uibk-dps-teaching/cluster-coffer/README.md

# Cluster Coffer

See [manual](docs/cluster-coffer.pdf).

See extra fancy [3D PDF](hardware/main-3d.pdf) that works only with Adobe Reader / Acrobat.

Coffer
