uibk-dps-teaching/cluster-coffer/docs/gallery.tex

\chapter{Gallery}

\begin{figure}
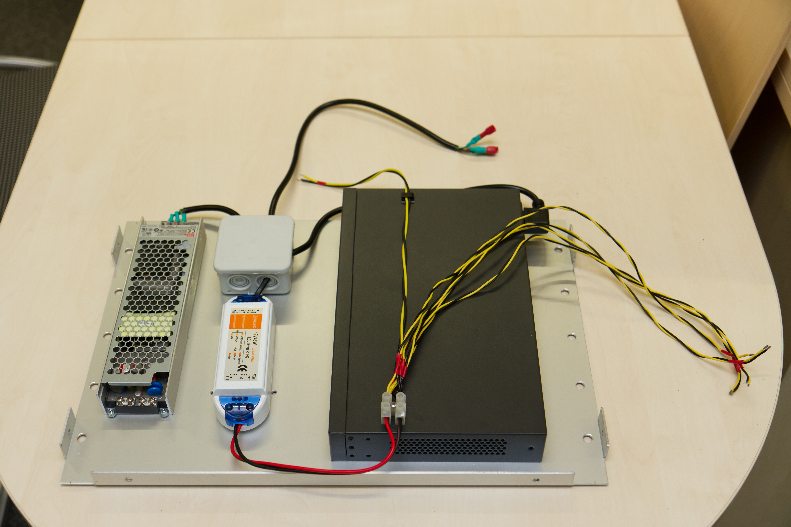
[picture p1: docs/inc/img_9750.jpg]
	
	\caption{Assembled base-plate.}
\end{figure}

\begin{figure}
	
	\caption{Two assembled V-Mount panels.}
\end{figure}

\begin{figure}
	
	\caption{Case backside with plug and switch.}
\end{figure}

\begin{figure}
	
	\caption{Case internals with head node.}
\end{figure}

\begin{figure}
	
	\caption{Assembled V-Mount panels, frame, and base-plate.}
\end{figure}

\begin{figure}
	
	\caption{Fully assembled system.}
\end{figure}
