uibk-dps-teaching/cluster-coffer/docs/inc/drawing_frame_front_nuts.pdf

# Front

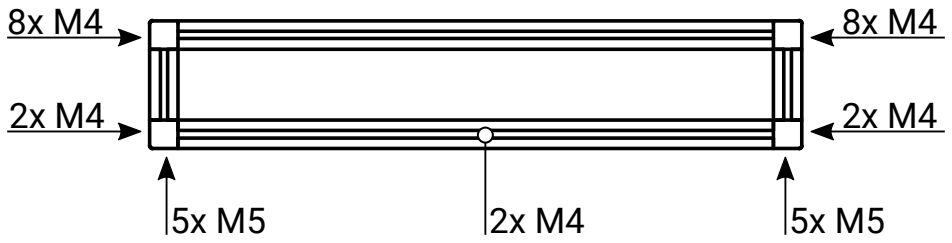
[picture p2: figure]
