uibk-dps-teaching/cluster-coffer/hardware/nanopc_t4/2d/nanopc_t4_bottom.jpg

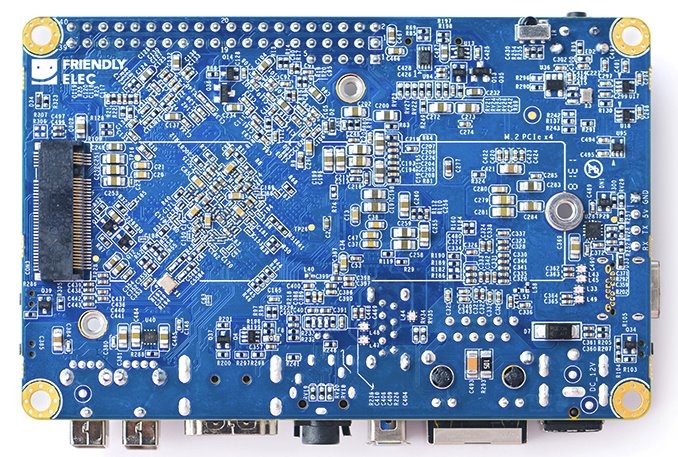
hardware/nanopc_t4/2d/nanopc_t4_bottom.jpg
