uibk-dps-teaching/cluster-coffer/hardware/nanopc_t4/3d/nanopc_t4_bottom_texture.jpg

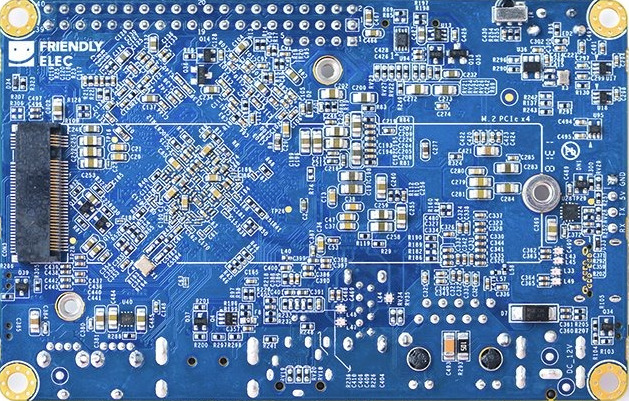
hardware/nanopc_t4/3d/nanopc_t4_bottom_texture.jpg
