uibk-dps-teaching/cluster-coffer/hardware/nanopi_m4/2d/nanopi_m4_bottom.jpg

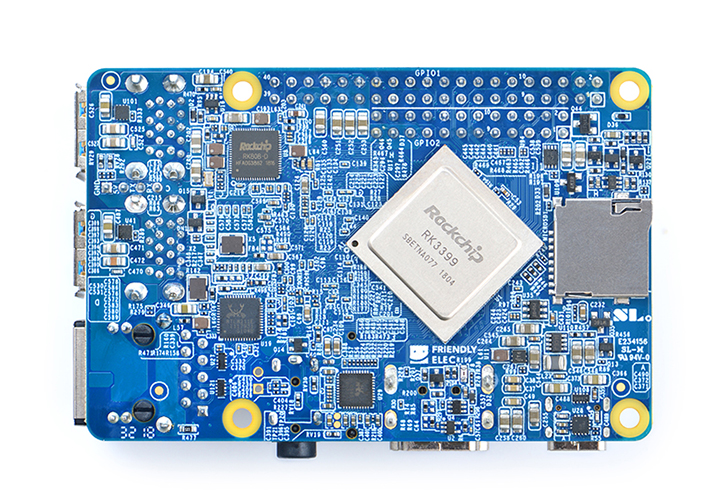
hardware/nanopi_m4/2d/nanopi_m4_bottom.jpg
