uibk-dps-teaching/cluster-coffer/hardware/nanopi_m4/3d/nanopi_m4_bottom_texture.jpg

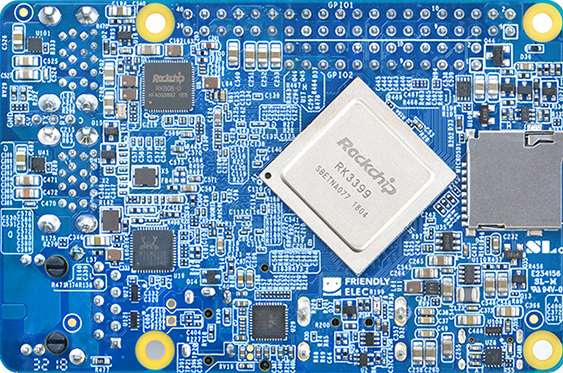
hardware/nanopi_m4/3d/nanopi_m4_bottom_texture.jpg
