uibk-dps-teaching/cluster-coffer/hardware/nanopi_m4/3d/nanopi_m4_top_texture.jpg

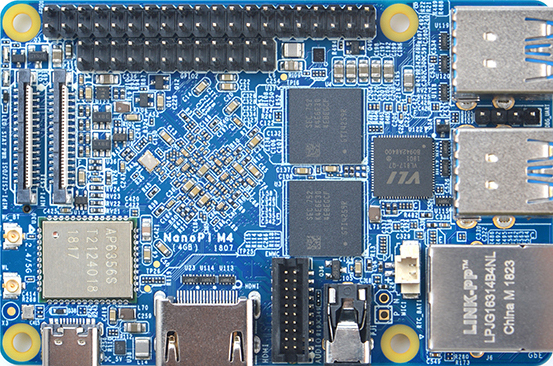
hardware/nanopi_m4/3d/nanopi_m4_top_texture.jpg
