uibk-dps-teaching/cluster-coffer/hardware/nanopi_m4/nanopi_m4_dimensions.png

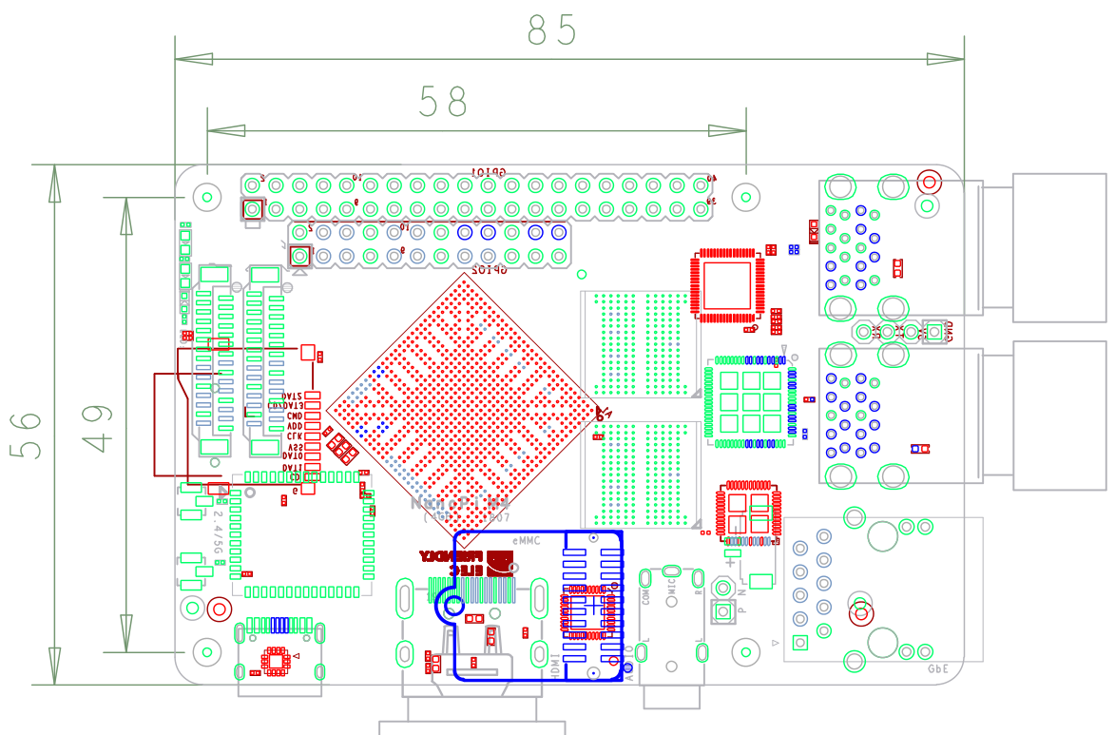
hardware/nanopi_m4/nanopi_m4_dimensions.png
