uibk-dps-teaching/cluster-coffer/hardware/tl_sg1024/2d/tl_sg1024_front.jpg

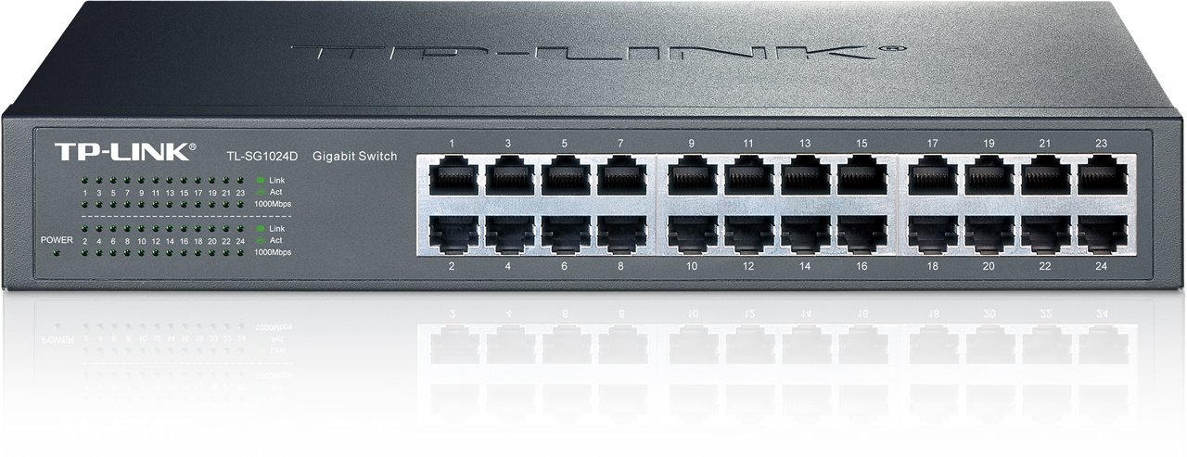
hardware/tl_sg1024/2d/tl_sg1024_front.jpg
