uibk-dps-teaching/cluster-coffer/hardware/tl_sg1024/3d/tl_sg1024_front_texture.jpg

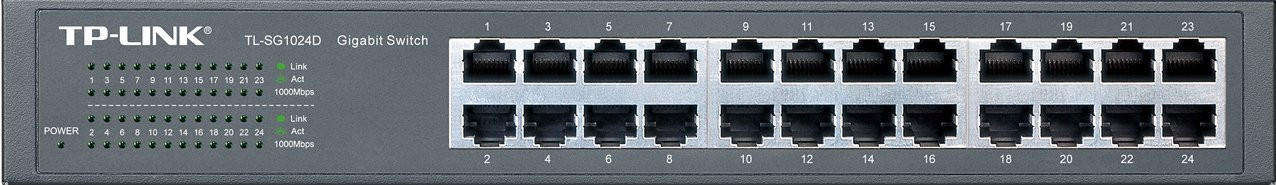
hardware/tl_sg1024/3d/tl_sg1024_front_texture.jpg
