uibk-dps-teaching/cluster-coffer/docs/bom.tex

\chapter{Bill of Materials}
\label{bom}

The following table contains material required for this build.
Minor items (e.g.\ cable ties, screws) and custom made components are omitted.
Prices are approximated.

\begin{center}
\begin{longtable}{llrr}
	\toprule
	\multicolumn{2}{l}{\textbf{Item}} & \textbf{Count} & \textbf{Price (single) €}\\

	\midrule
	\multicolumn{2}{l}{Head Node}\\
	& NanoPC T4 & 1 & 95.00\\
	& Akasa AK-210 Blue Lights Northbridge Kühler & 1 & 10.00\\
	& Akasa AK-TT12-80 Wärmeleitfolie & 1 & 10.00\\
	& Micro SD Card 16GB & 1 & 4.00\\
	& Cat 7 Ethernet Cable 0.50m & 1 & 1.80\\

	\midrule
	\multicolumn{2}{l}{Compute Nodes}\\
	& NanoPI M4 2GB & 16 & 65.00\\
	& NanoPI M4 Heatsink & 16 & 5.00\\
	& Micro SD Card 16GB & 16 & 4.00\\
	& 40mm Fan (12V, 3 Pin Connector) & 16 & 6.00\\
	& Cat 7 Ethernet Cable 0.25m & 8 & 1.60\\
	& Cat 7 Ethernet Cable 0.50m & 8 & 1.80\\

	\midrule
	\multicolumn{2}{l}{Switch}\\
	& TP-Link TL-SG1024D & 1 & 70.00\\

	\midrule
	\multicolumn{2}{l}{Power}\\
	& AC Switching Power Supply 5V 300W & 1 & 60.00\\
	& AC Switching Power Supply 12V 48W & 1 & 8.00\\
	& Mains Power Socket Connector (with Switch and Fuse) & 1 & 5.00\\

	\midrule
	\multicolumn{2}{l}{Frame}\\
	& HFS5 2020 420mm (both ends tapped) & 2 & 6.00\\
	& HFS5 2020 280mm (both ends tapped) & 4 & 6.00\\
	& HFS5 2020 50mm (both ends tapped) & 4 & 6.00\\
	& HNUT5-4 M4 Nut (with spring) & 22 & 0.50\\
	& HNUT5-5 M5 Nut (with spring) & 10 & 0.50\\
	& HBLCS5-B Edge Connector 2-Way & 4 & 4.00\\
	& HBLCR5-B Edge Connector 3-Way & 4 & 4.00\\

	\midrule
	\multicolumn{2}{l}{Case}\\
	& Aluminium Suitcase (inner dimensions $486 \times 346 \times 195$ mm) & 1 & 80.00\\

	\bottomrule
\end{longtable}
\end{center}
