uibk-dps-teaching/cluster-coffer/hardware/nanopc_t4/nanopc_t4_pcb.dxf

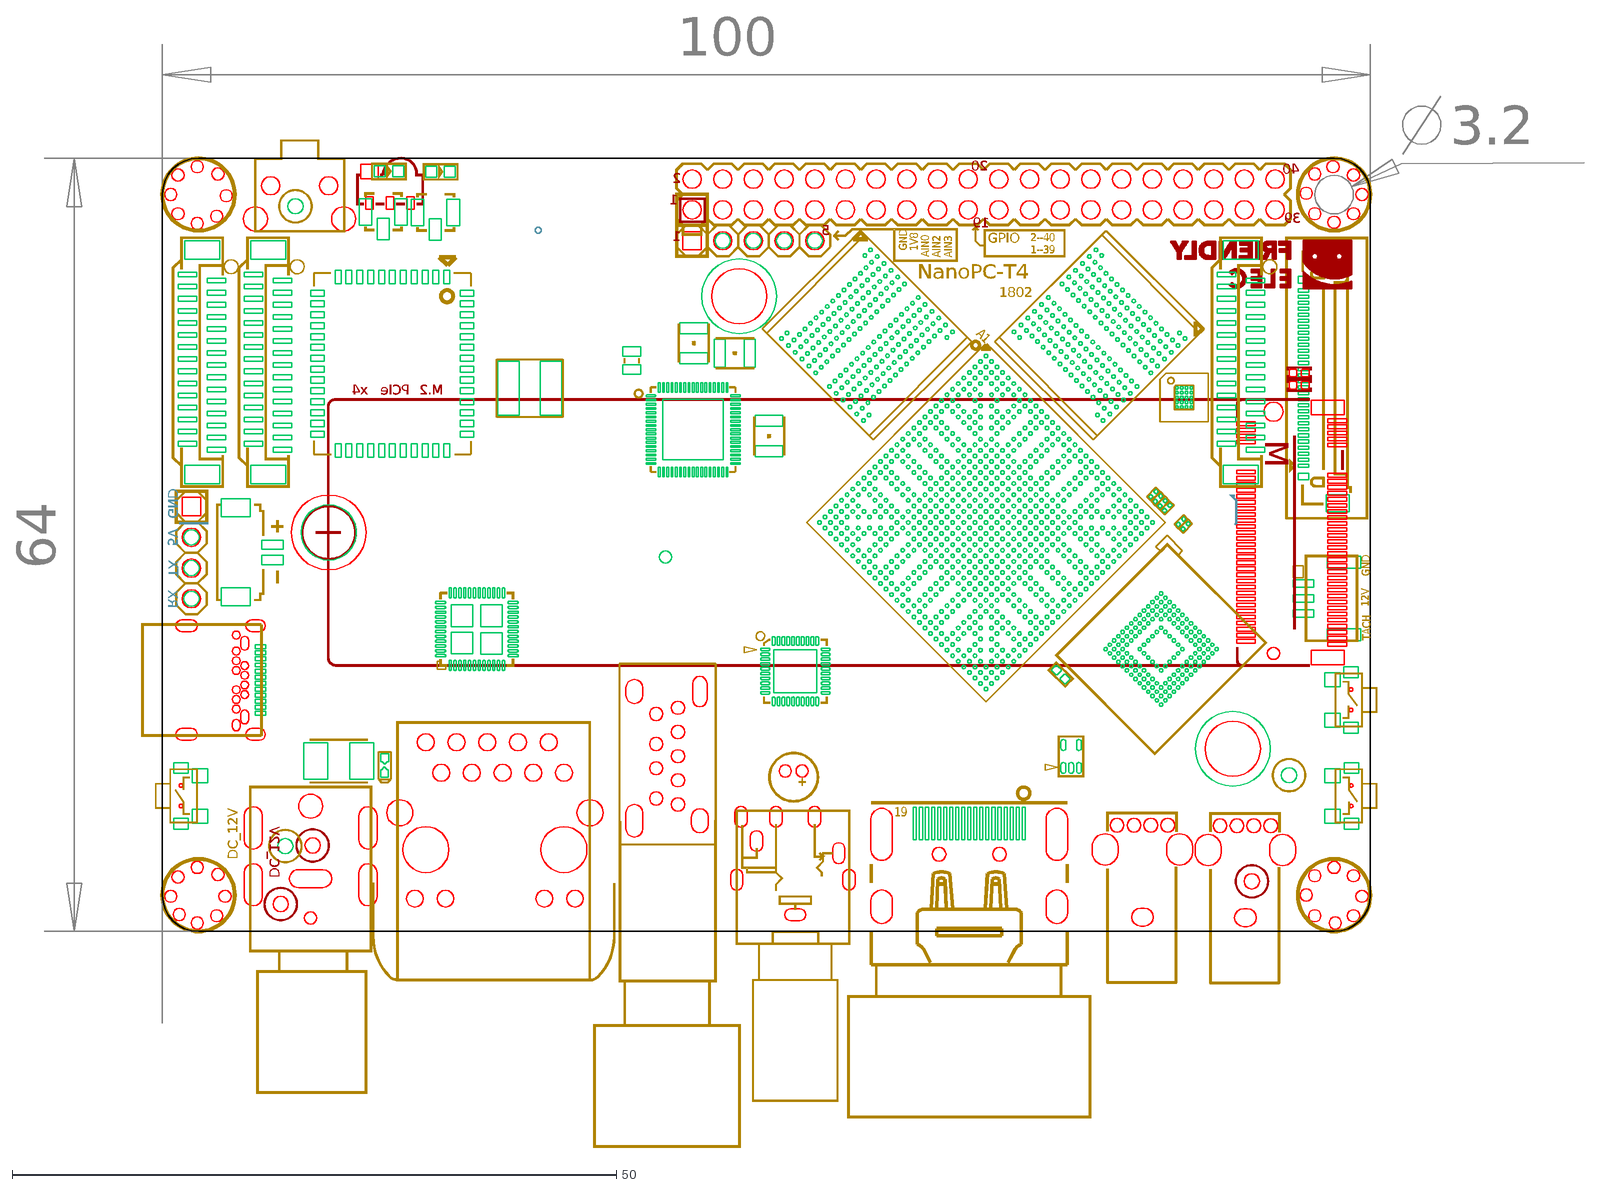
[picture p15: CAD file, 2020-08-14]
hardware/nanopc_t4/nanopc_t4_pcb.dxf
3.2
M
64
100
19
A1
AIN3
AIN2
AIN0
1V8
GND
TACH
12V
DC_12V
x4
M.2
PCIe
1--39
2--40
GPIO
5
20
1
40
39
2
RX
TX
5V
1802
NanoPC-T4
