uibk-dps-teaching/cluster-coffer/hardware/nanopi_m4/nanopi_m4_pcb.dxf

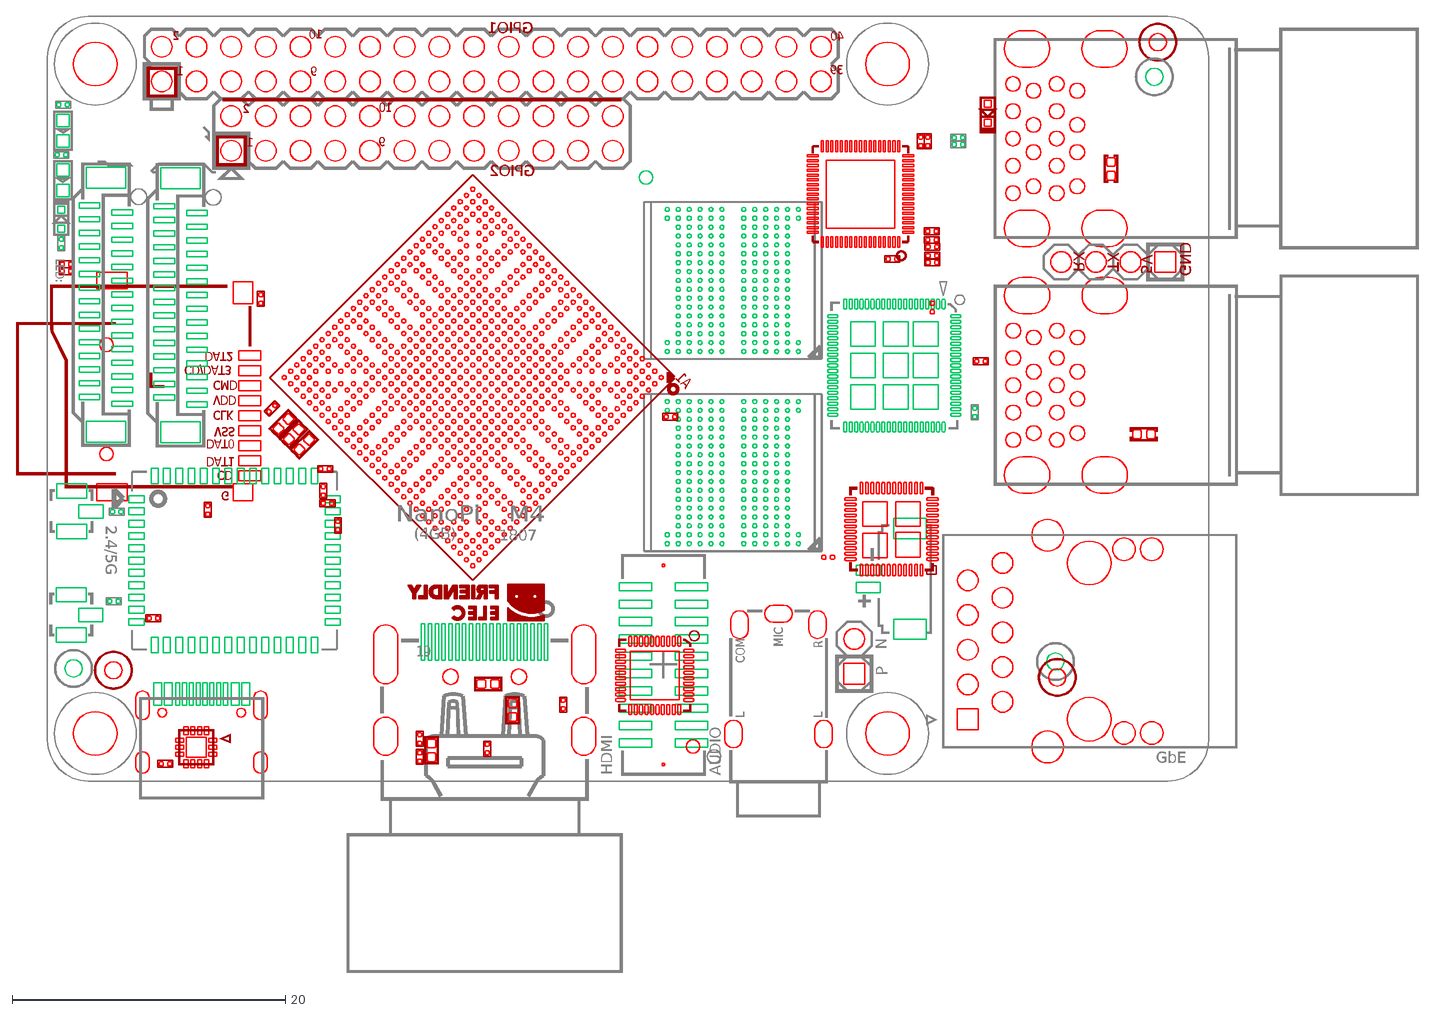
[picture p16: CAD file, 2020-08-14]
hardware/nanopi_m4/nanopi_m4_pcb.dxf
DAT2
CD/DAT3
CMD
VDD
CLK
VSS
DAT0
DAT1
CD
G
19
A1
L
R
COM
MIC
N
P
(4GB)
39
40
10
9
GPIO2
GPIO1
2
1
2.4/5G
LED:
M4
1807
NanoPi
V
RX
TX
5
GND
HDMI
GbE
AUDIO
