uibk-dps-teaching/cluster-coffer/(list of files, cad)

Other CAD files:
docs/inc/drawing_frame.idw
hardware/12v_psu.ipt
hardware/5v_psu.ipt
hardware/base.iam
hardware/base_plate.idw
hardware/base_plate.ipt
hardware/ccpdu.ipt
hardware/components/pcb_switch.ipt
hardware/frame.iam
hardware/frame/8020 Metric 00000001.ipt
hardware/frame/8020 Metric 00000002.ipt
hardware/frame/8020 Metric 00000003.ipt
hardware/frame/8020 Metric 00000004.ipt
hardware/frame/8020 Metric 00000005.ipt
hardware/frame/8020 Metric 00000006.ipt
hardware/frame/8020 Metric 00000007.ipt
hardware/frame/8020 Metric 00000008.ipt
hardware/frame/8020 Metric 00000009.ipt
hardware/frame/8020 Metric 00000010.ipt
hardware/frame/8020 Metric 00000011.ipt
hardware/frame/8020 Metric 00000012.ipt
hardware/frame/Frame0001.iam
hardware/frame/Skeleton0001.ipt
hardware/frame/boundingbox.ipt
hardware/frame/corner.ipt
hardware/main.iam
hardware/nanopc_t4/3d/nanopc_t4.iam
hardware/nanopc_t4/3d/nanopc_t4.skp
hardware/nanopc_t4/3d/nanopc_t4_board.ipt
hardware/nanopc_t4/3d/nanopc_t4_cover.ipt
hardware/nanopc_t4/3d/nanopc_t4_hdmi.ipt
hardware/nanopc_t4/3d/nanopc_t4_headphone.ipt
hardware/nanopc_t4/3d/nanopc_t4_pin.ipt
hardware/nanopc_t4/3d/nanopc_t4_pwr.ipt
hardware/nanopc_t4/3d/nanopc_t4_rj45.ipt
hardware/nanopc_t4/3d/nanopc_t4_spacer_long.ipt
hardware/nanopc_t4/3d/nanopc_t4_usb.ipt
hardware/nanopc_t4/3d/nanopc_t4_usb3.ipt
hardware/nanopc_t4/3d/nanopc_t4_usb3c.ipt
hardware/nanopi_m4/3d/ccpad.ipt
hardware/nanopi_m4/3d/nanopi_m4.iam
hardware/nanopi_m4/3d/nanopi_m4_board.ipt
hardware/nanopi_m4/3d/nanopi_m4_hdmi.ipt
hardware/nanopi_m4/3d/nanopi_m4_headphone.ipt
hardware/nanopi_m4/3d/nanopi_m4_heatsink.ipt
hardware/nanopi_m4/3d/nanopi_m4_pin.ipt
hardware/nanopi_m4/3d/nanopi_m4_rj45.ipt
hardware/nanopi_m4/3d/nanopi_m4_usb.ipt
hardware/nanopi_m4/3d/nanopi_m4_usb3c.ipt
hardware/power_conduit_box.ipt
hardware/rack.iam
hardware/tl_sg1024/3d/tl_sg1024.ipt
hardware/tl_sg1024/3d/tl_sg1024.skp
hardware/v_mount.idw
hardware/v_mount.ipt
