uibk-dps-teaching/cluster-coffer/hardware/nanopc_t4/nanopc_t4_schematic.pdf

# NanoPC T4

# Revision

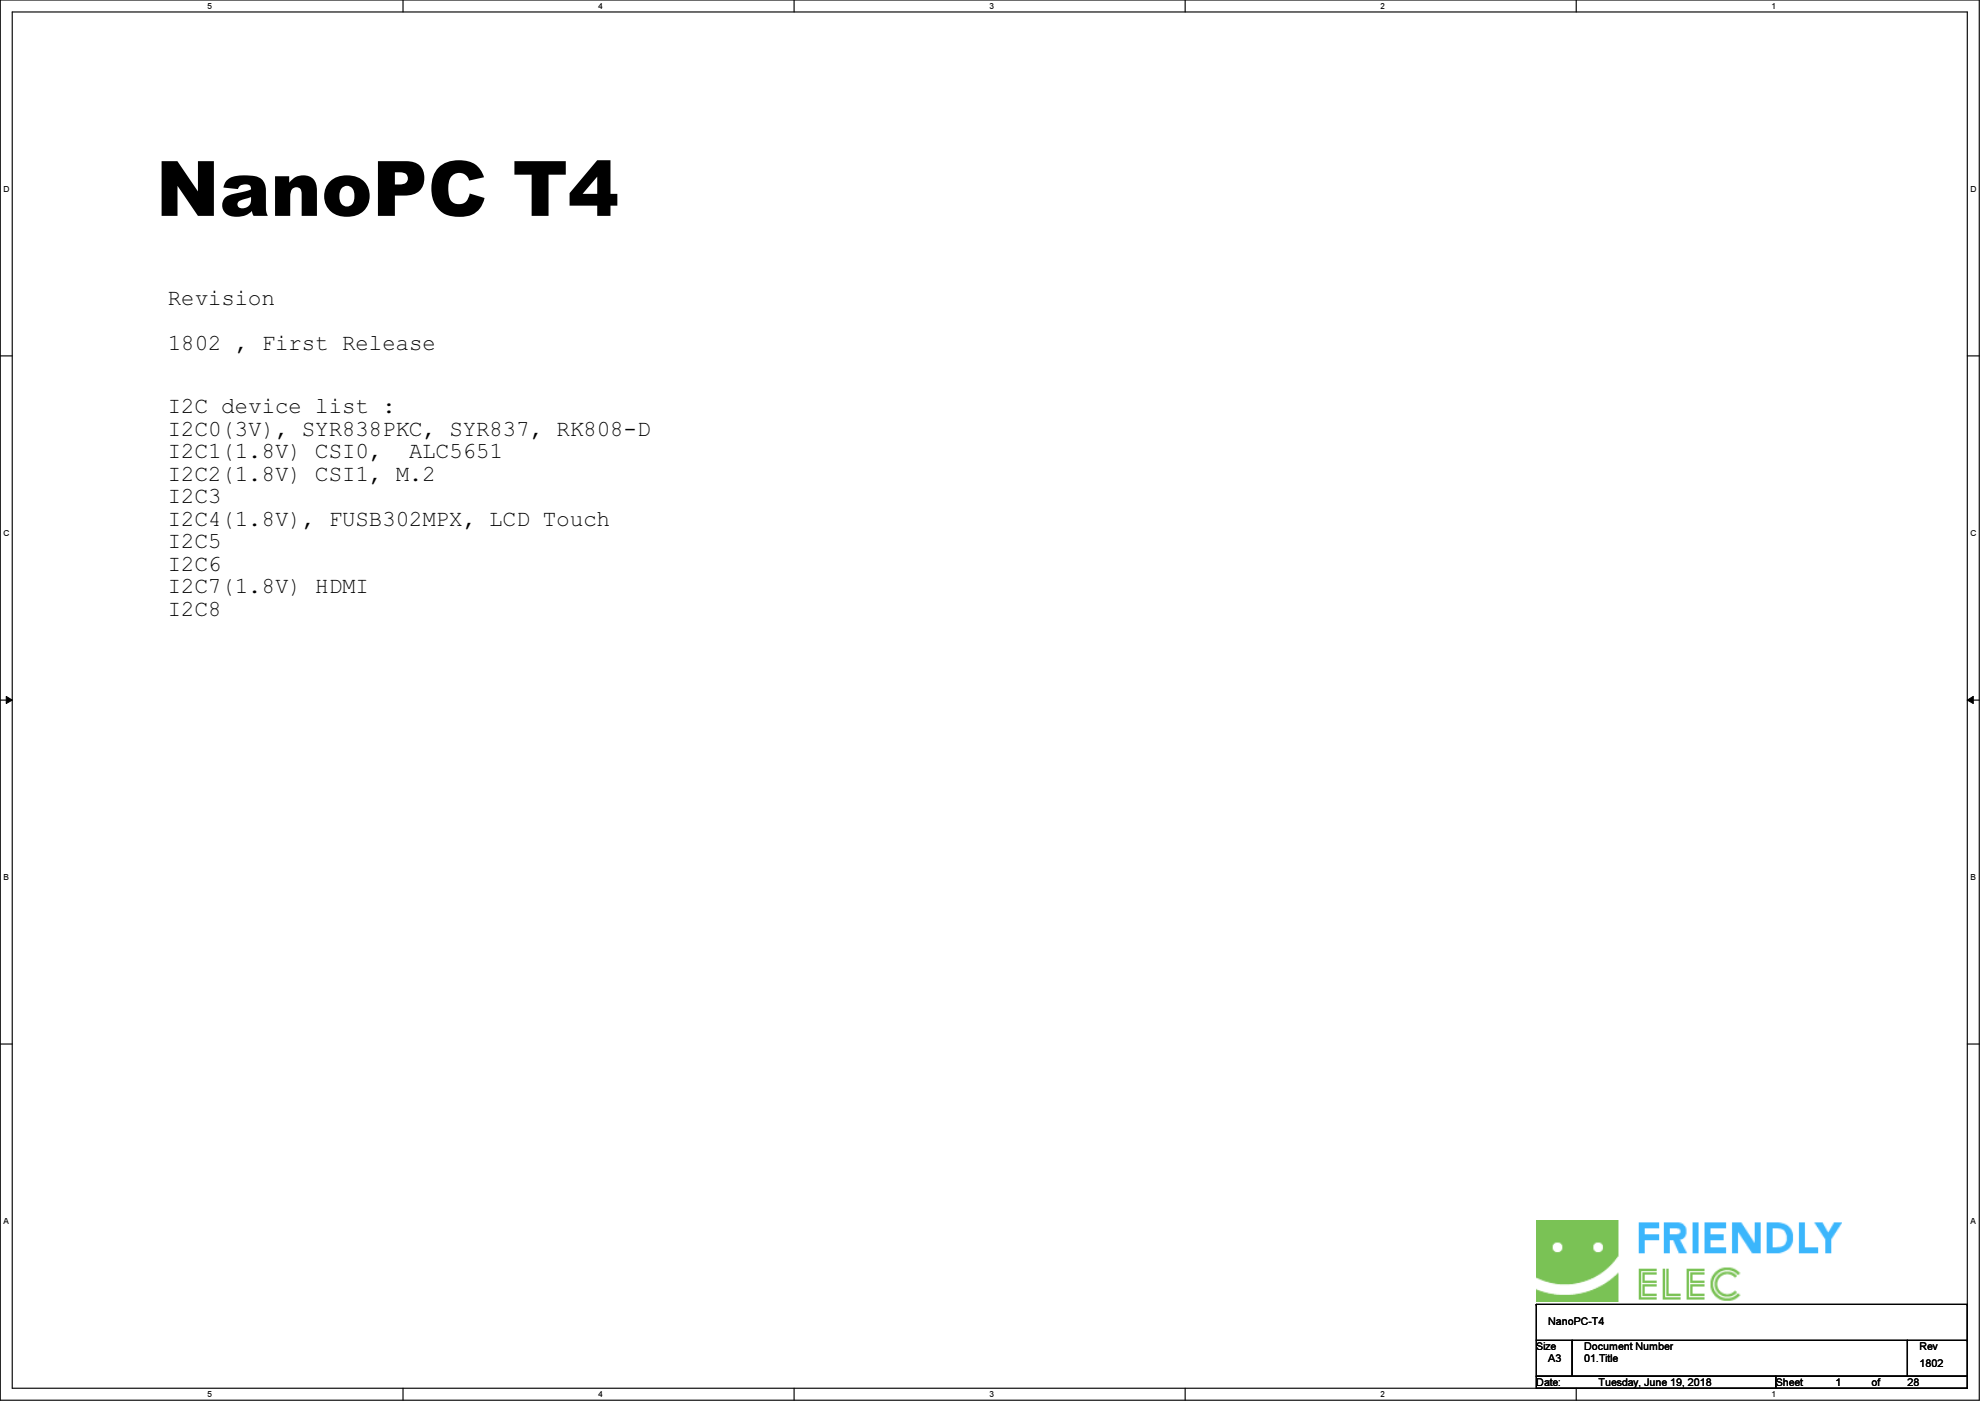
[picture p17: page 1]
1802 , First Release; I2C device list : I2C0(3V), SYR838PKC, SYR837, RK808-D; I2C1(1.8V) CSI0,; ALC5651; I2C2(1.8V) CSI1, M.2 I2C3 I2C4(1.8V), FUSB302MPX, LCD Touch I2C5 I2C6 I2C7(1.8V) HDMI I2C8; Size; Document Number; Rev; Date:; Sheet; 01.Title; NanoPC-T4; Tuesday, June 19, 2018

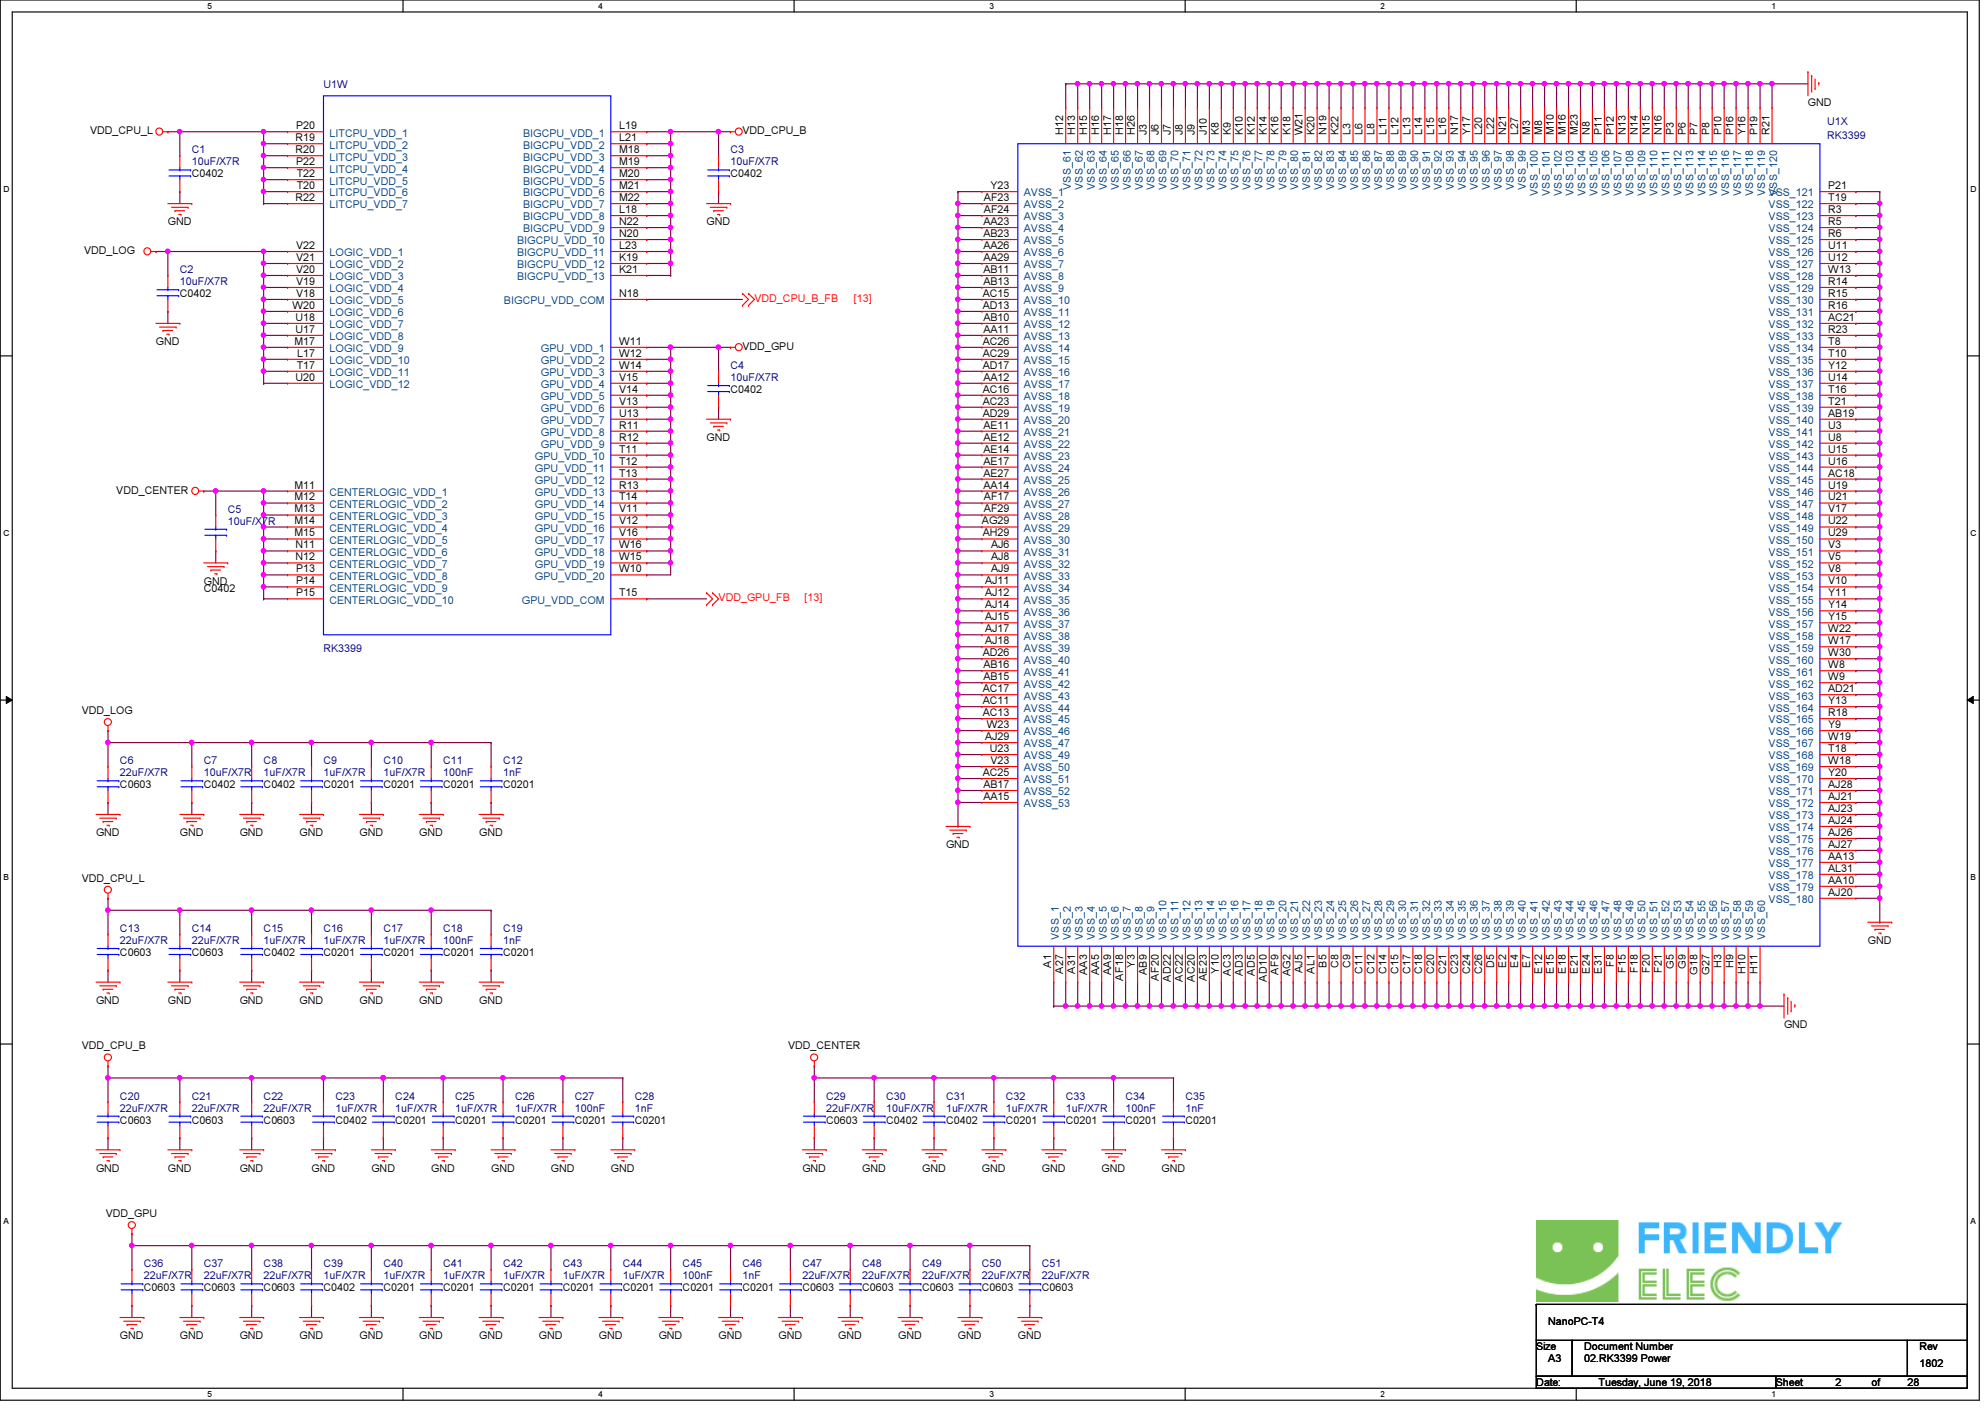
[picture p18: page 2]

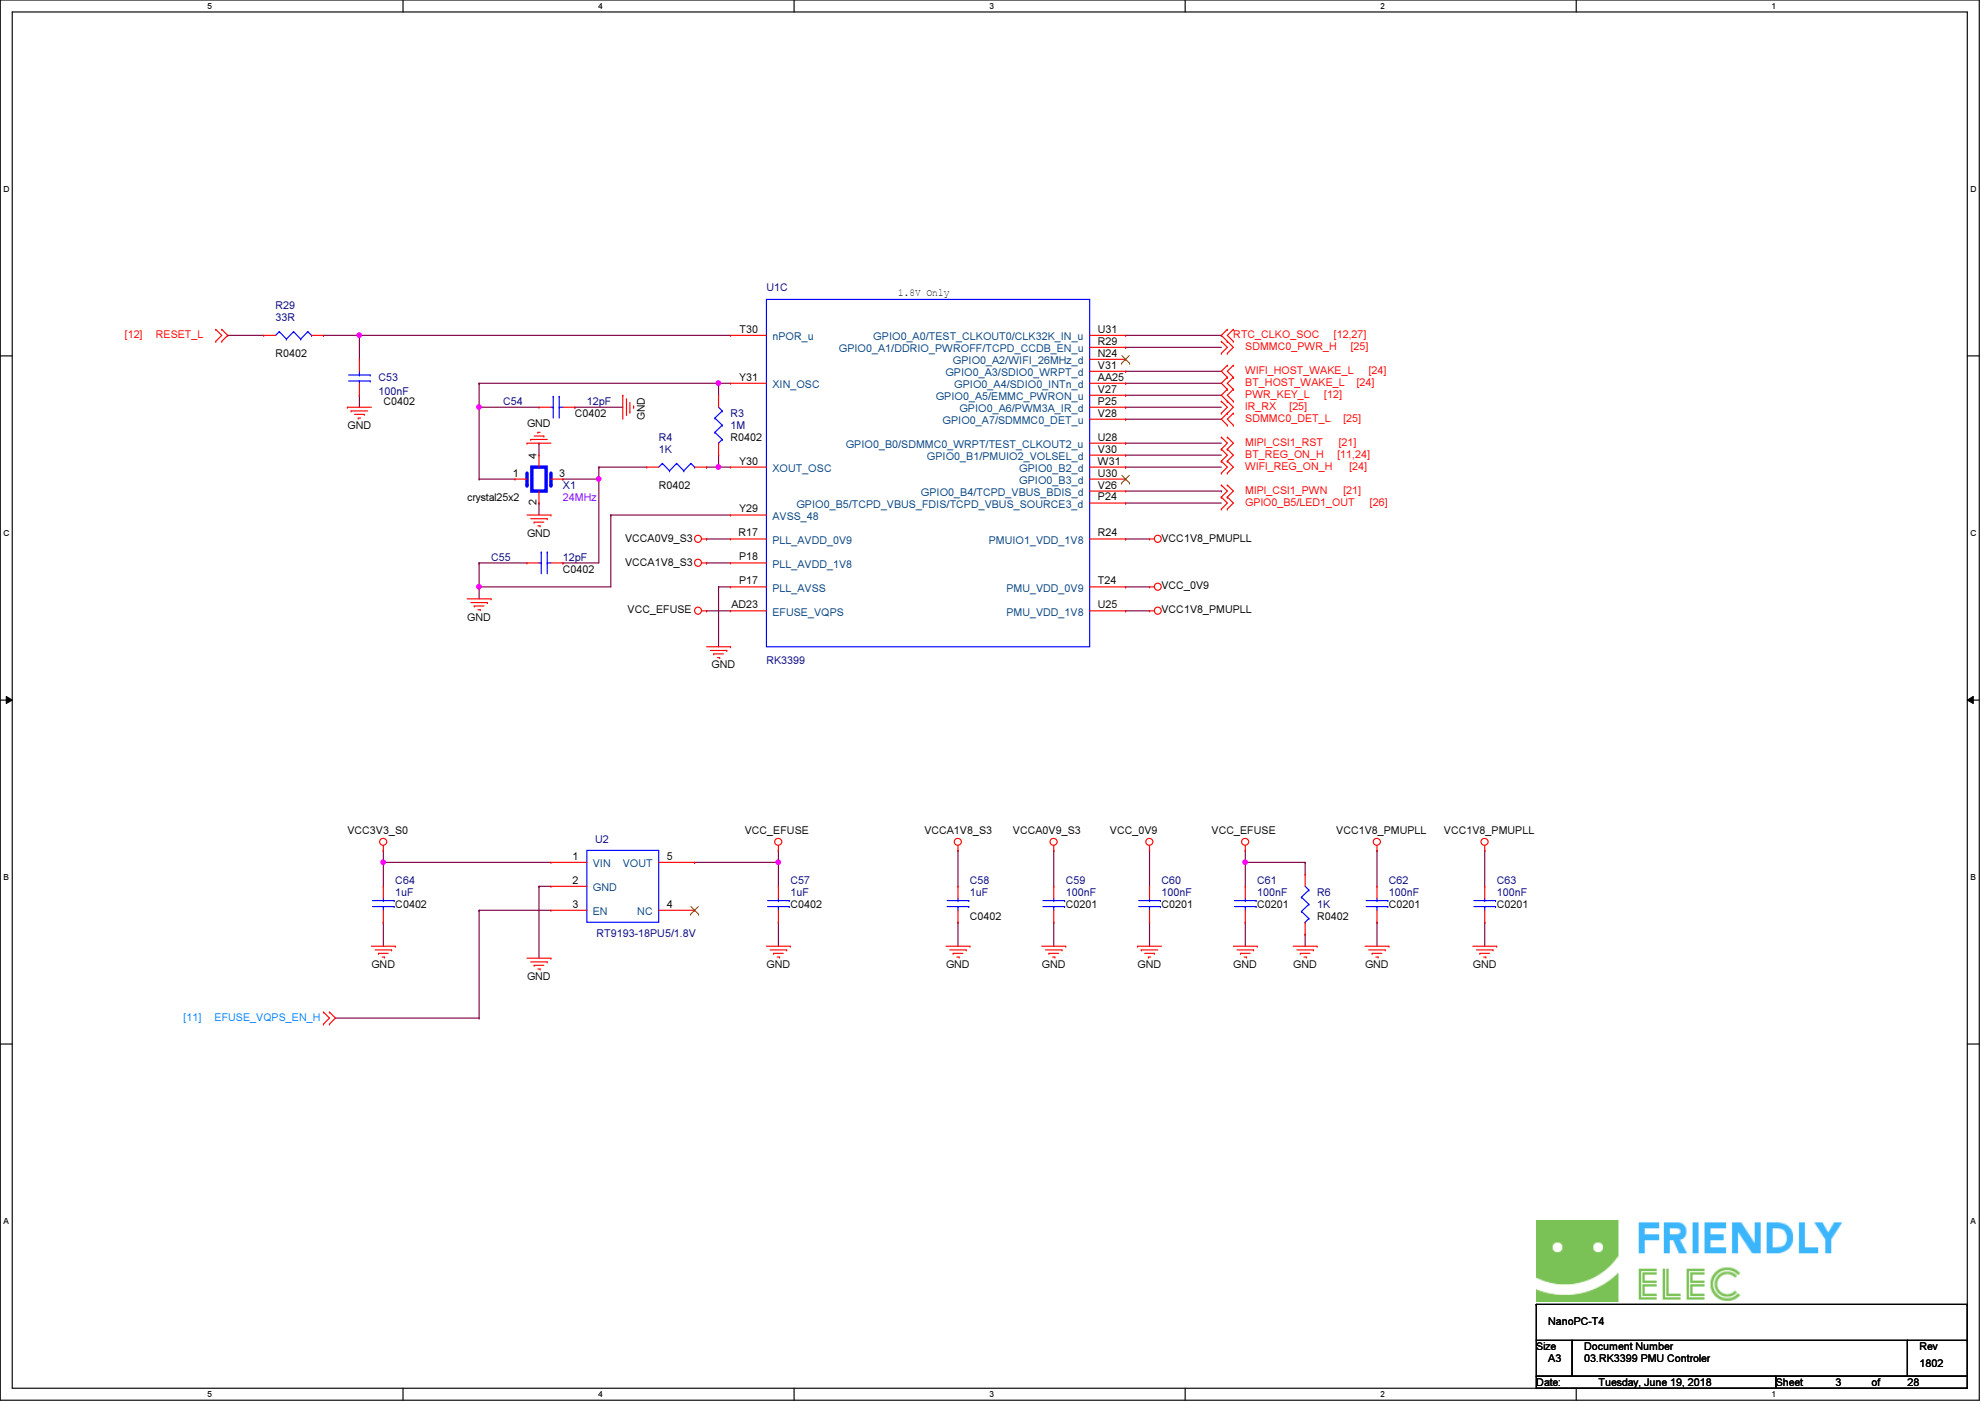
[picture p19: page 3]

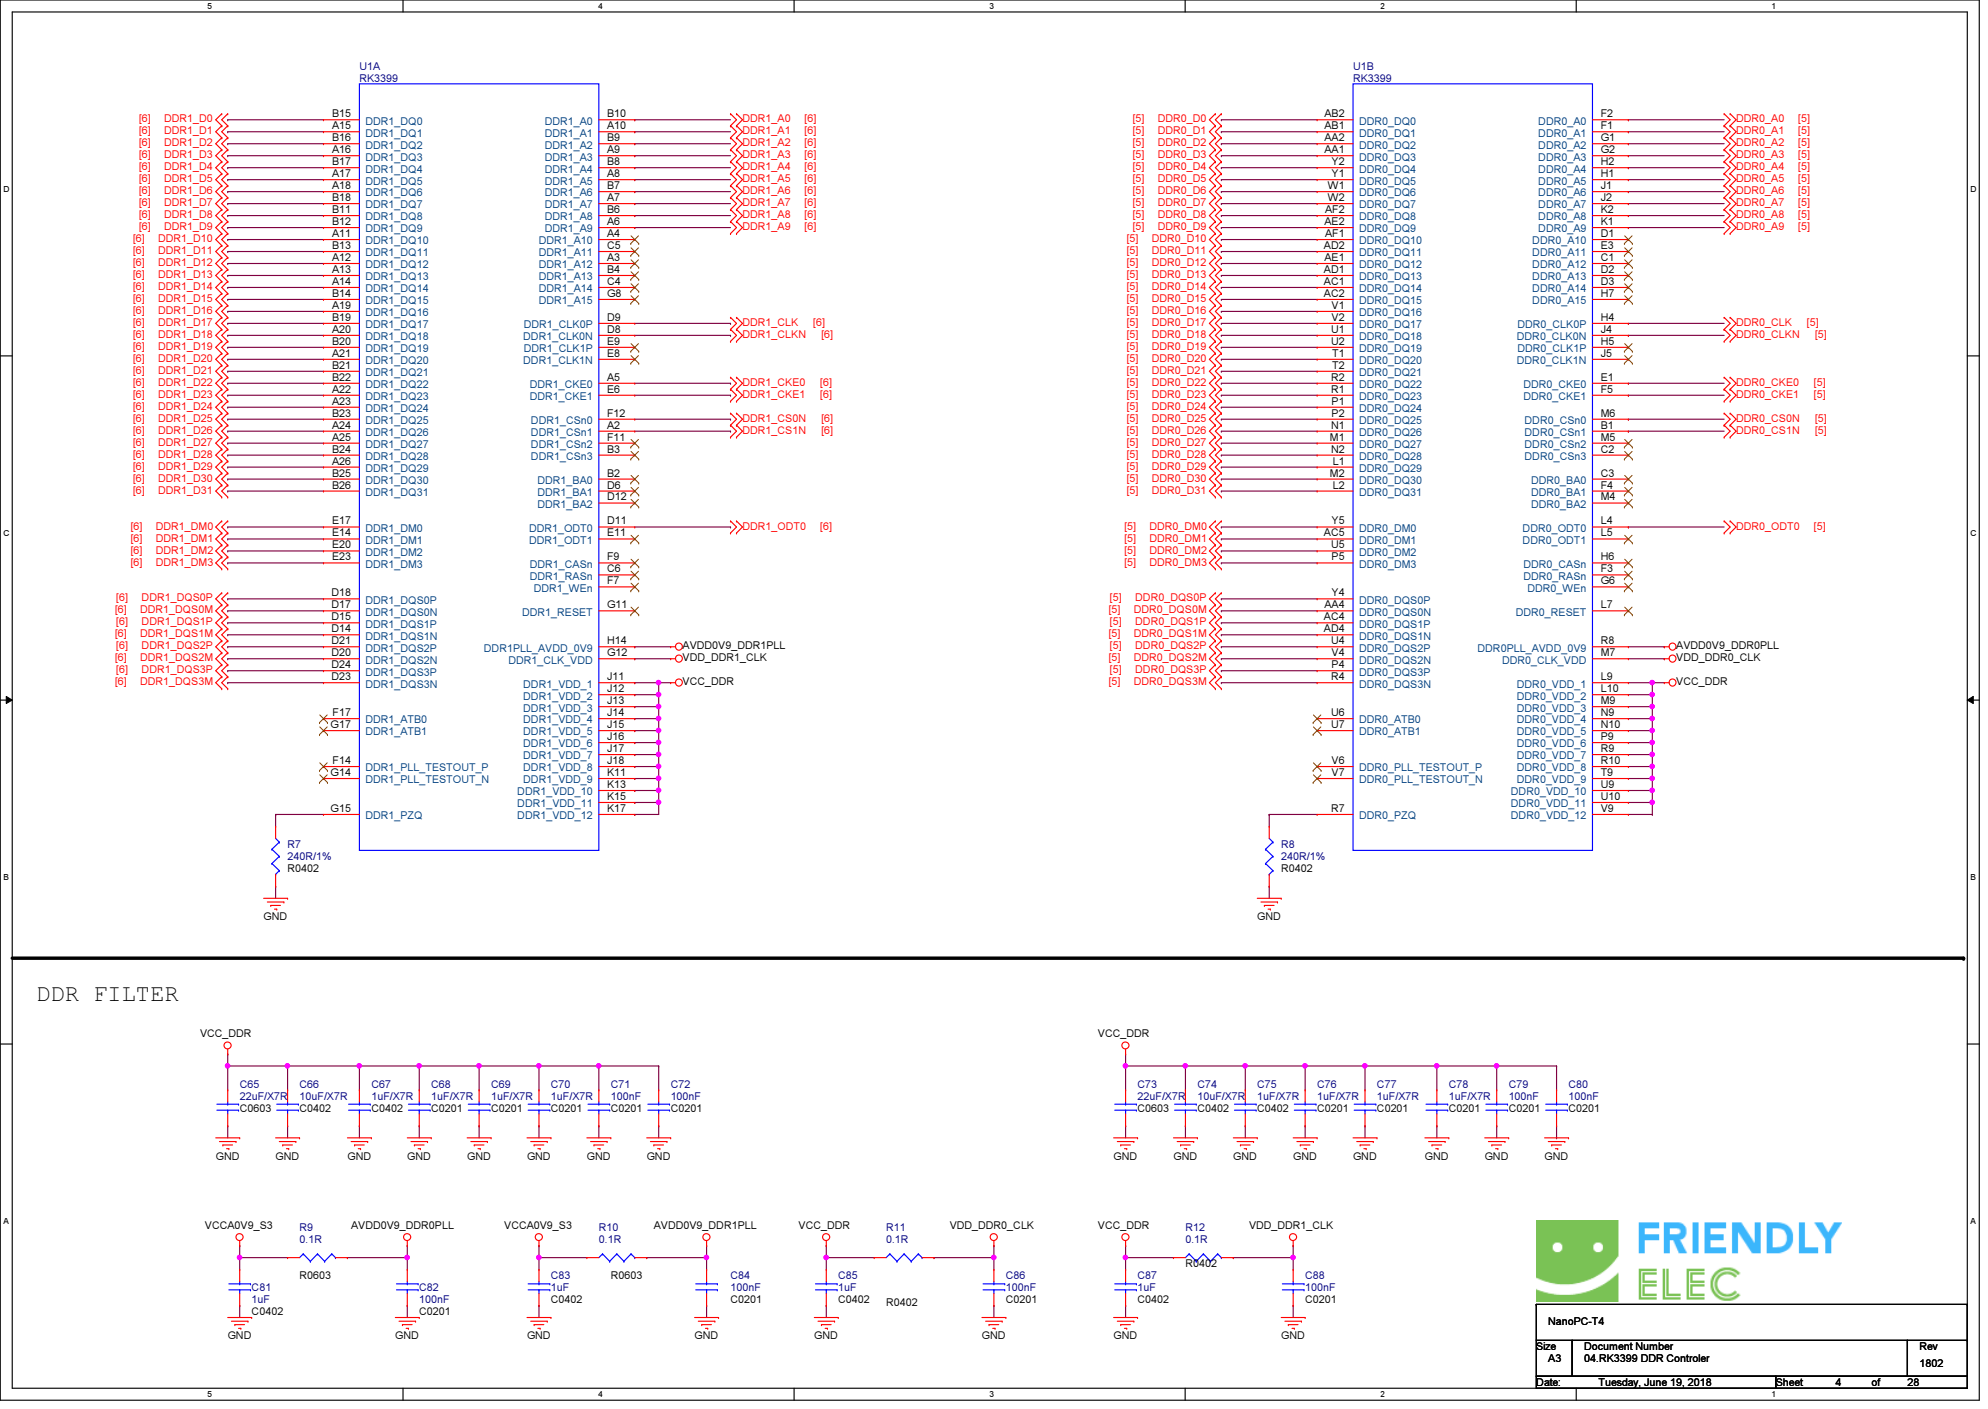
[picture p20: page 4]

D | D

# LPDDR3

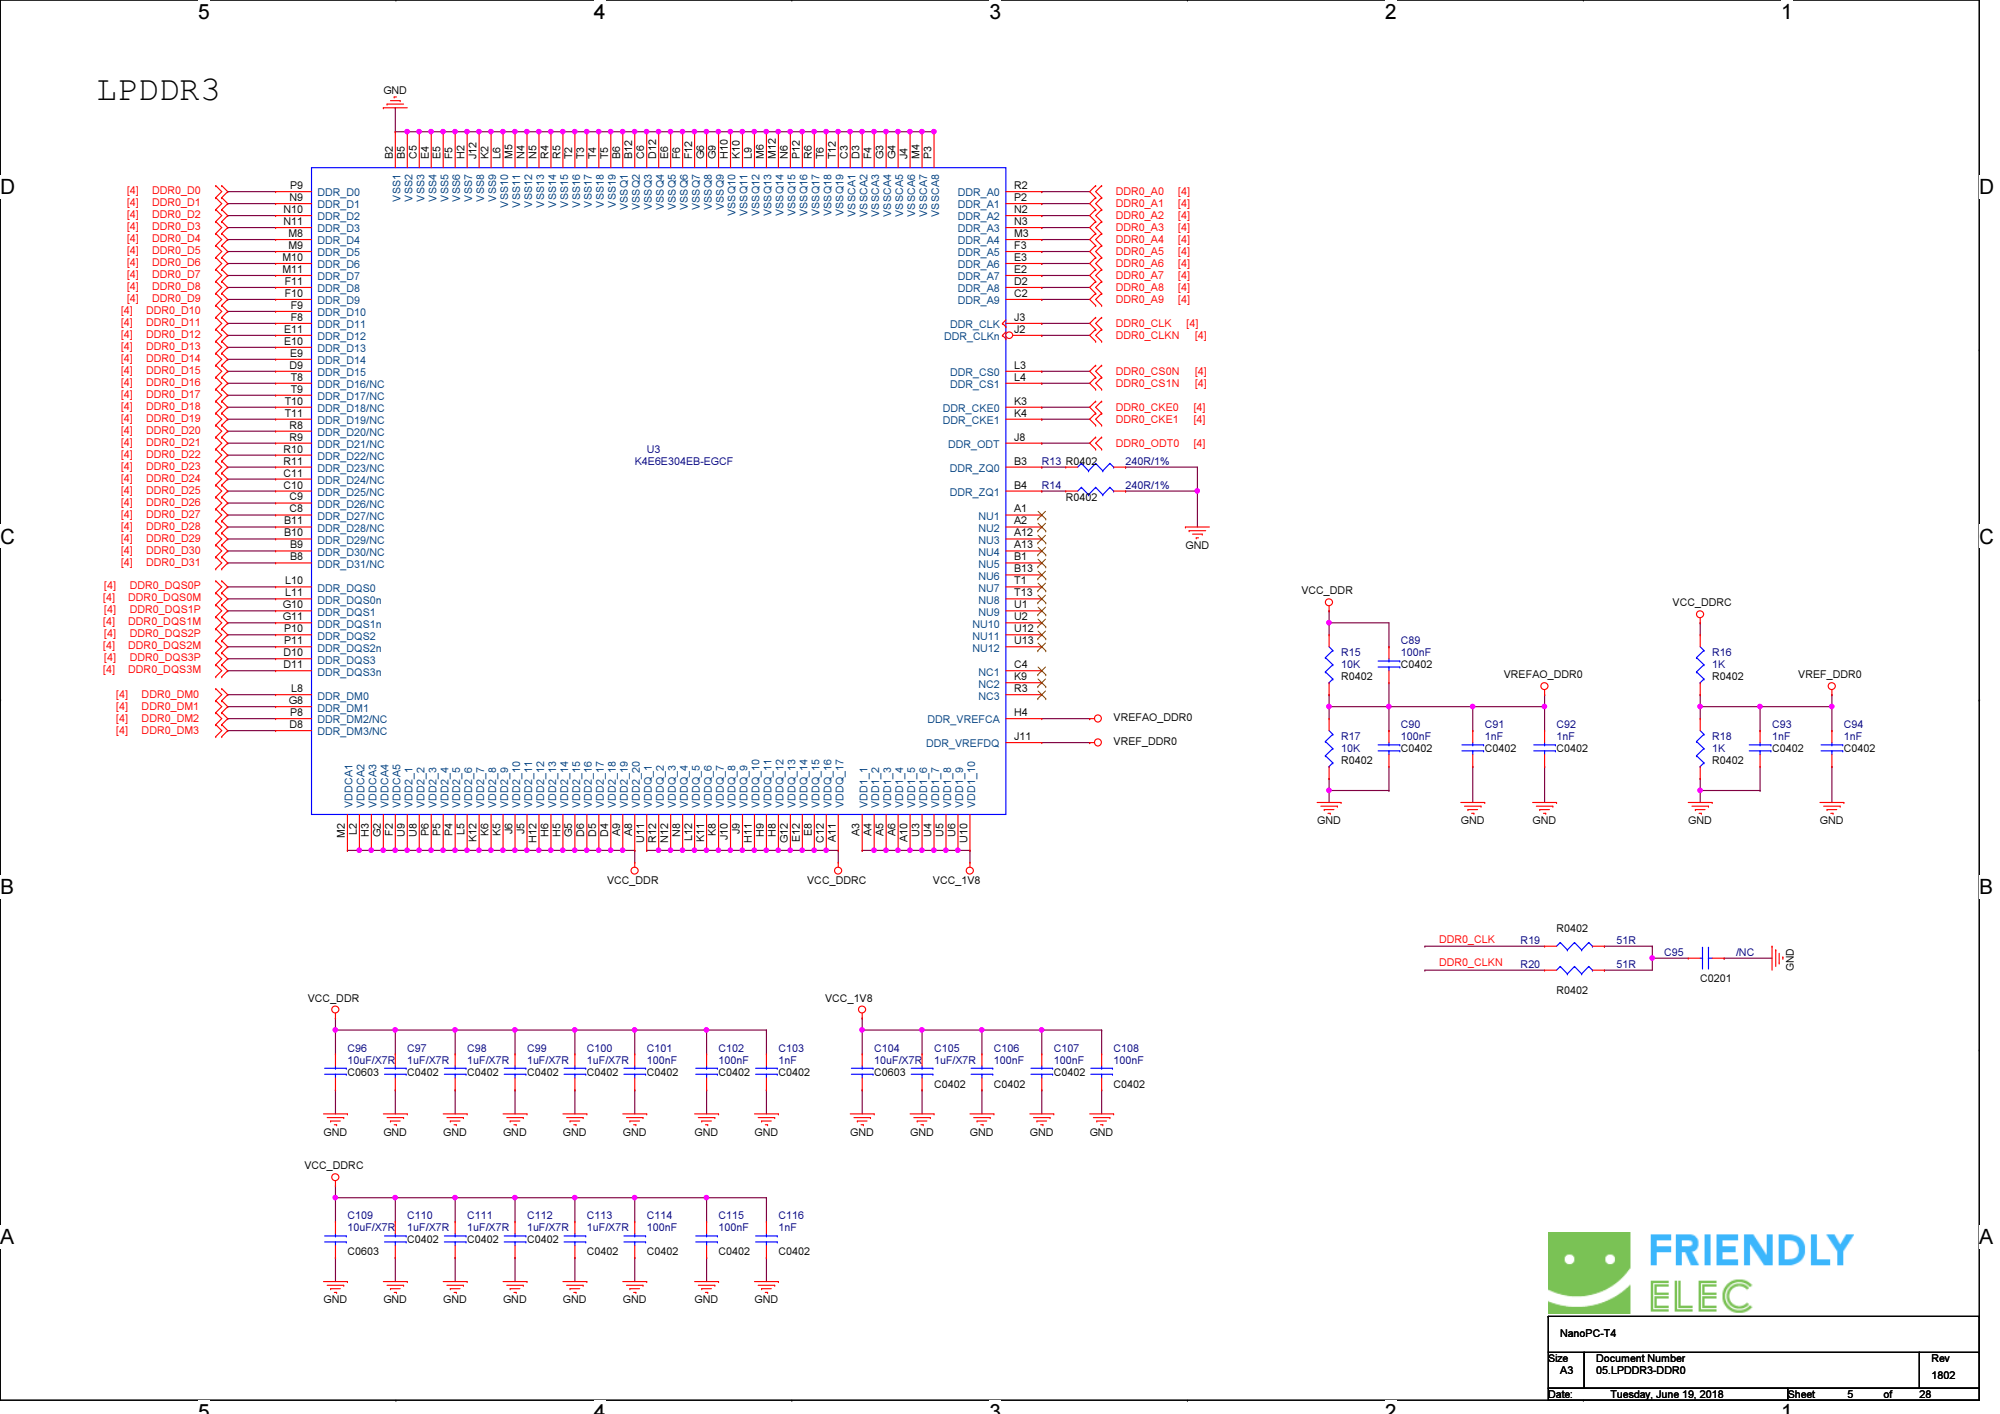
[picture p21: page 5]

D | D

# LPDDR3

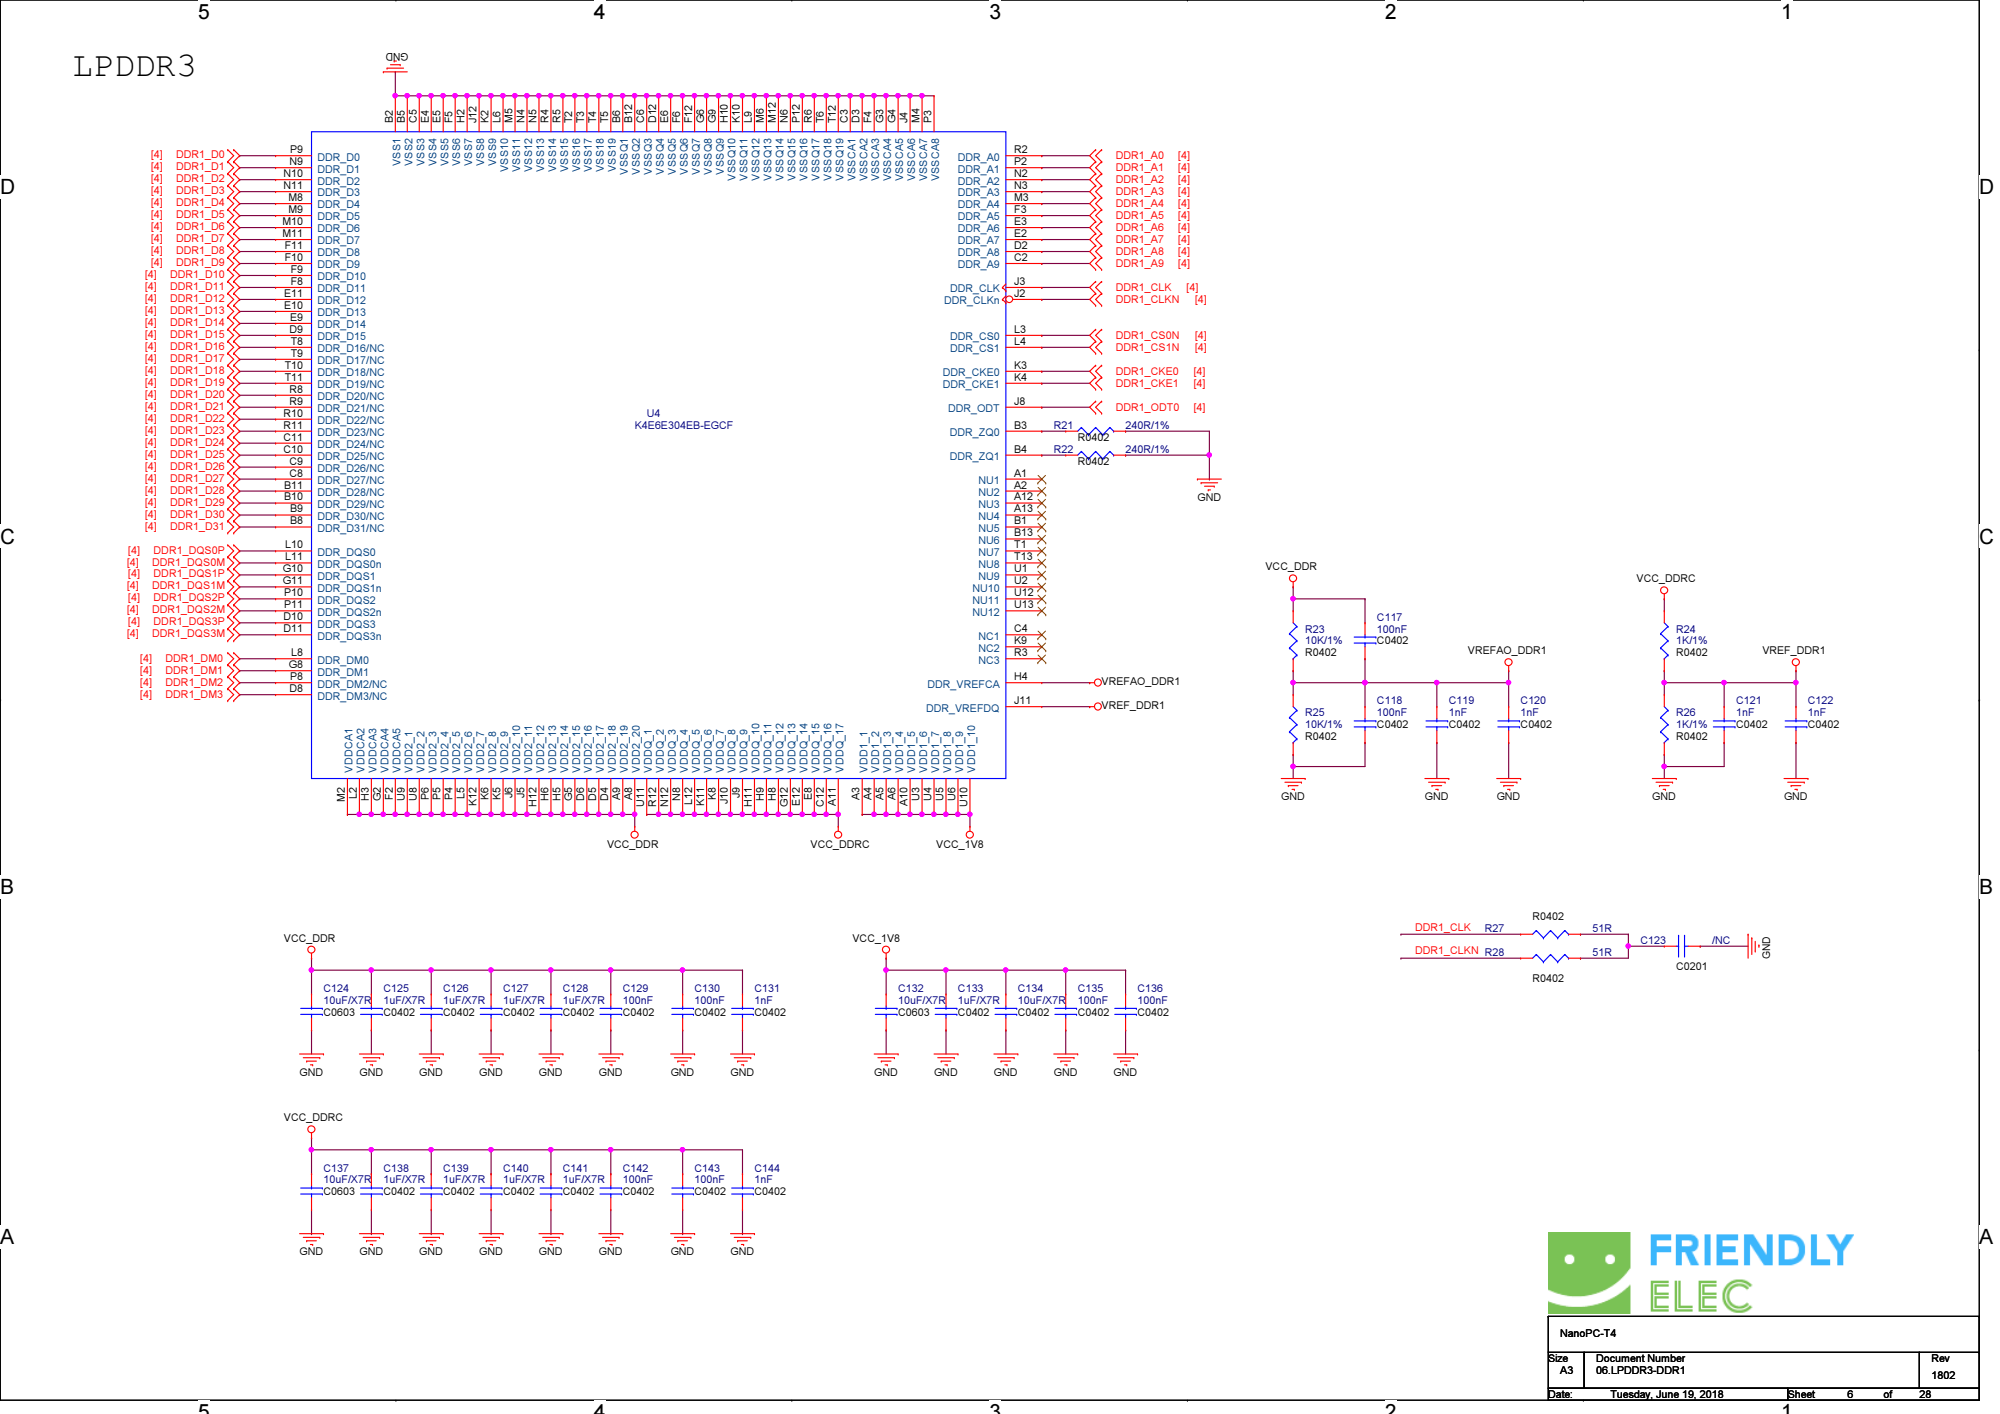
[picture p22: page 6]

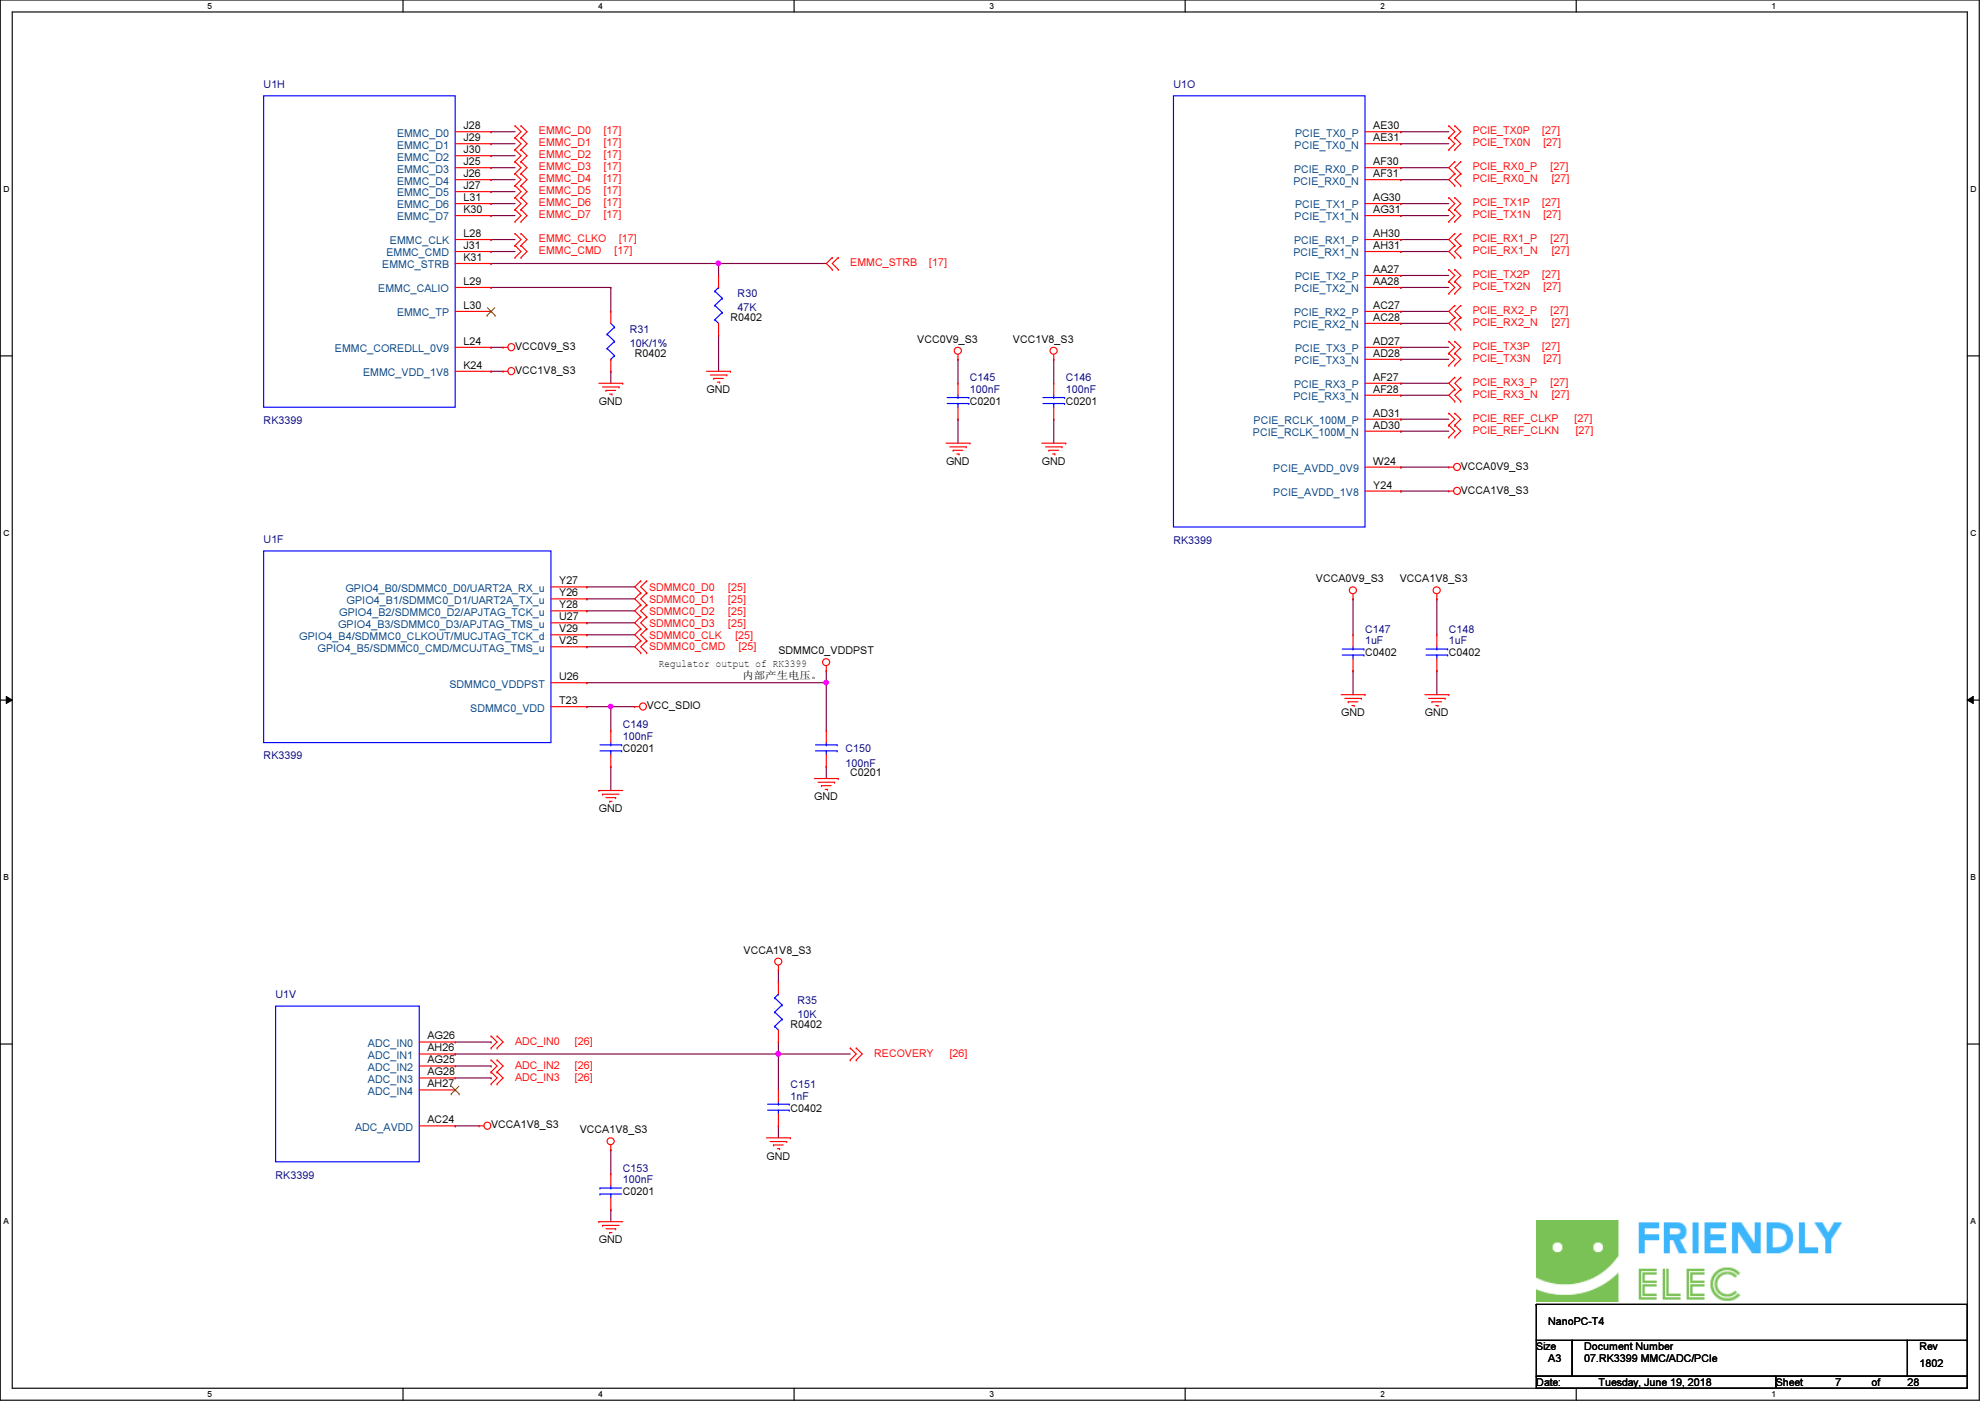
[picture p23: page 7]

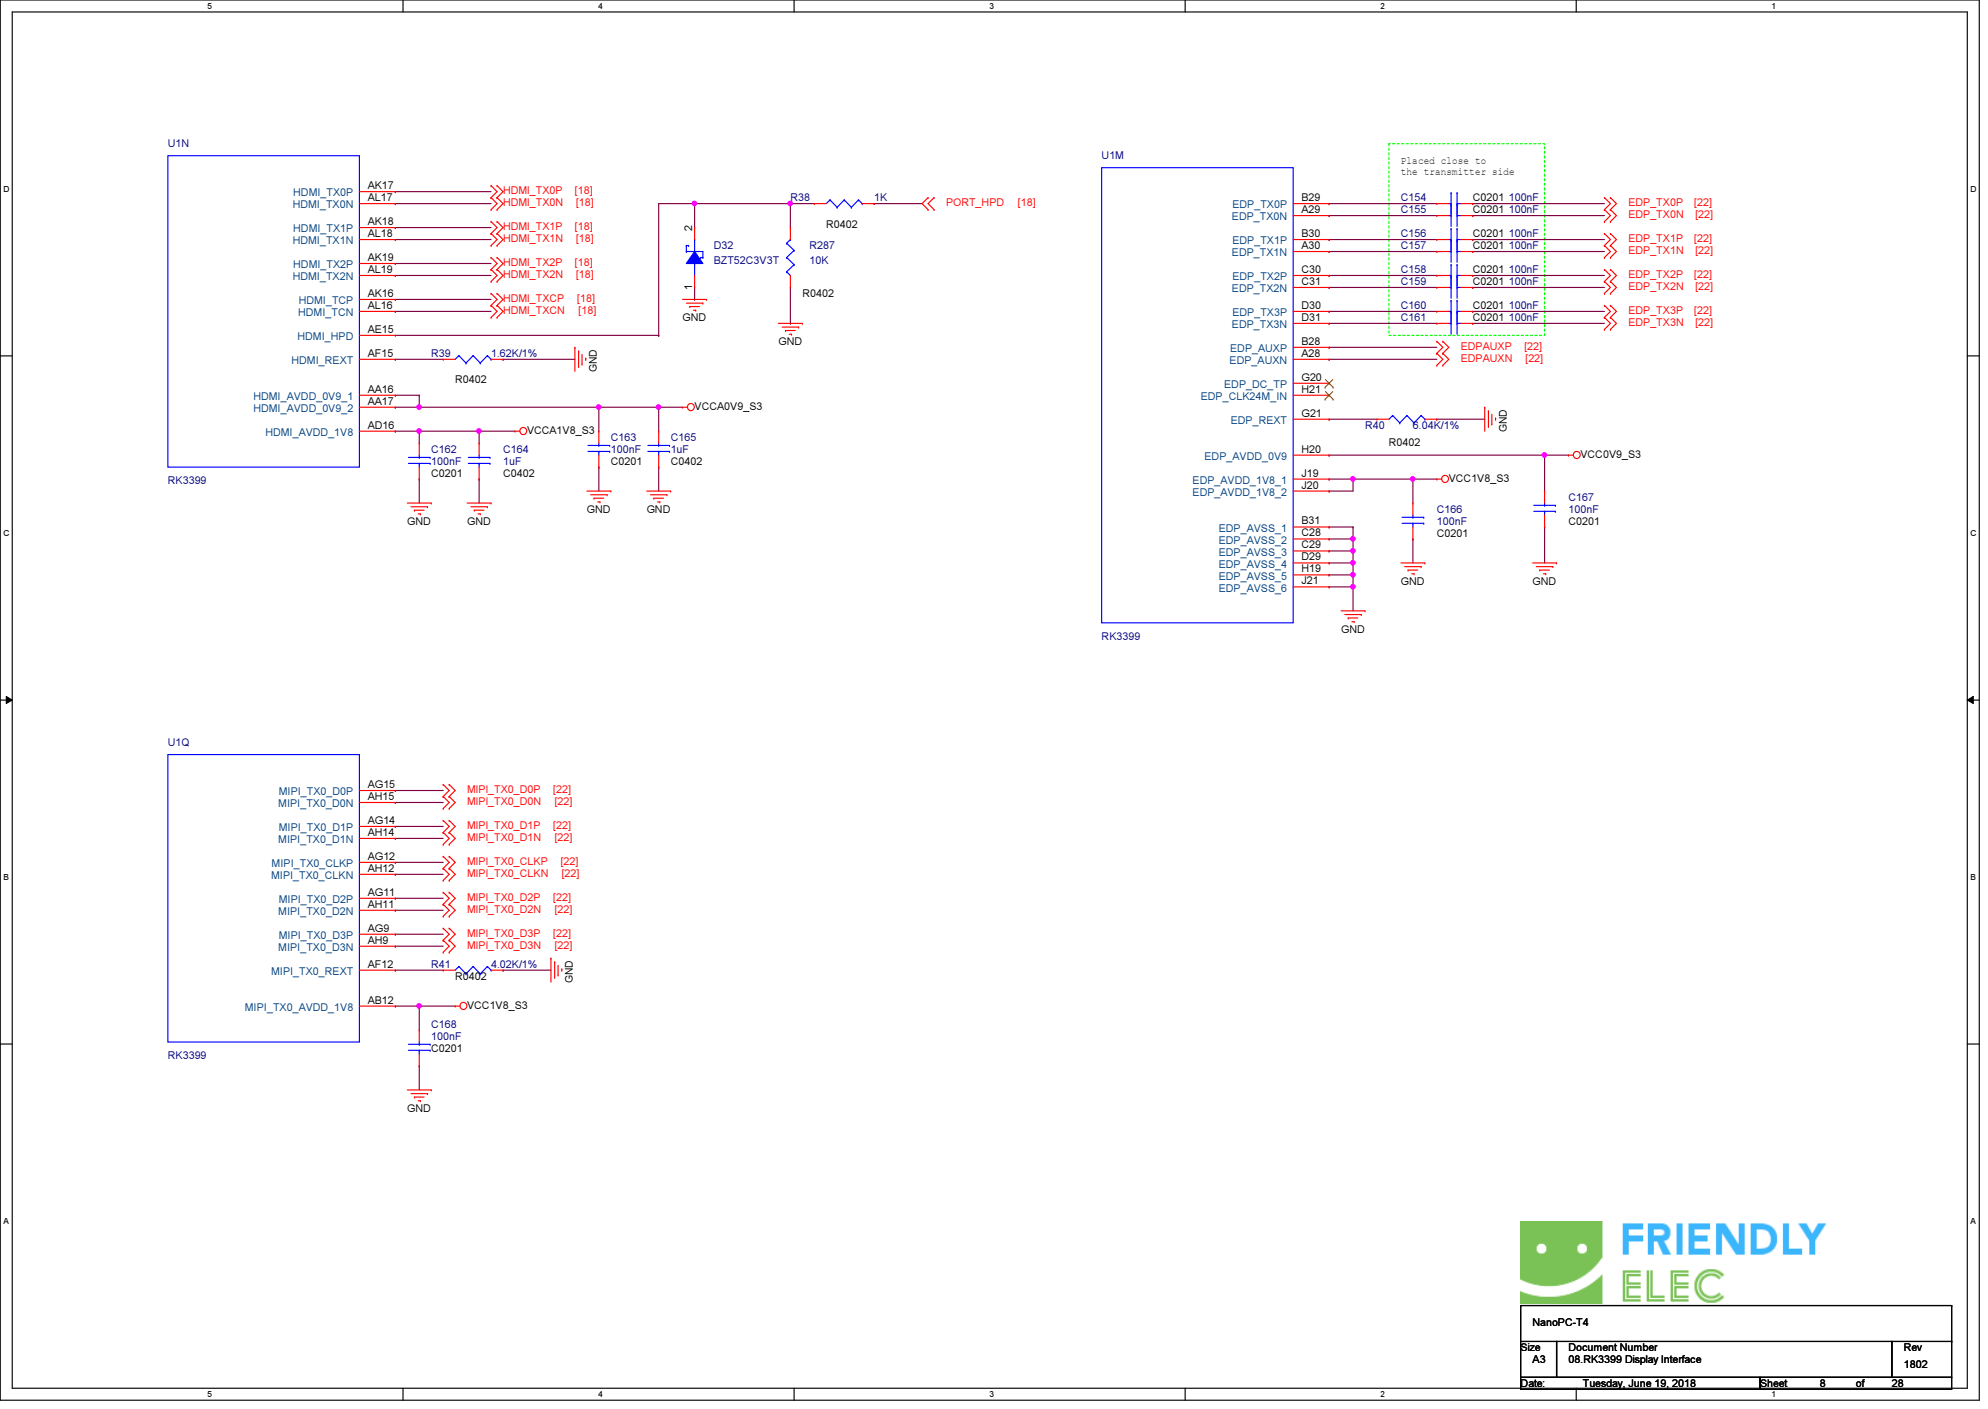
[picture p24: page 8]

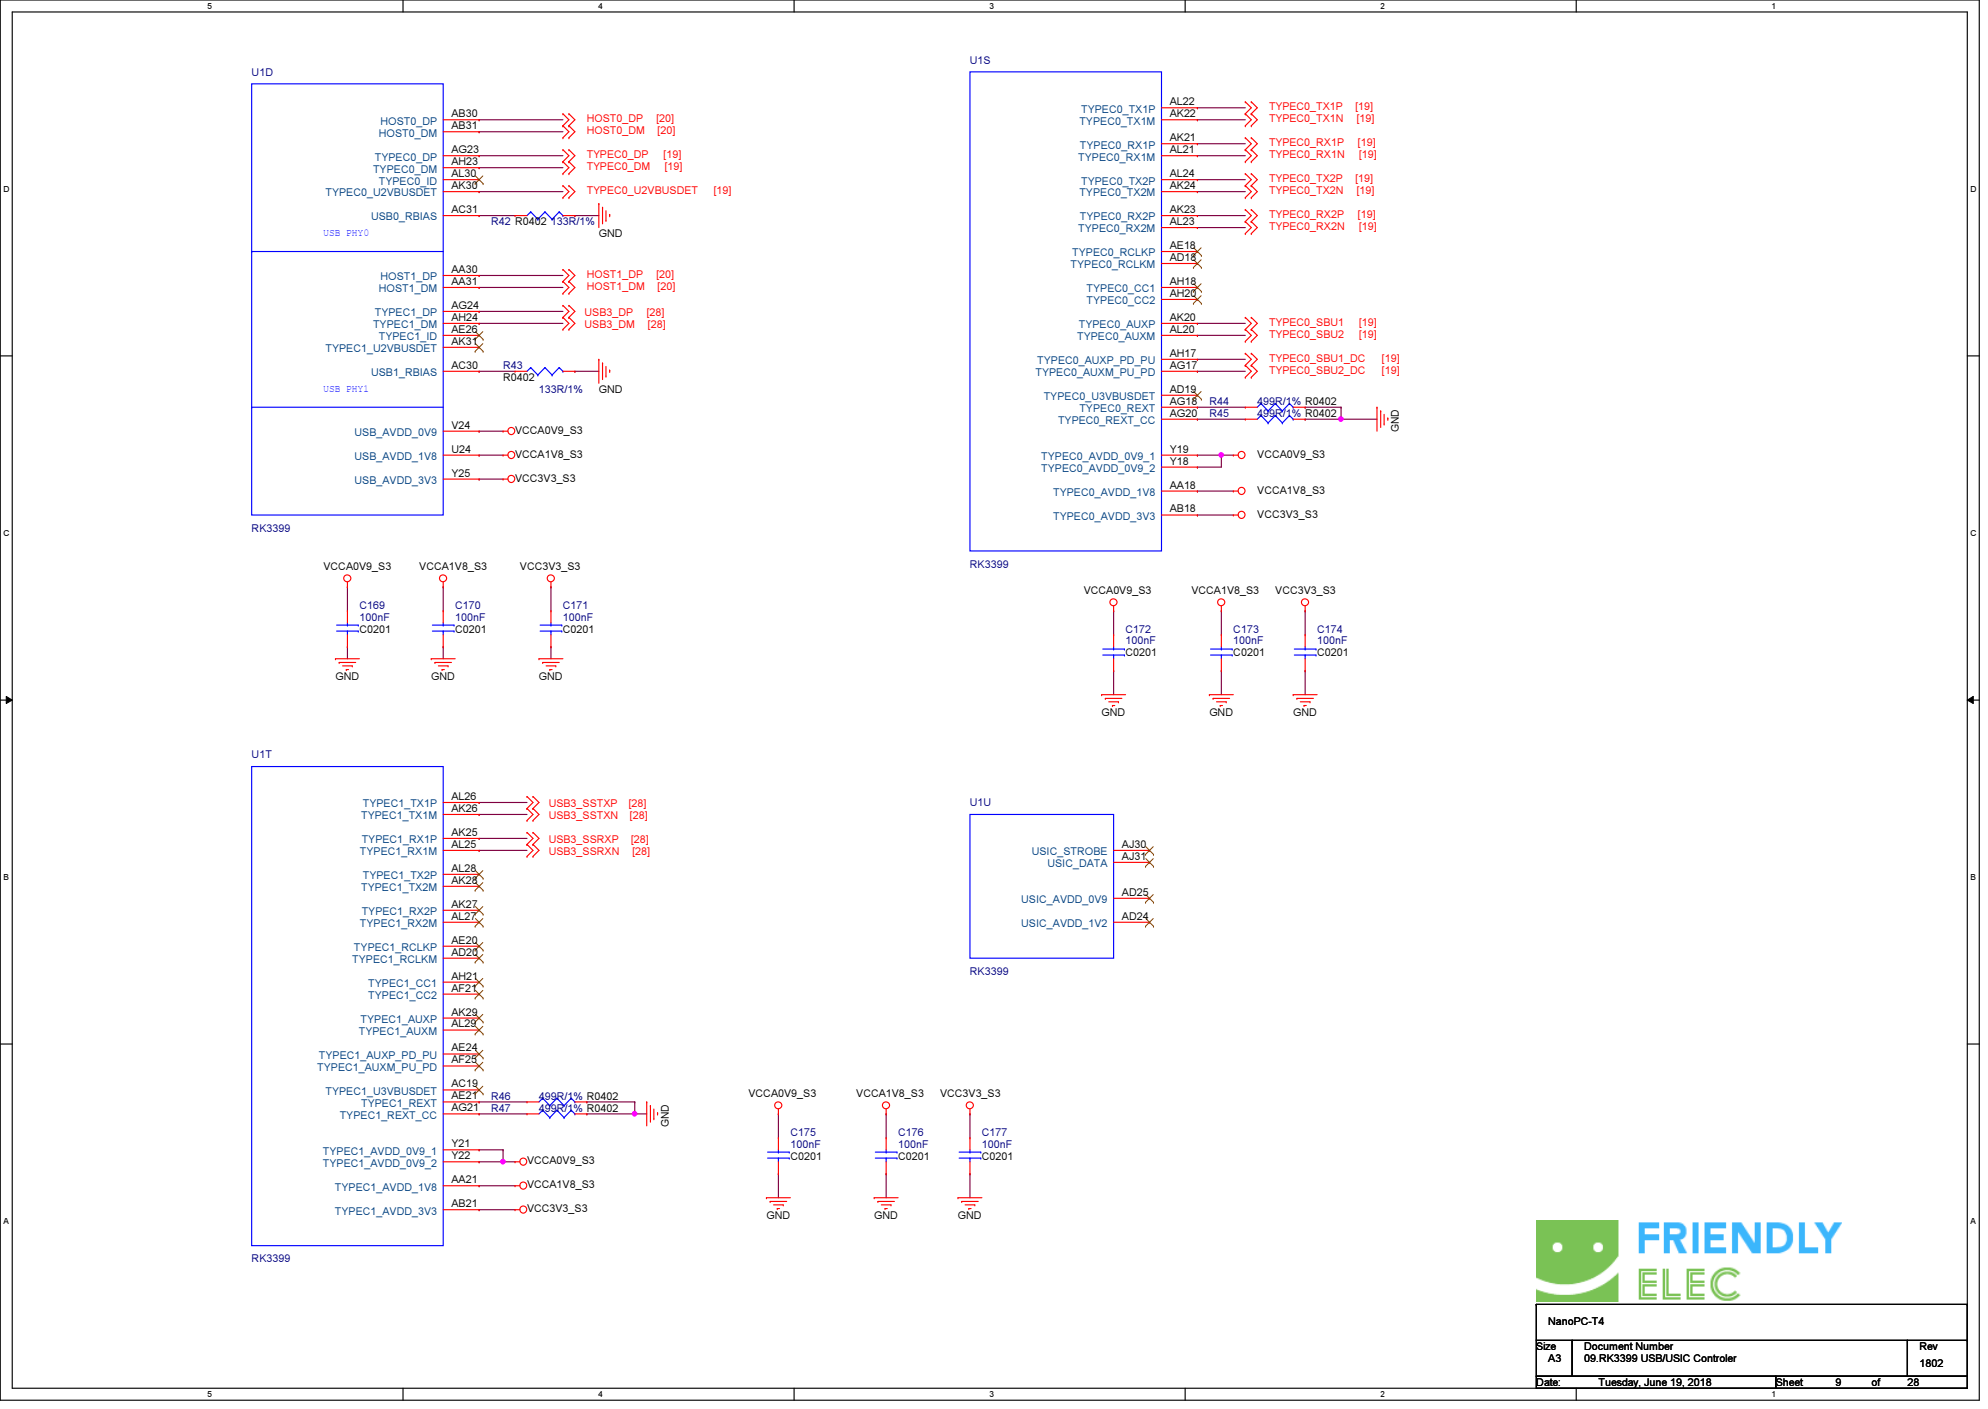
[picture p25: page 9]

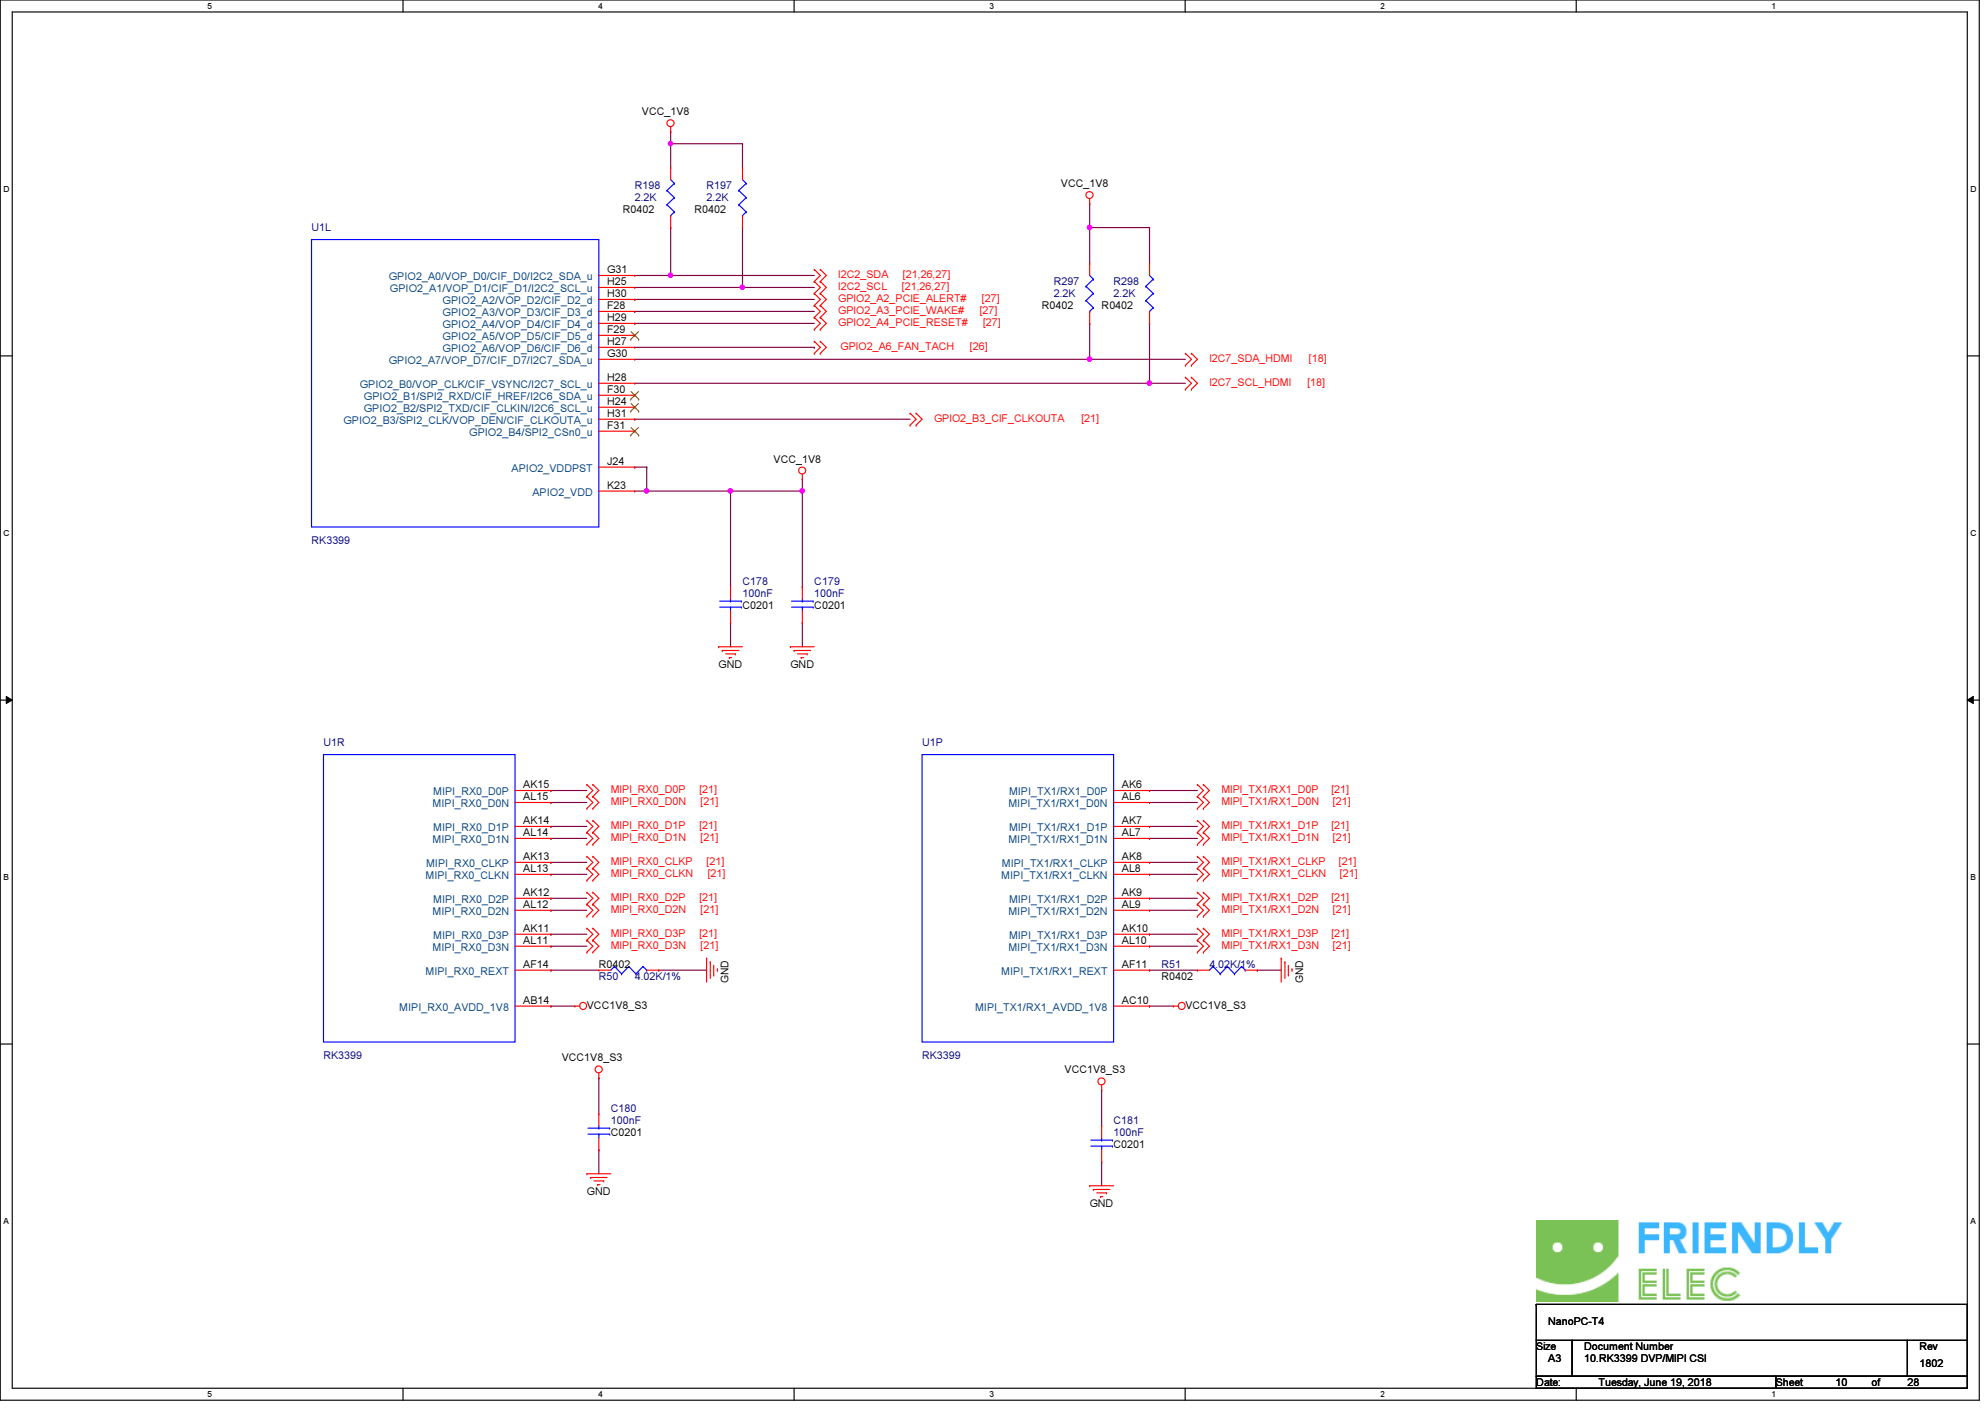
[picture p26: page 10]

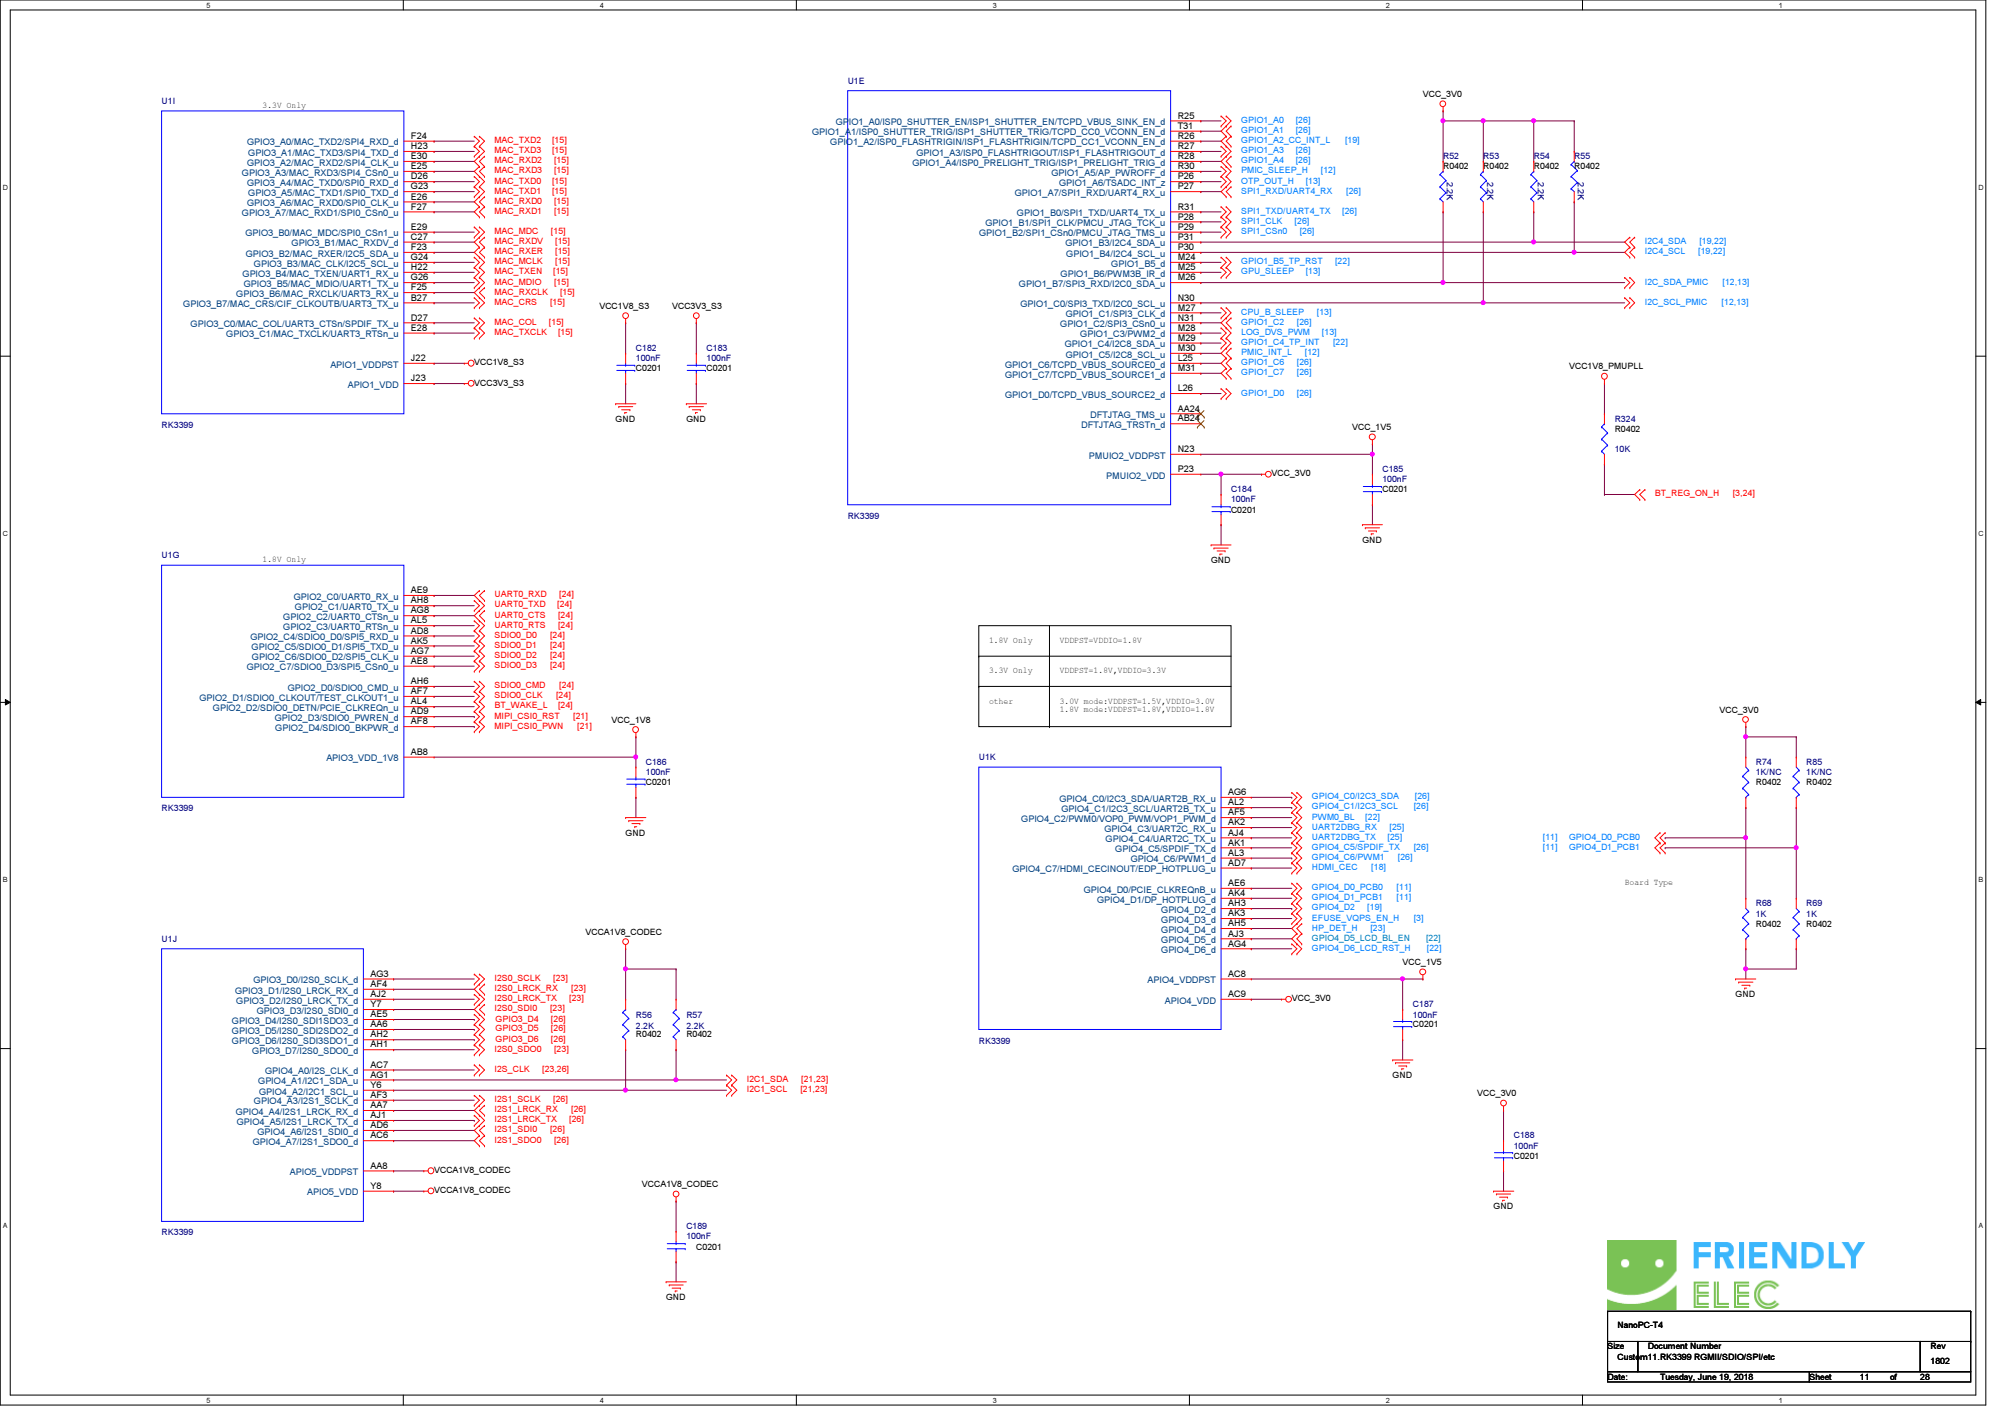
[picture p27: page 11]

11.RK3399 RGMII/SDIO/SPI/etc

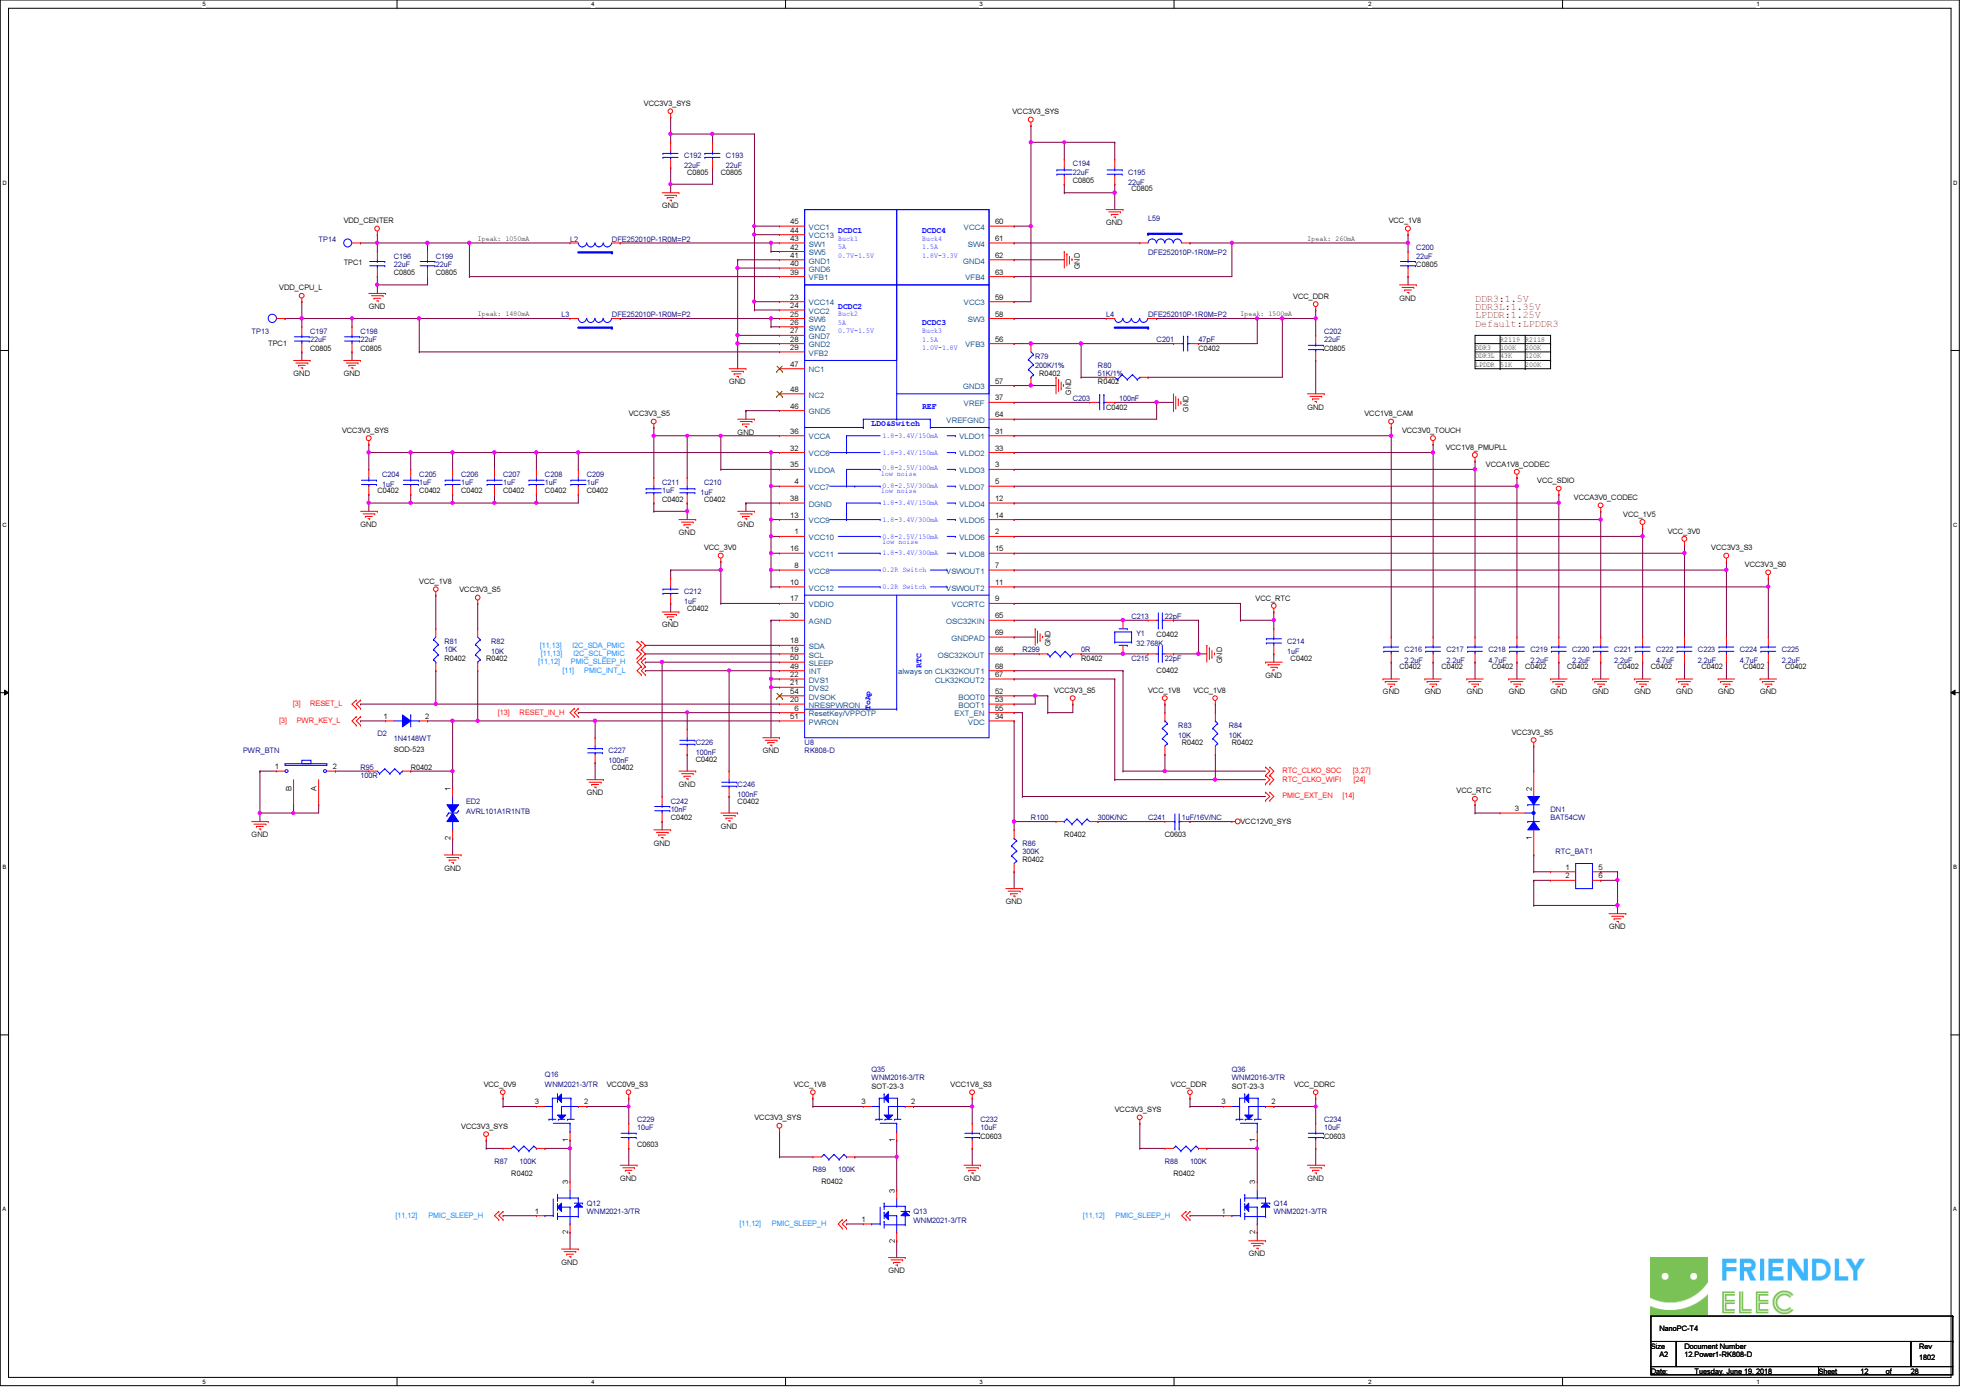
[picture p28: page 12]

# Over-temperature Protection

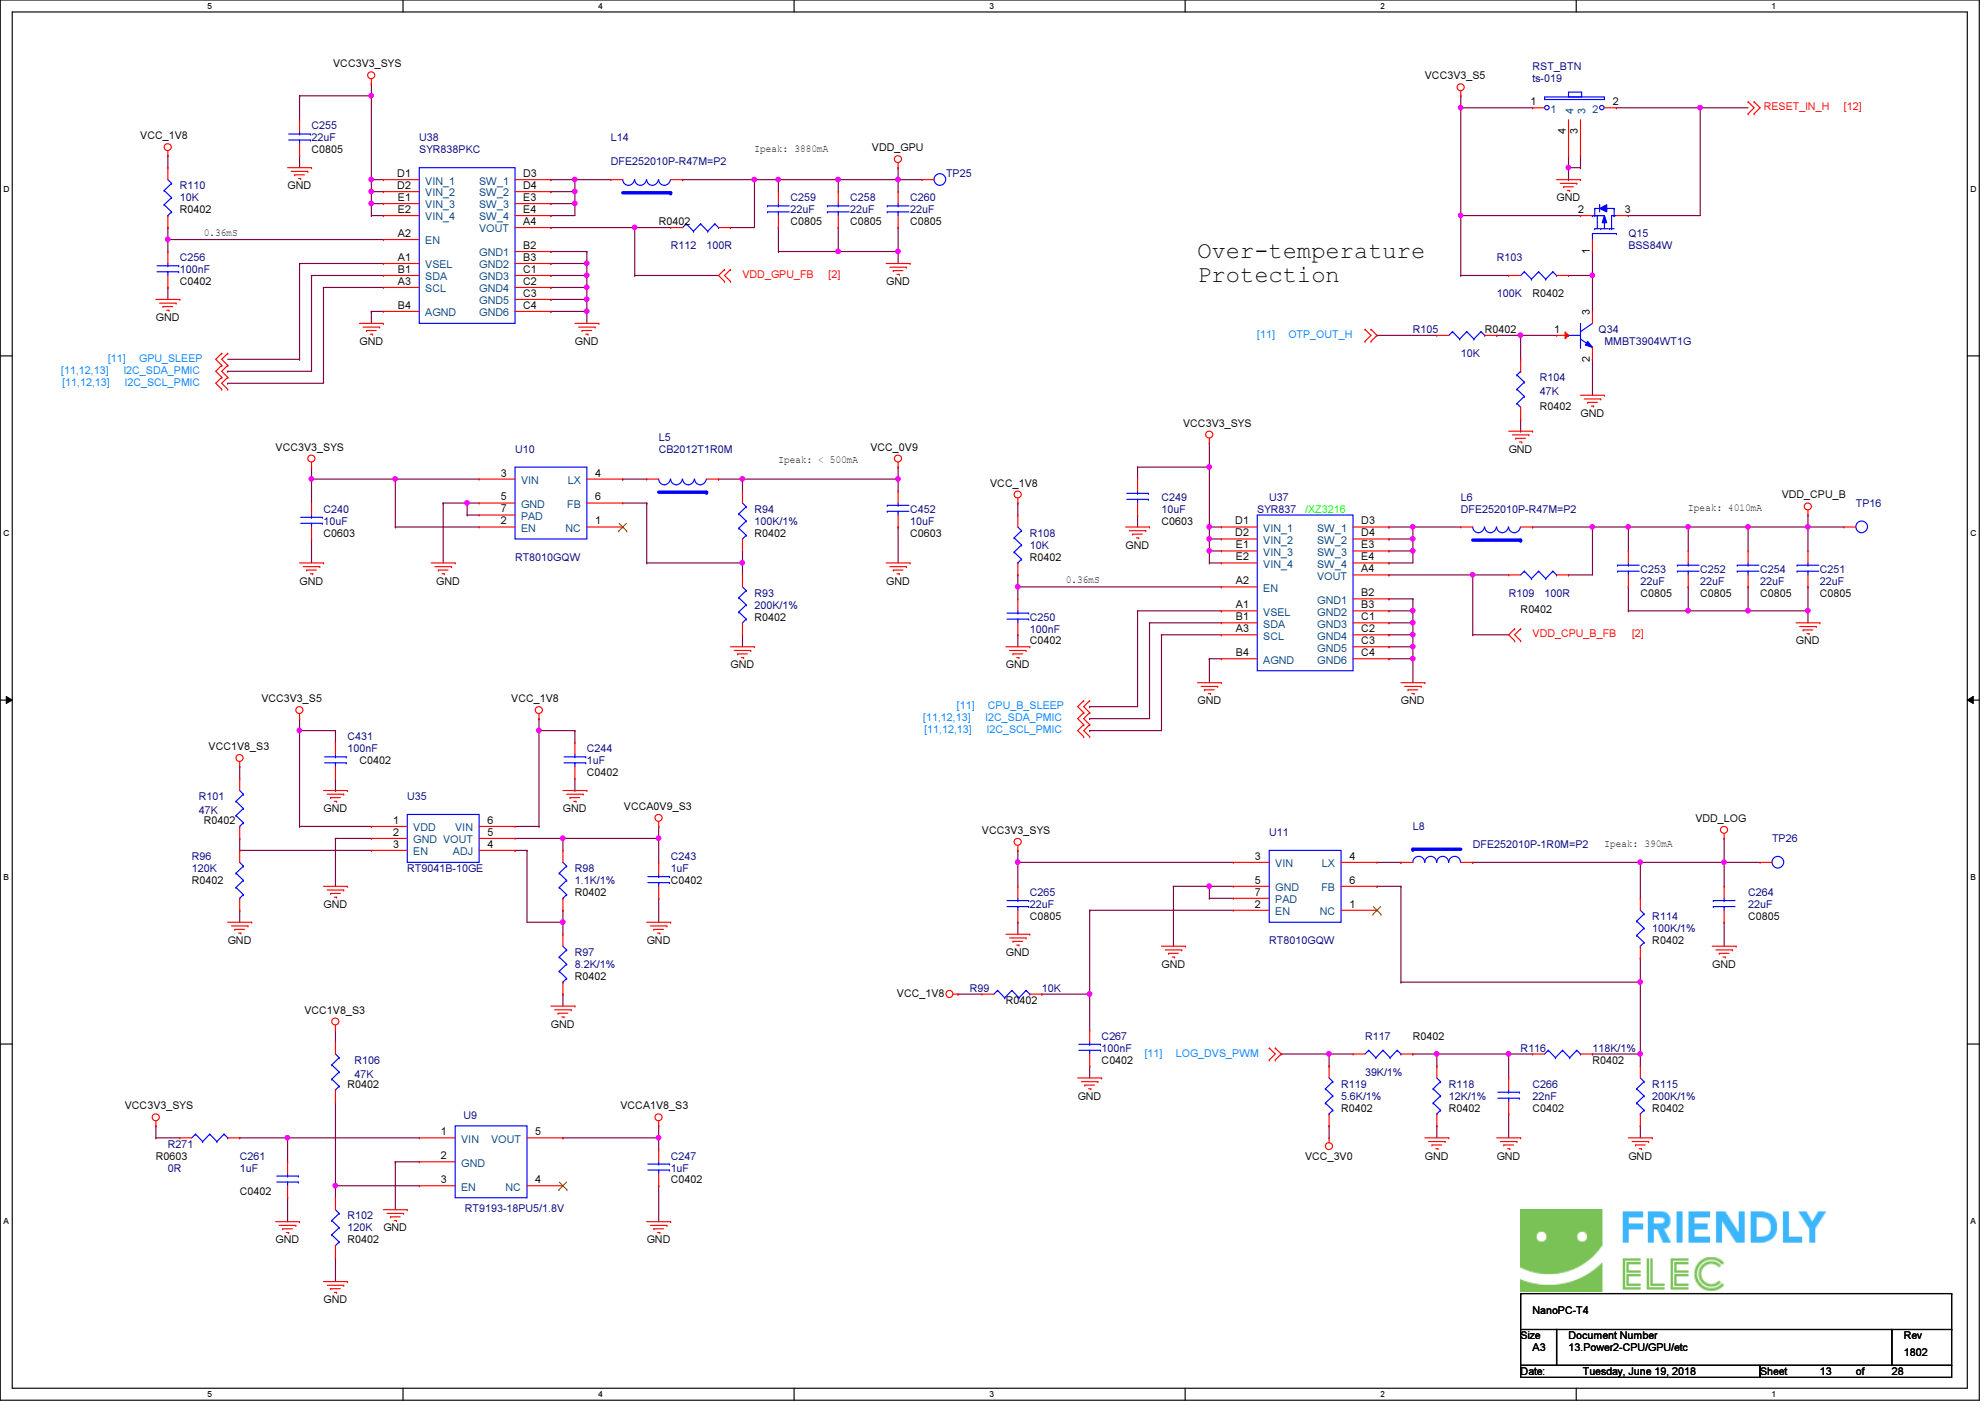
[picture p29: page 13]

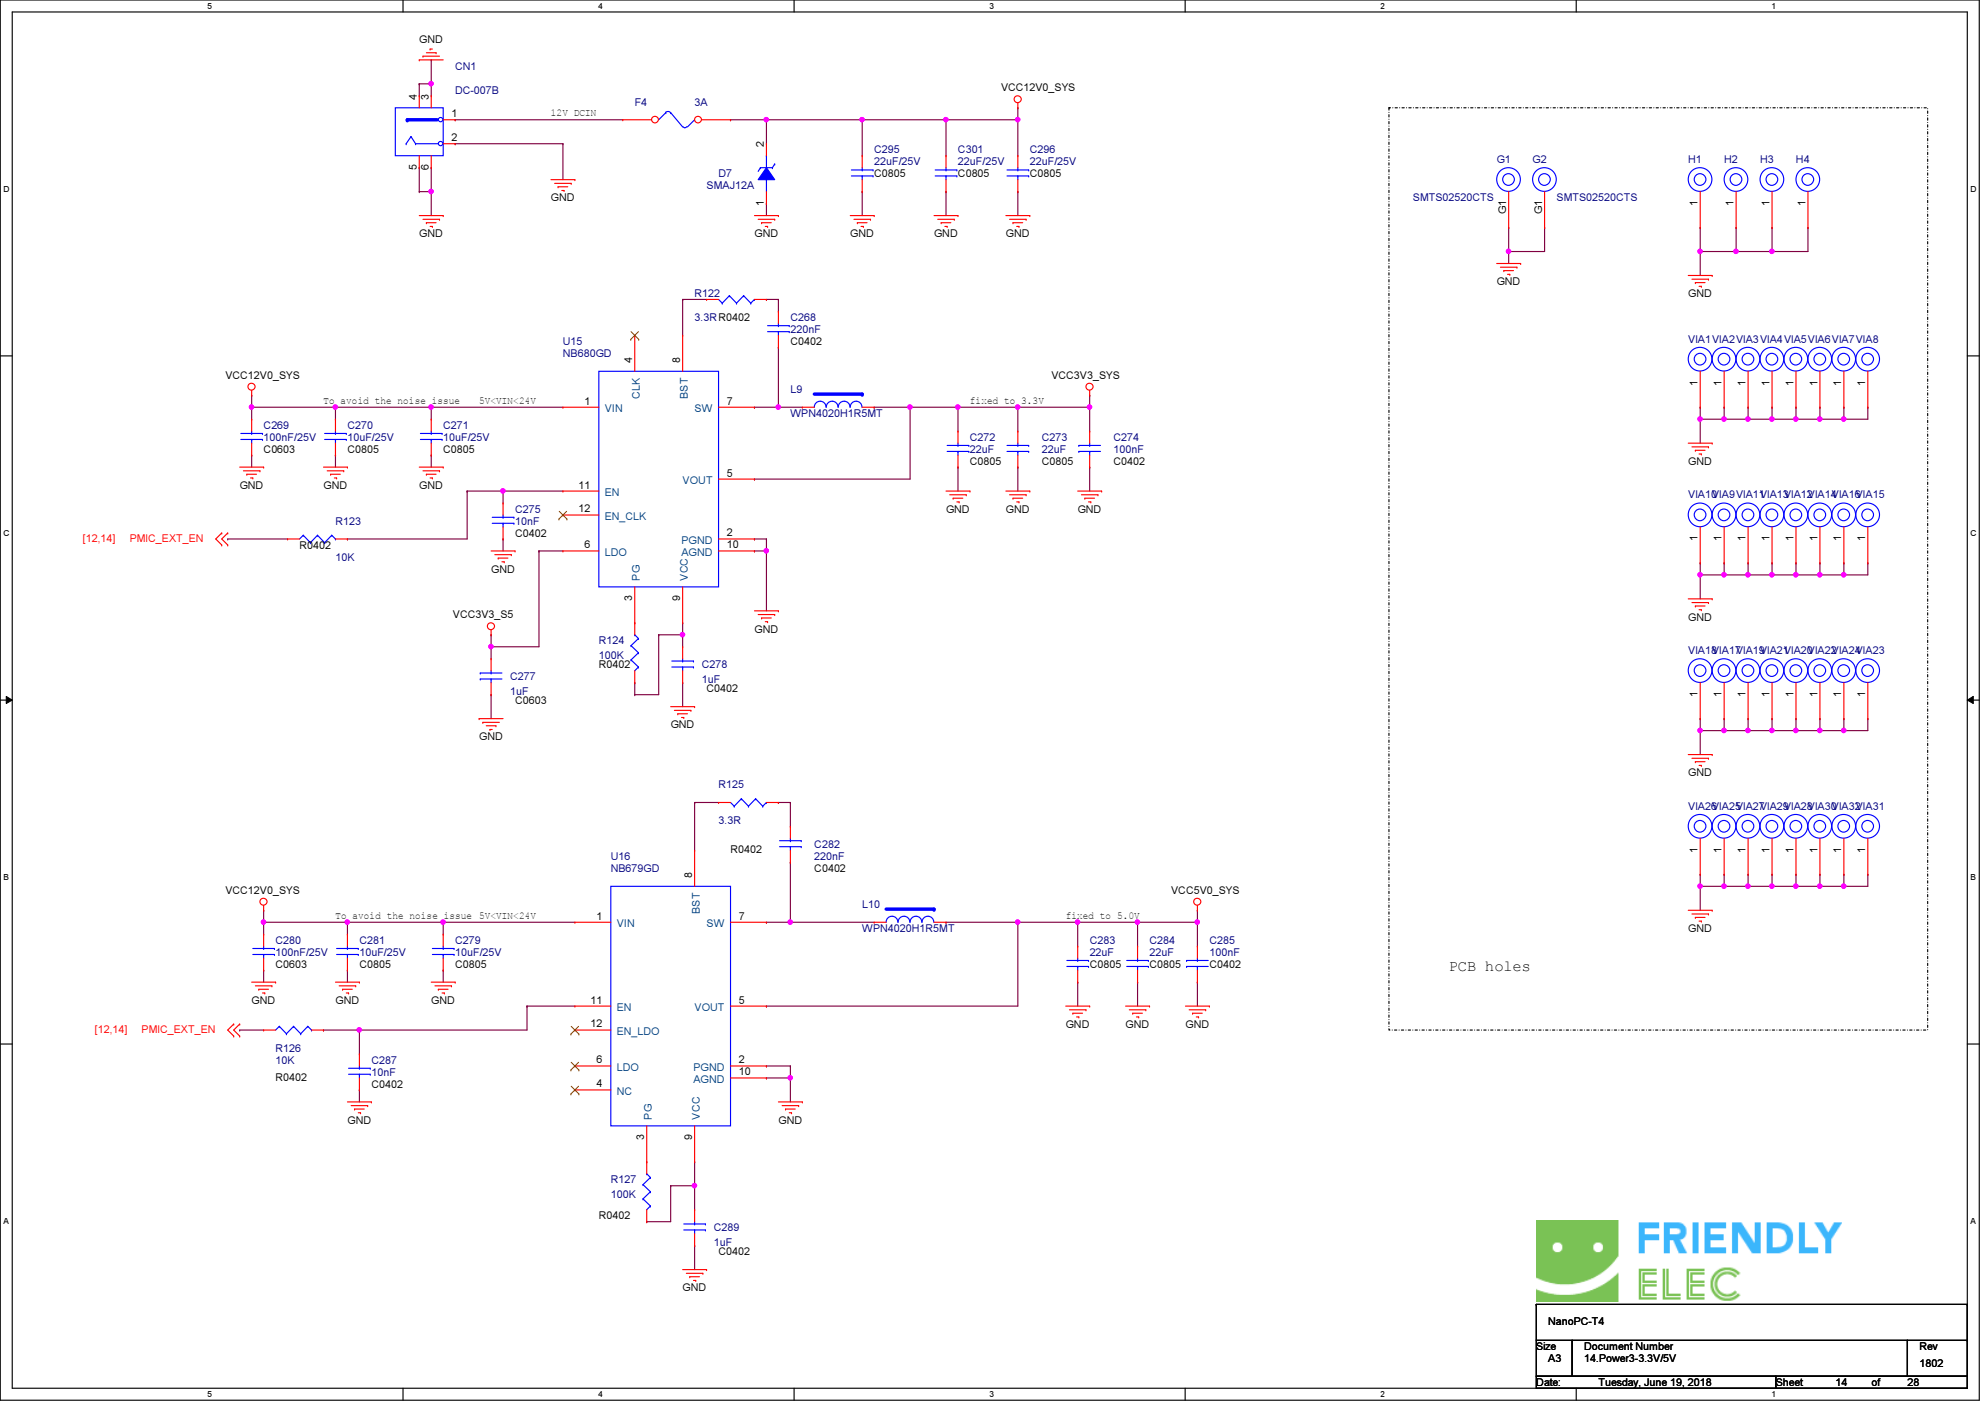
[picture p30: page 14]

10/100/1000M

# Ethernet

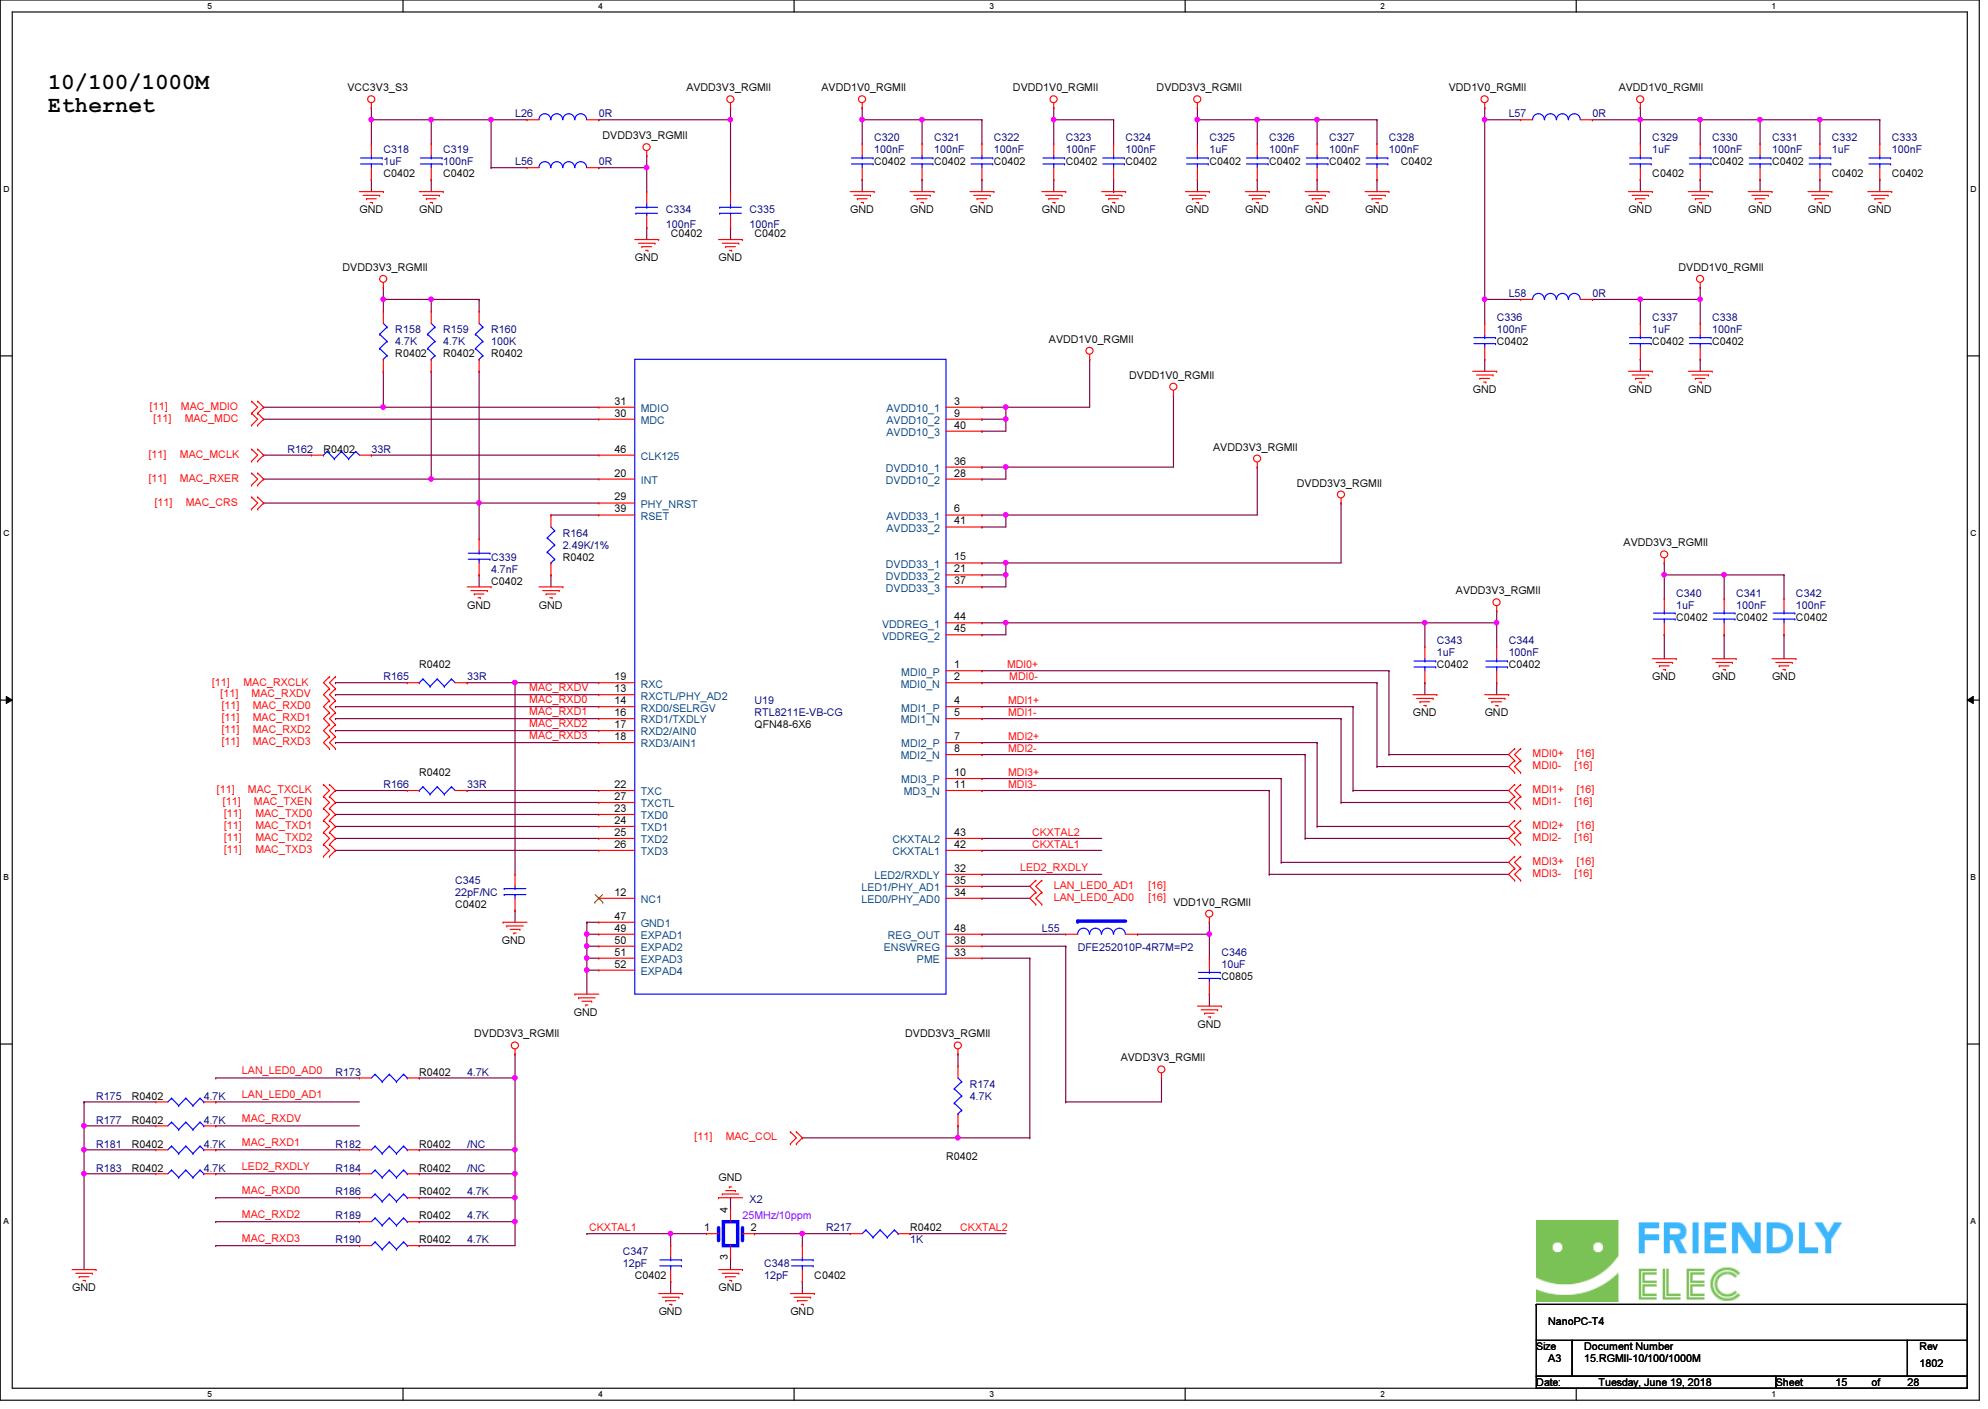
[picture p31: page 15]

D | D

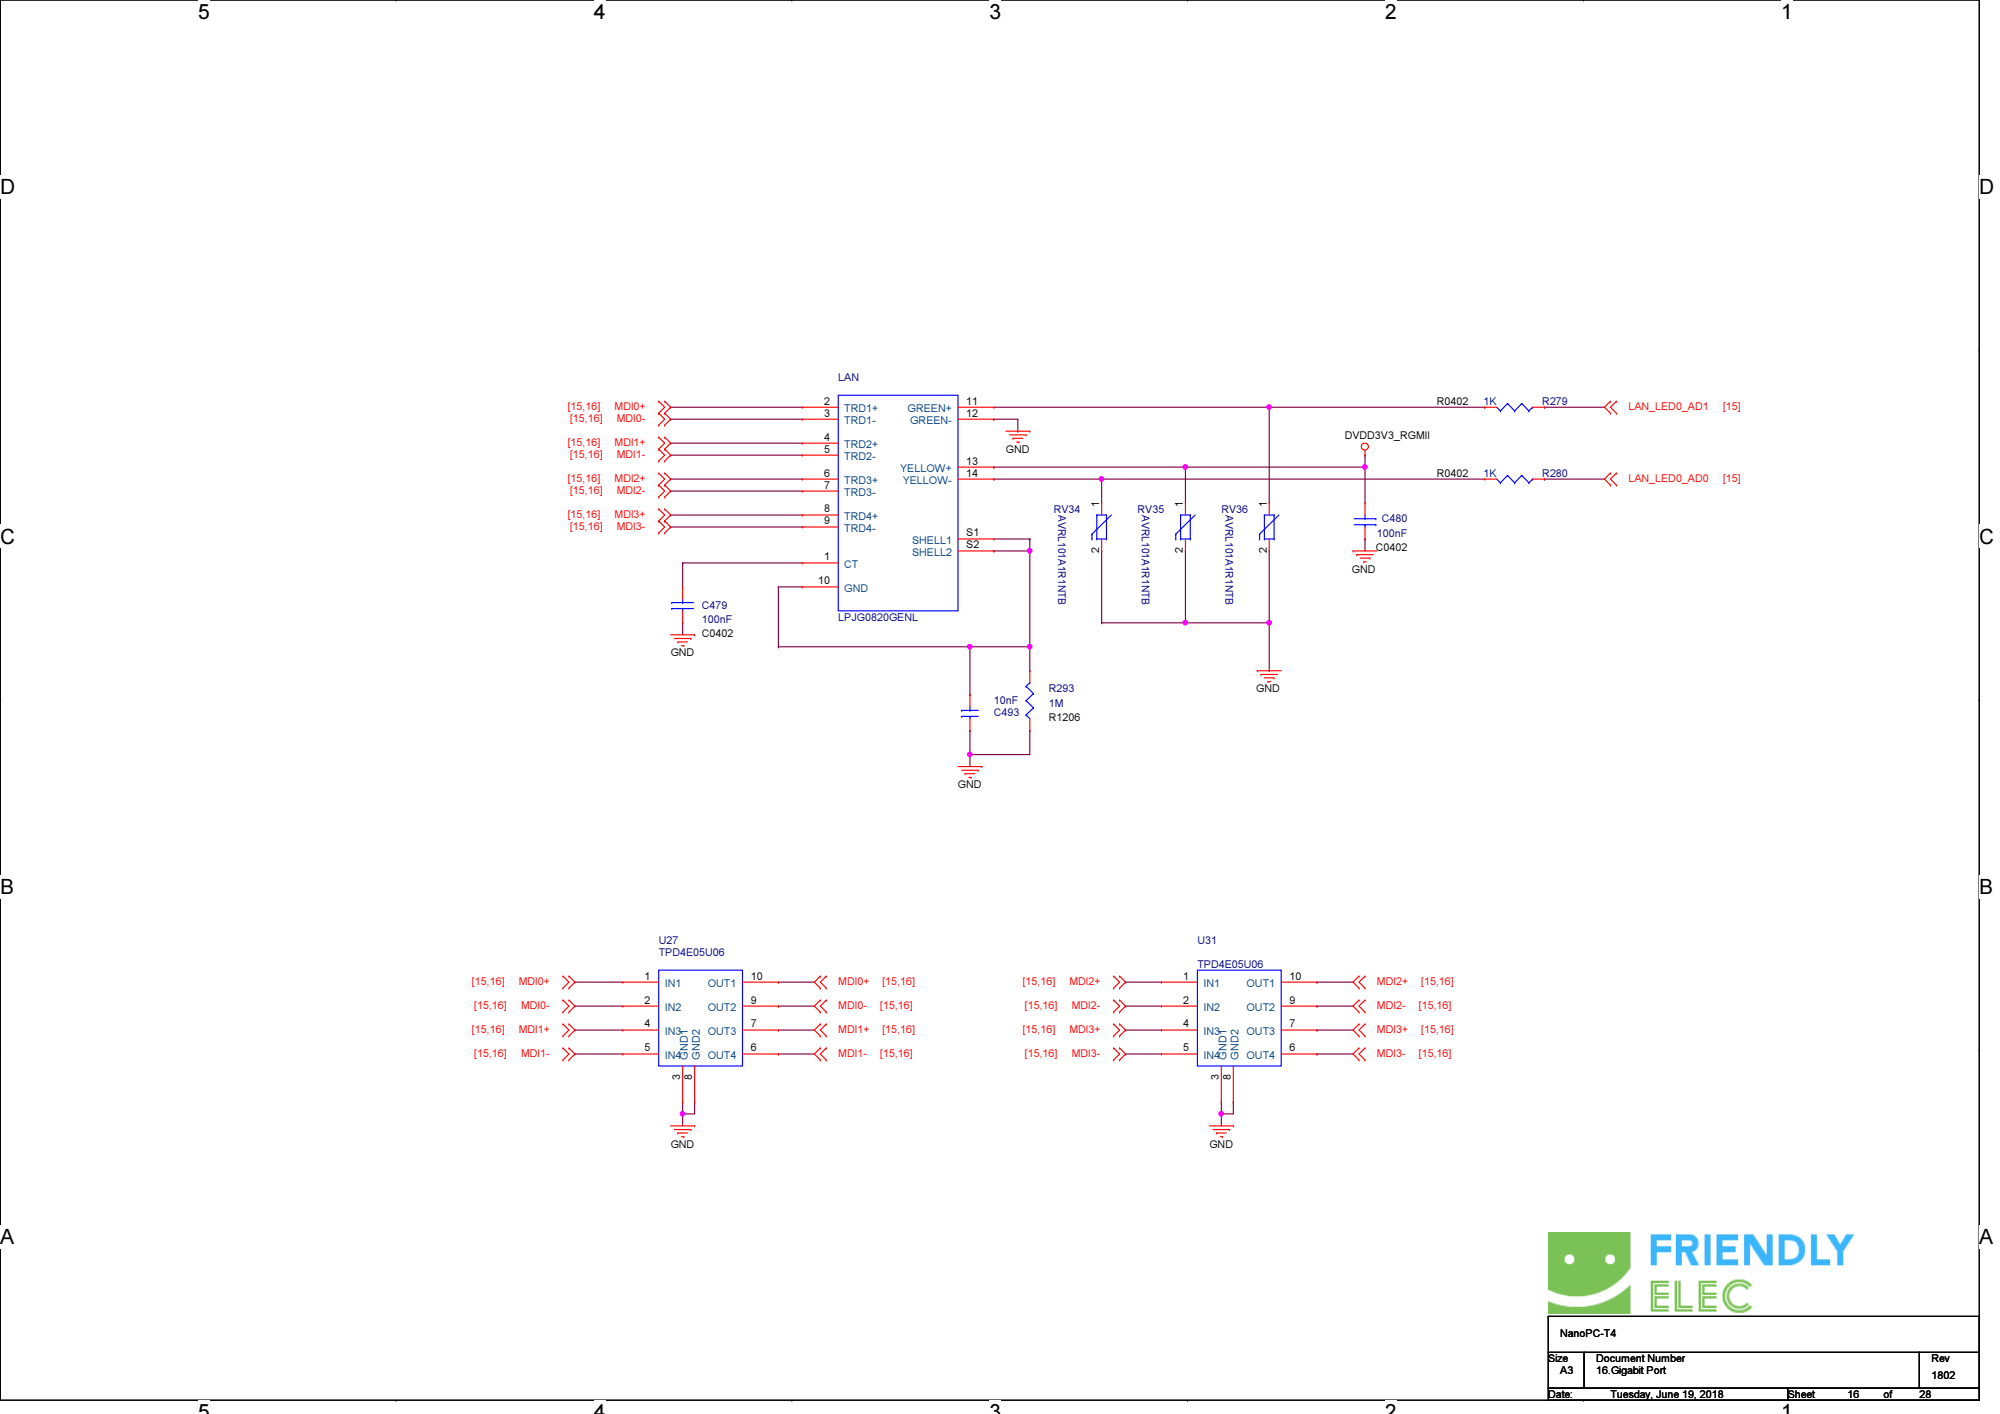
[picture p32: page 16]

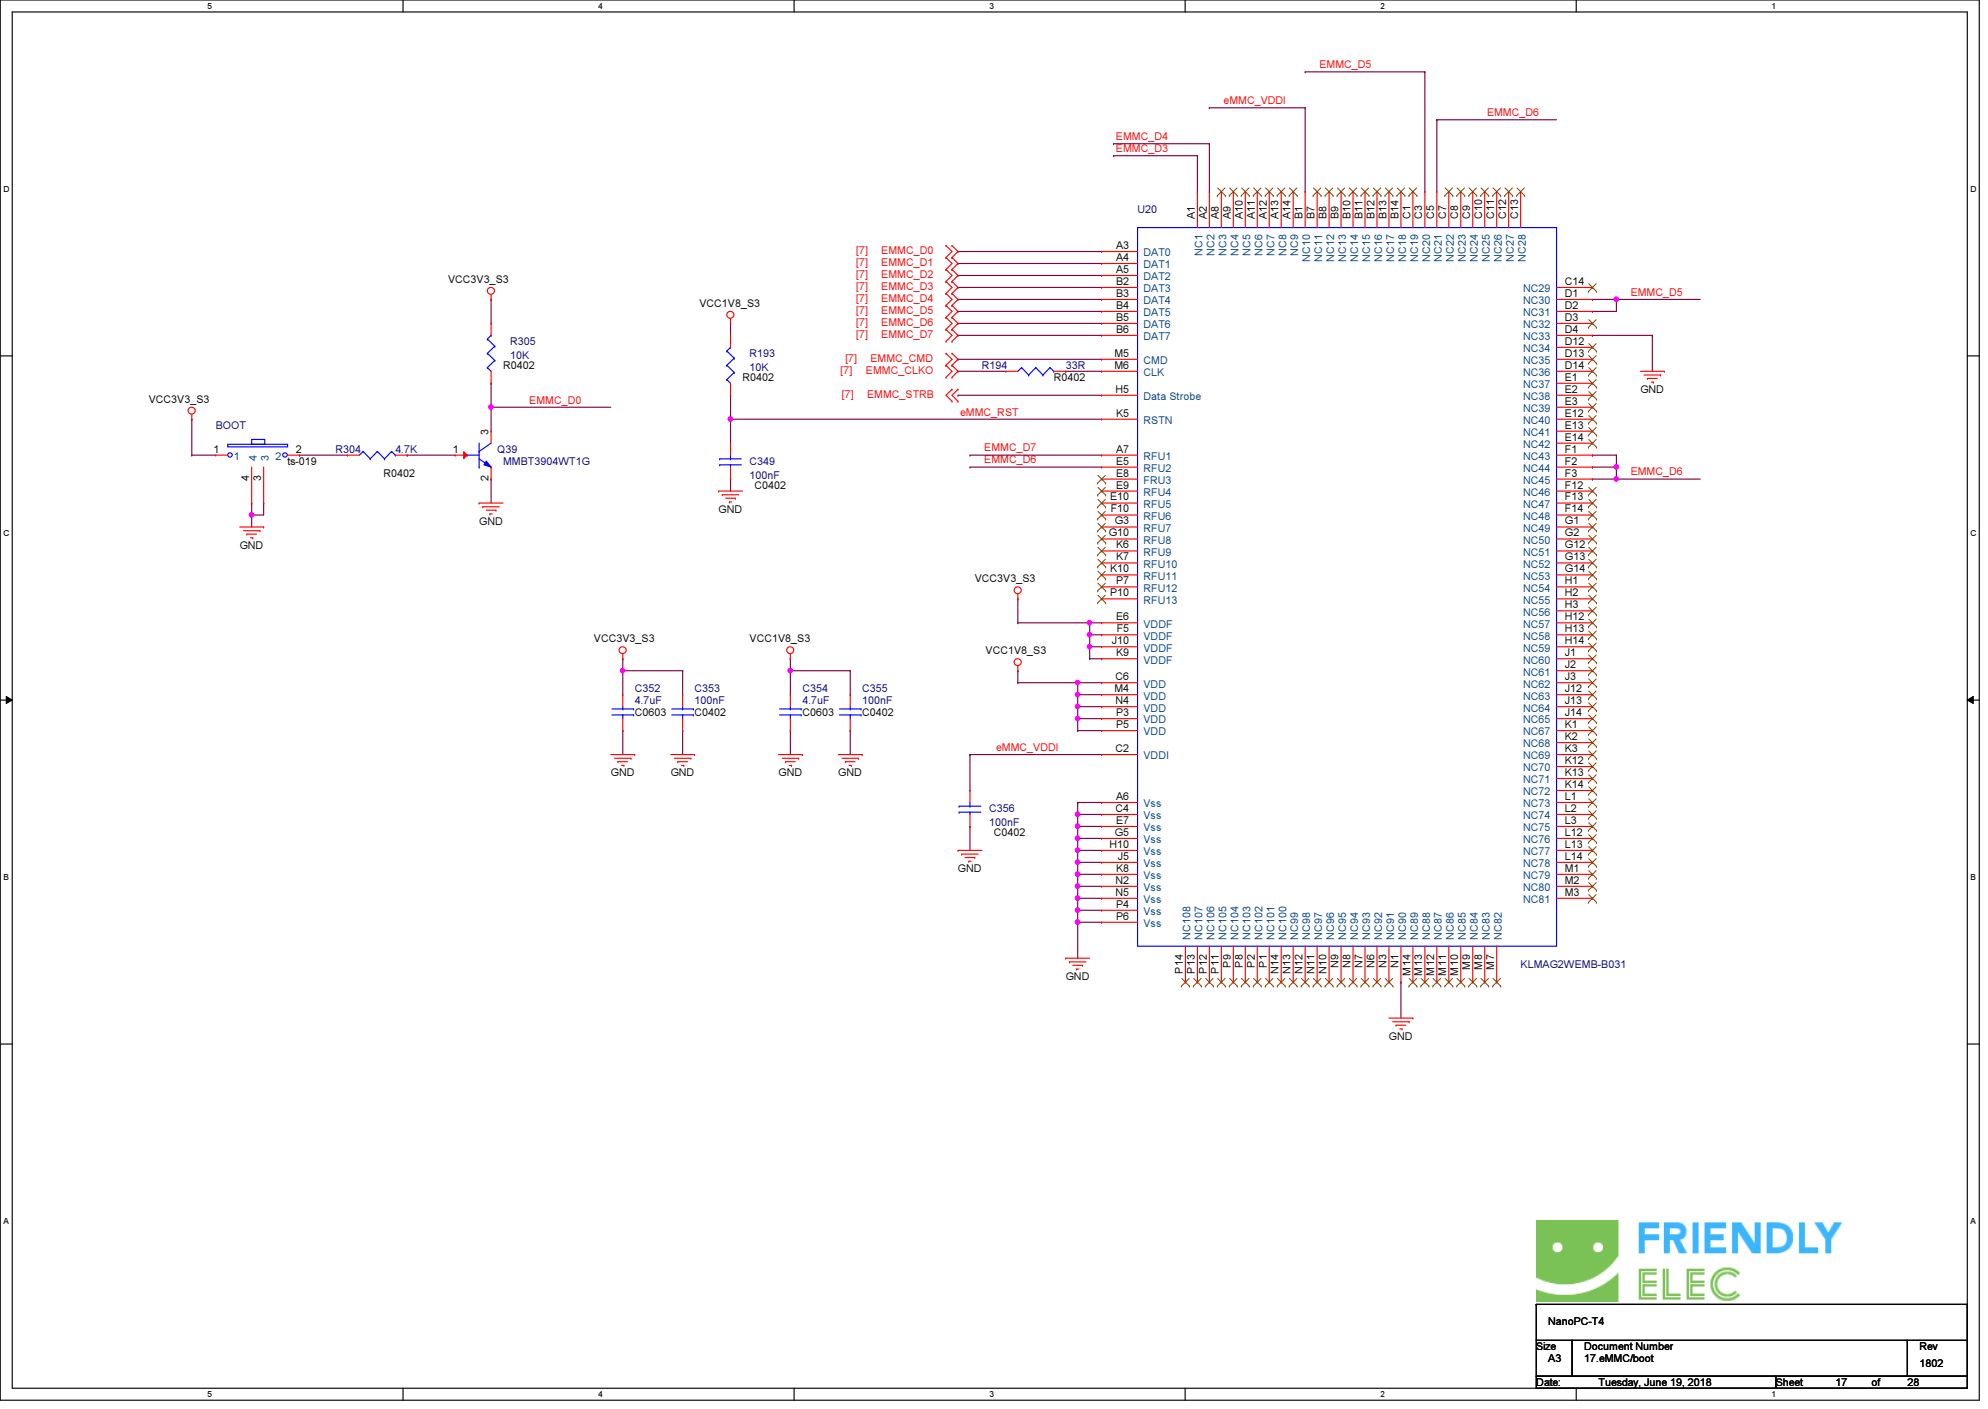
[picture p33: page 17]

# HDMI Port

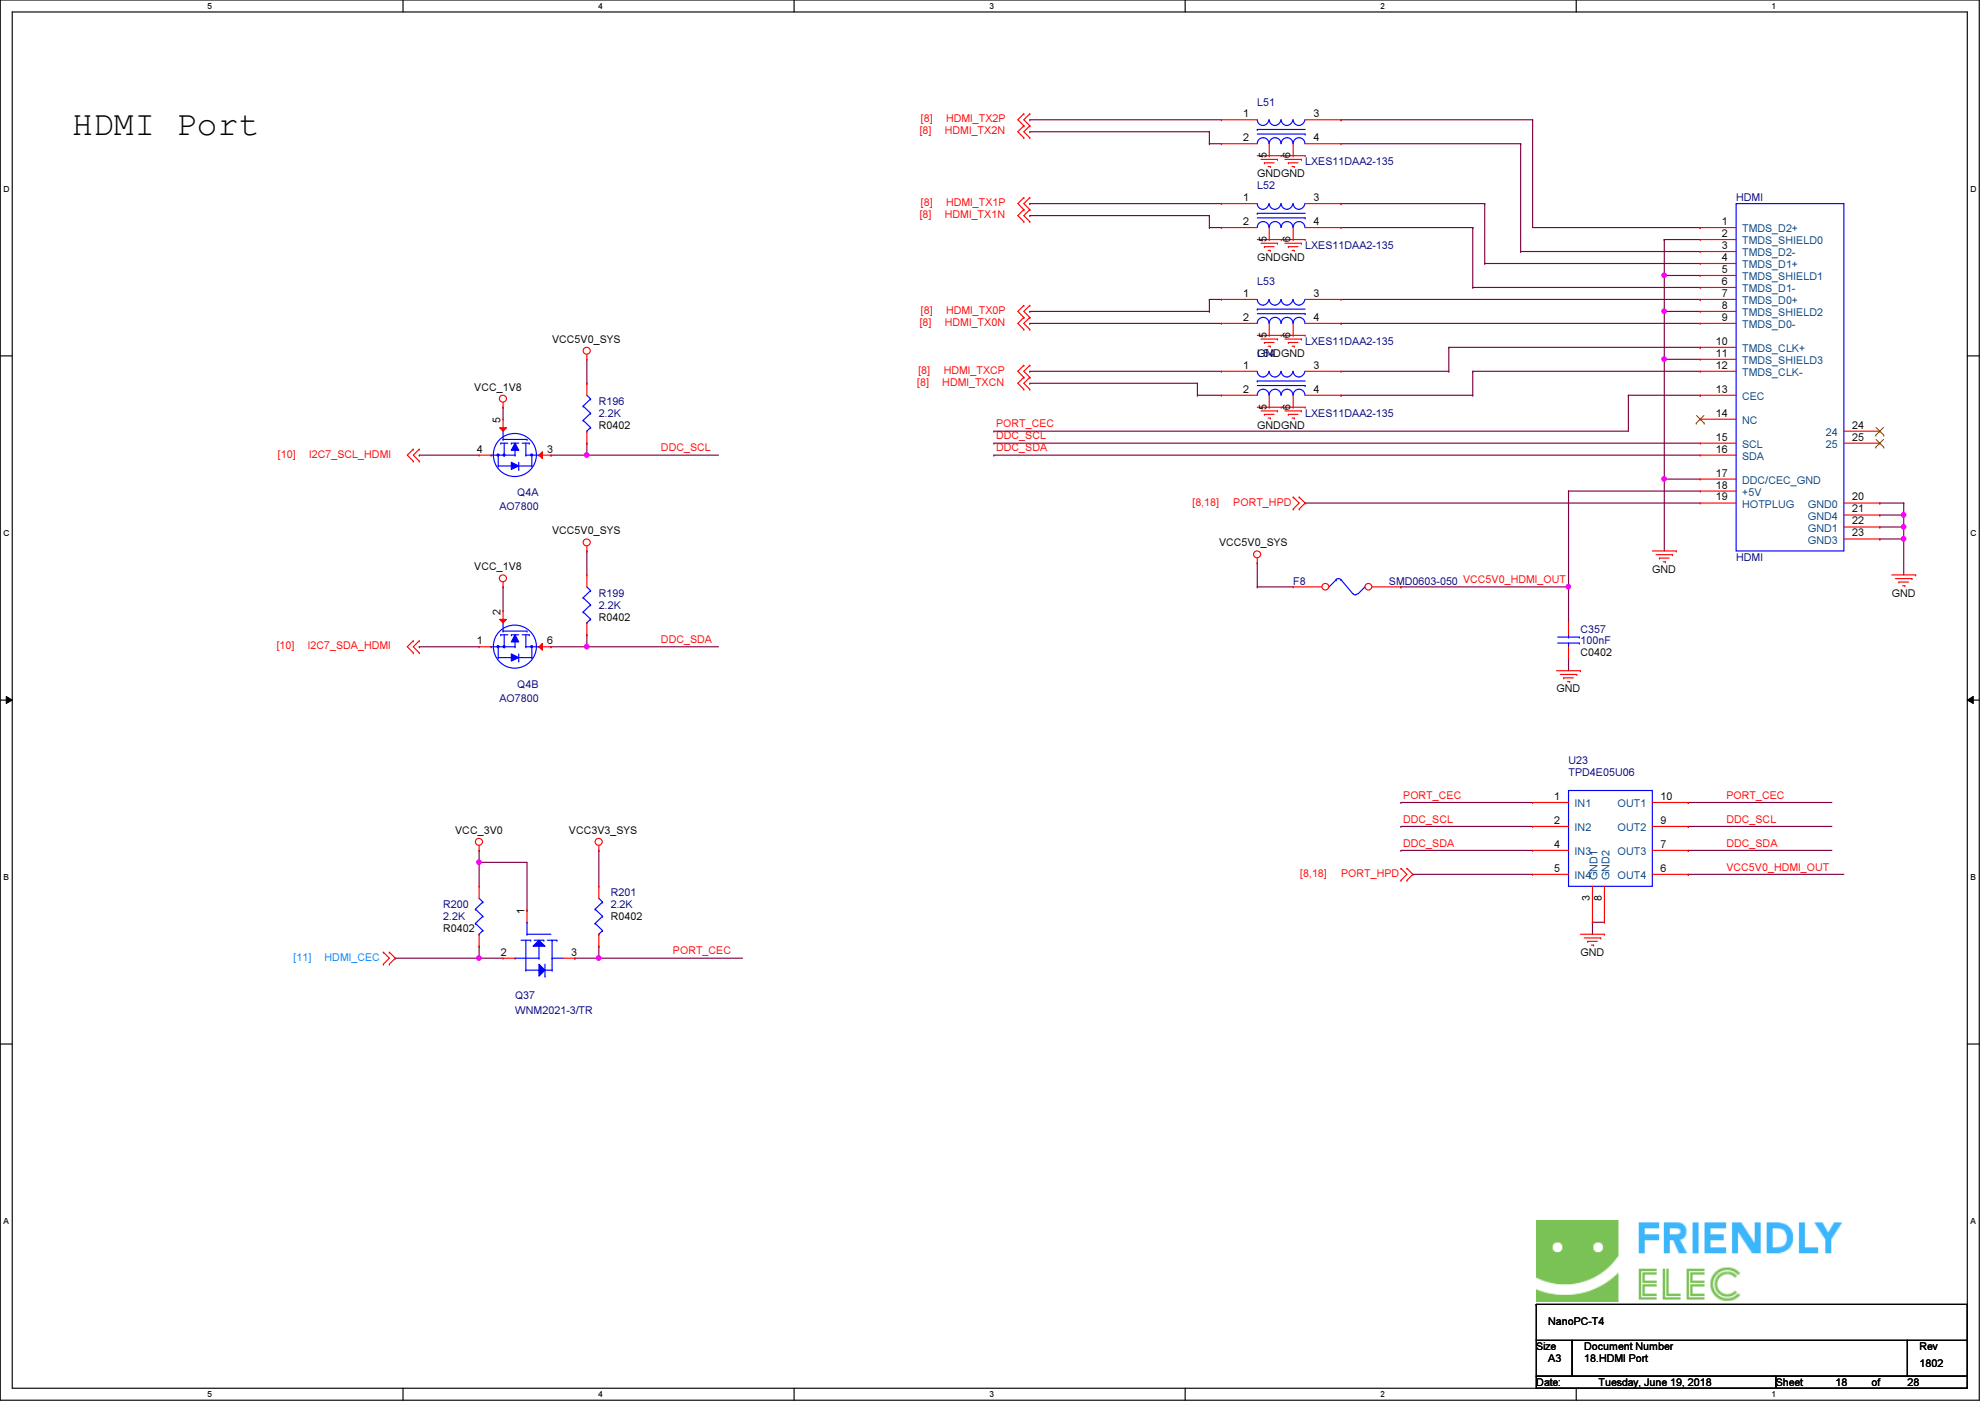
[picture p34: page 18]

# USB Type-C

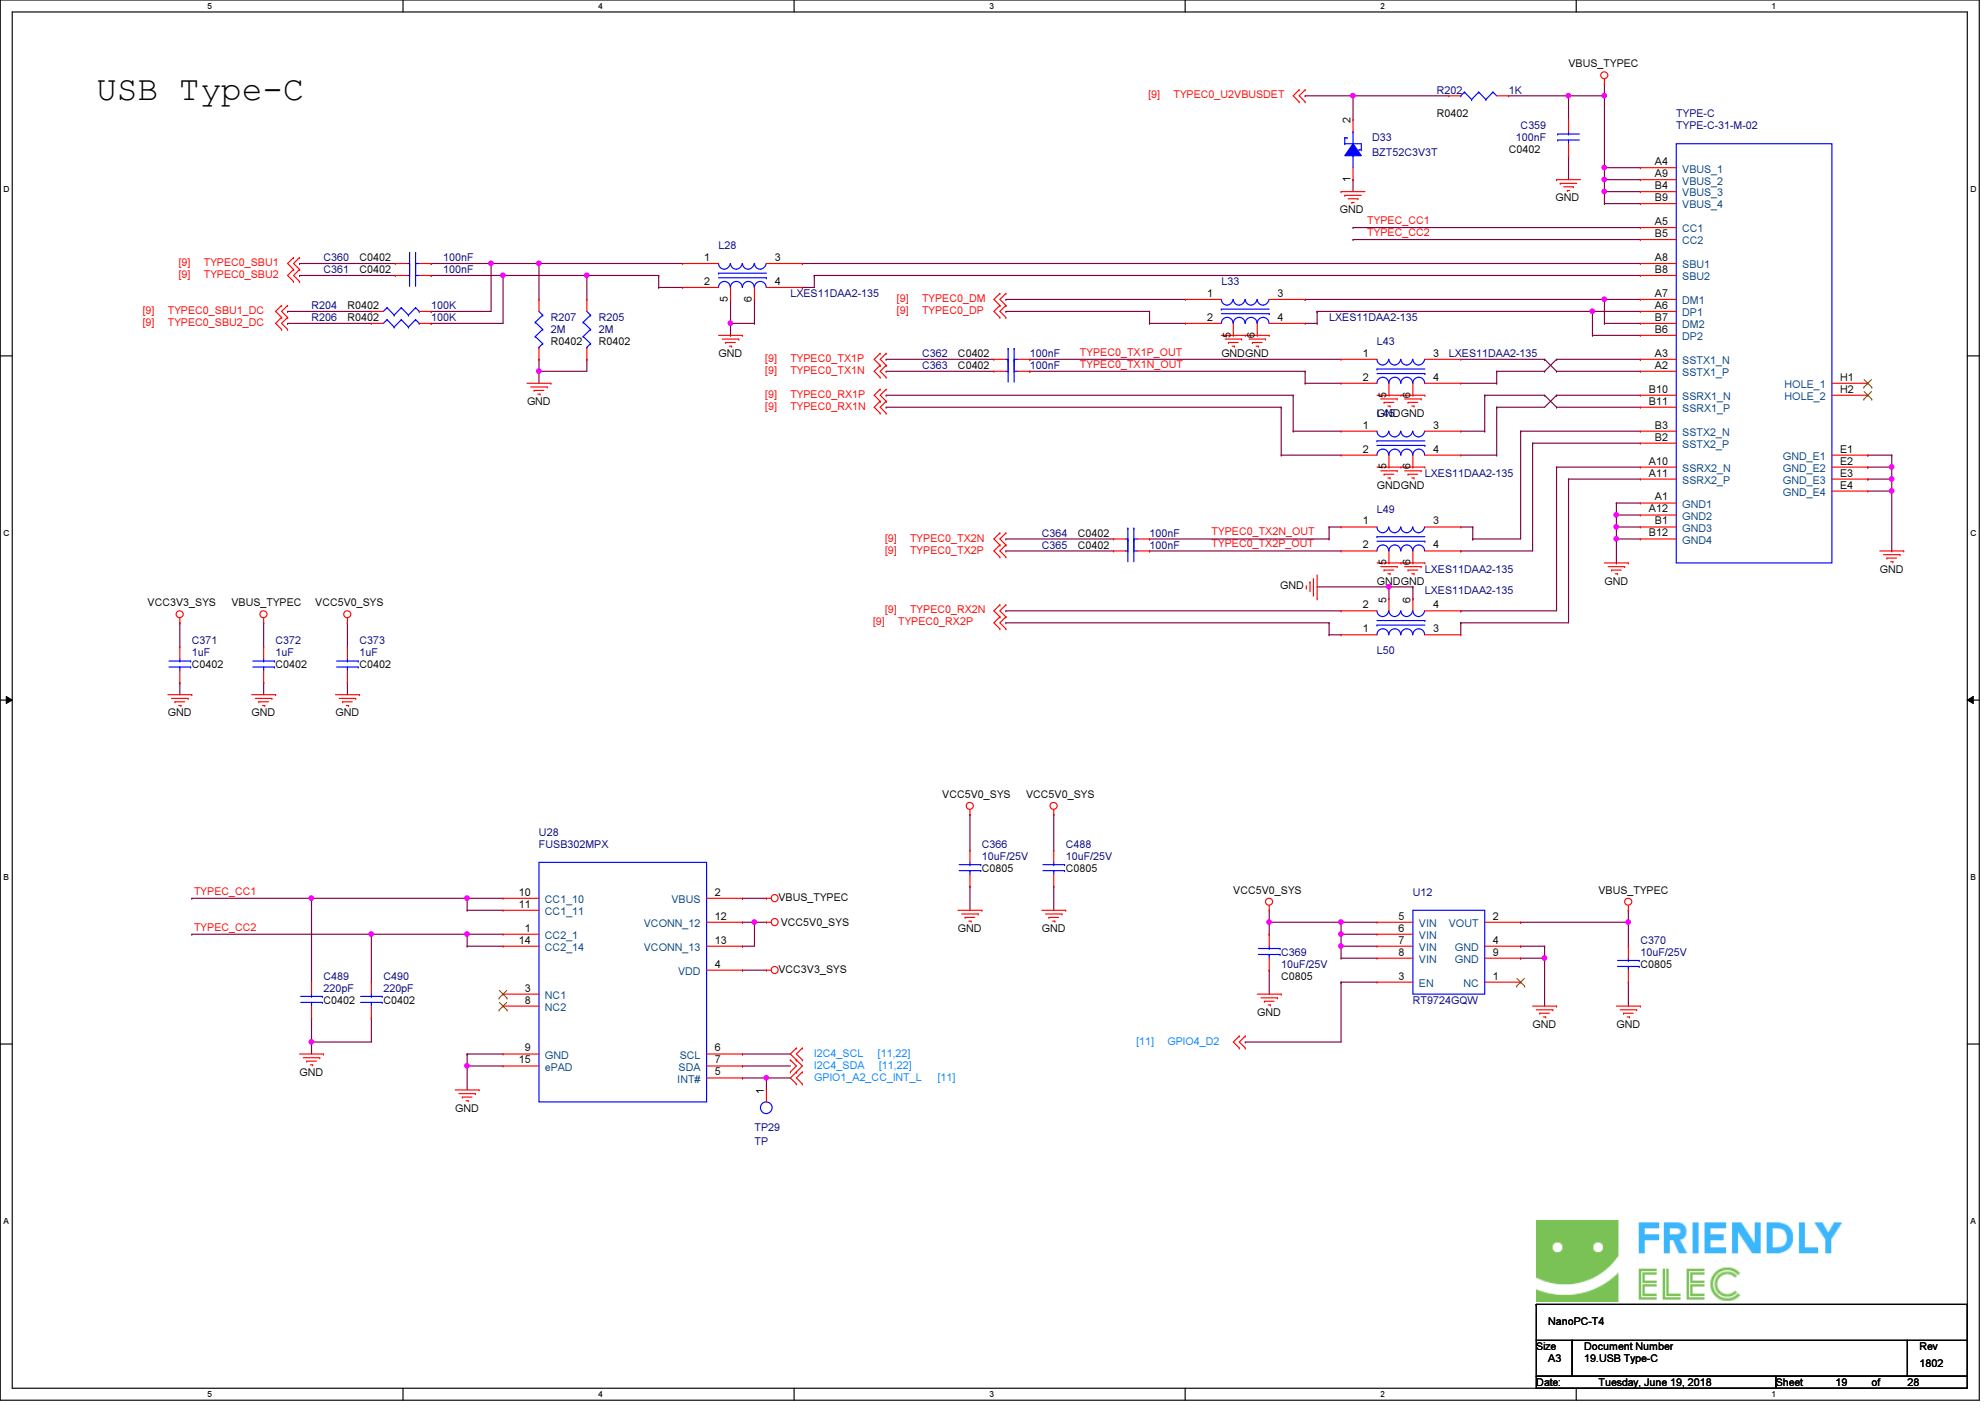
[picture p35: page 19]

# USB2.0 Host

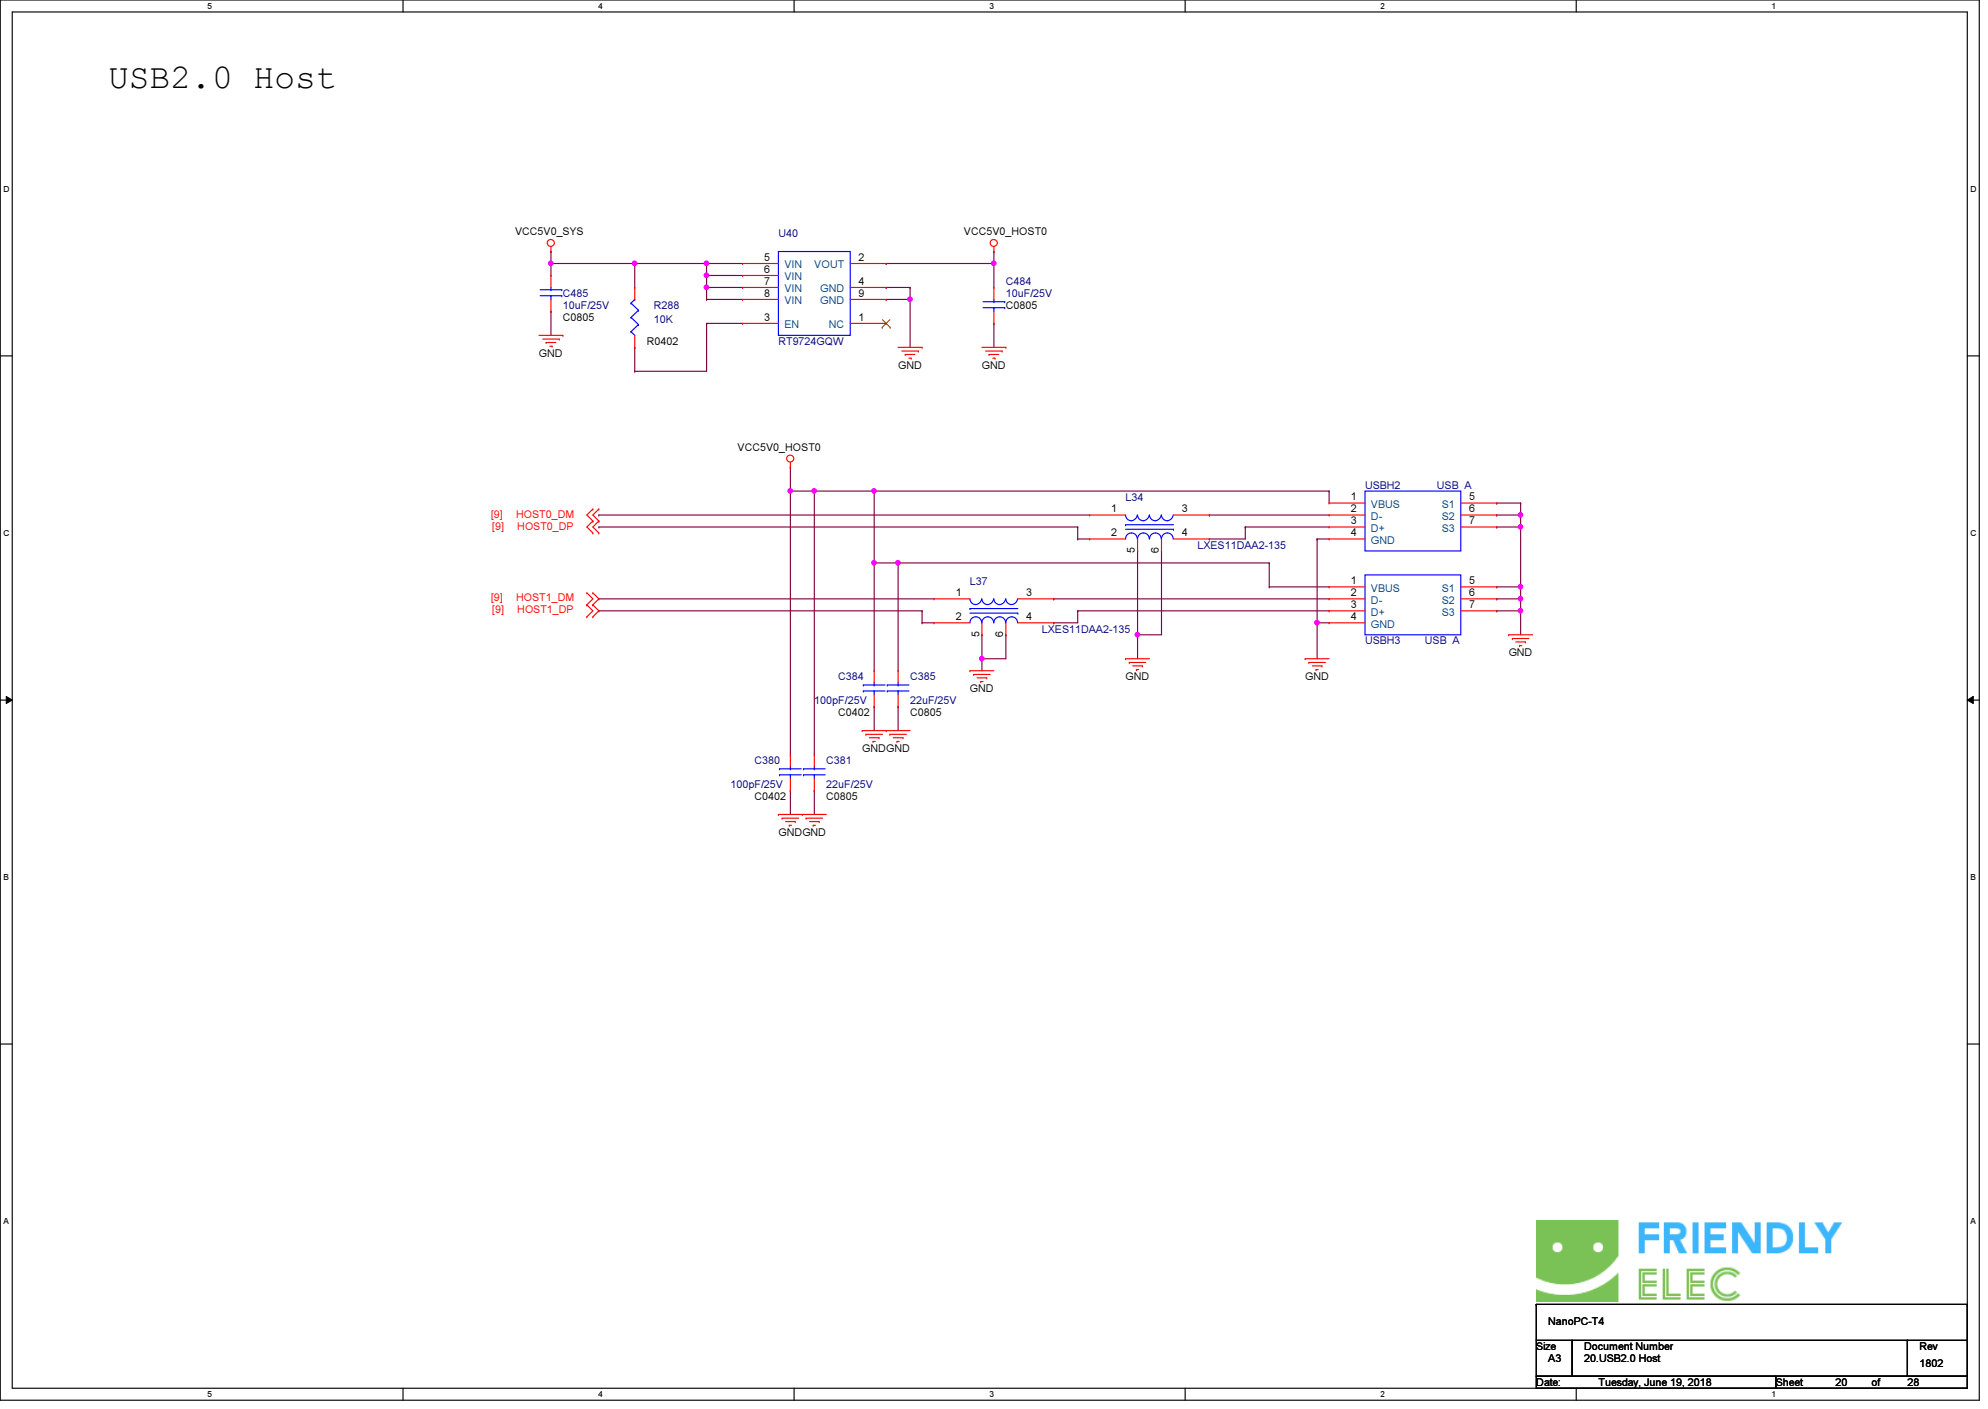
[picture p36: page 20]

# MIPI-CSI

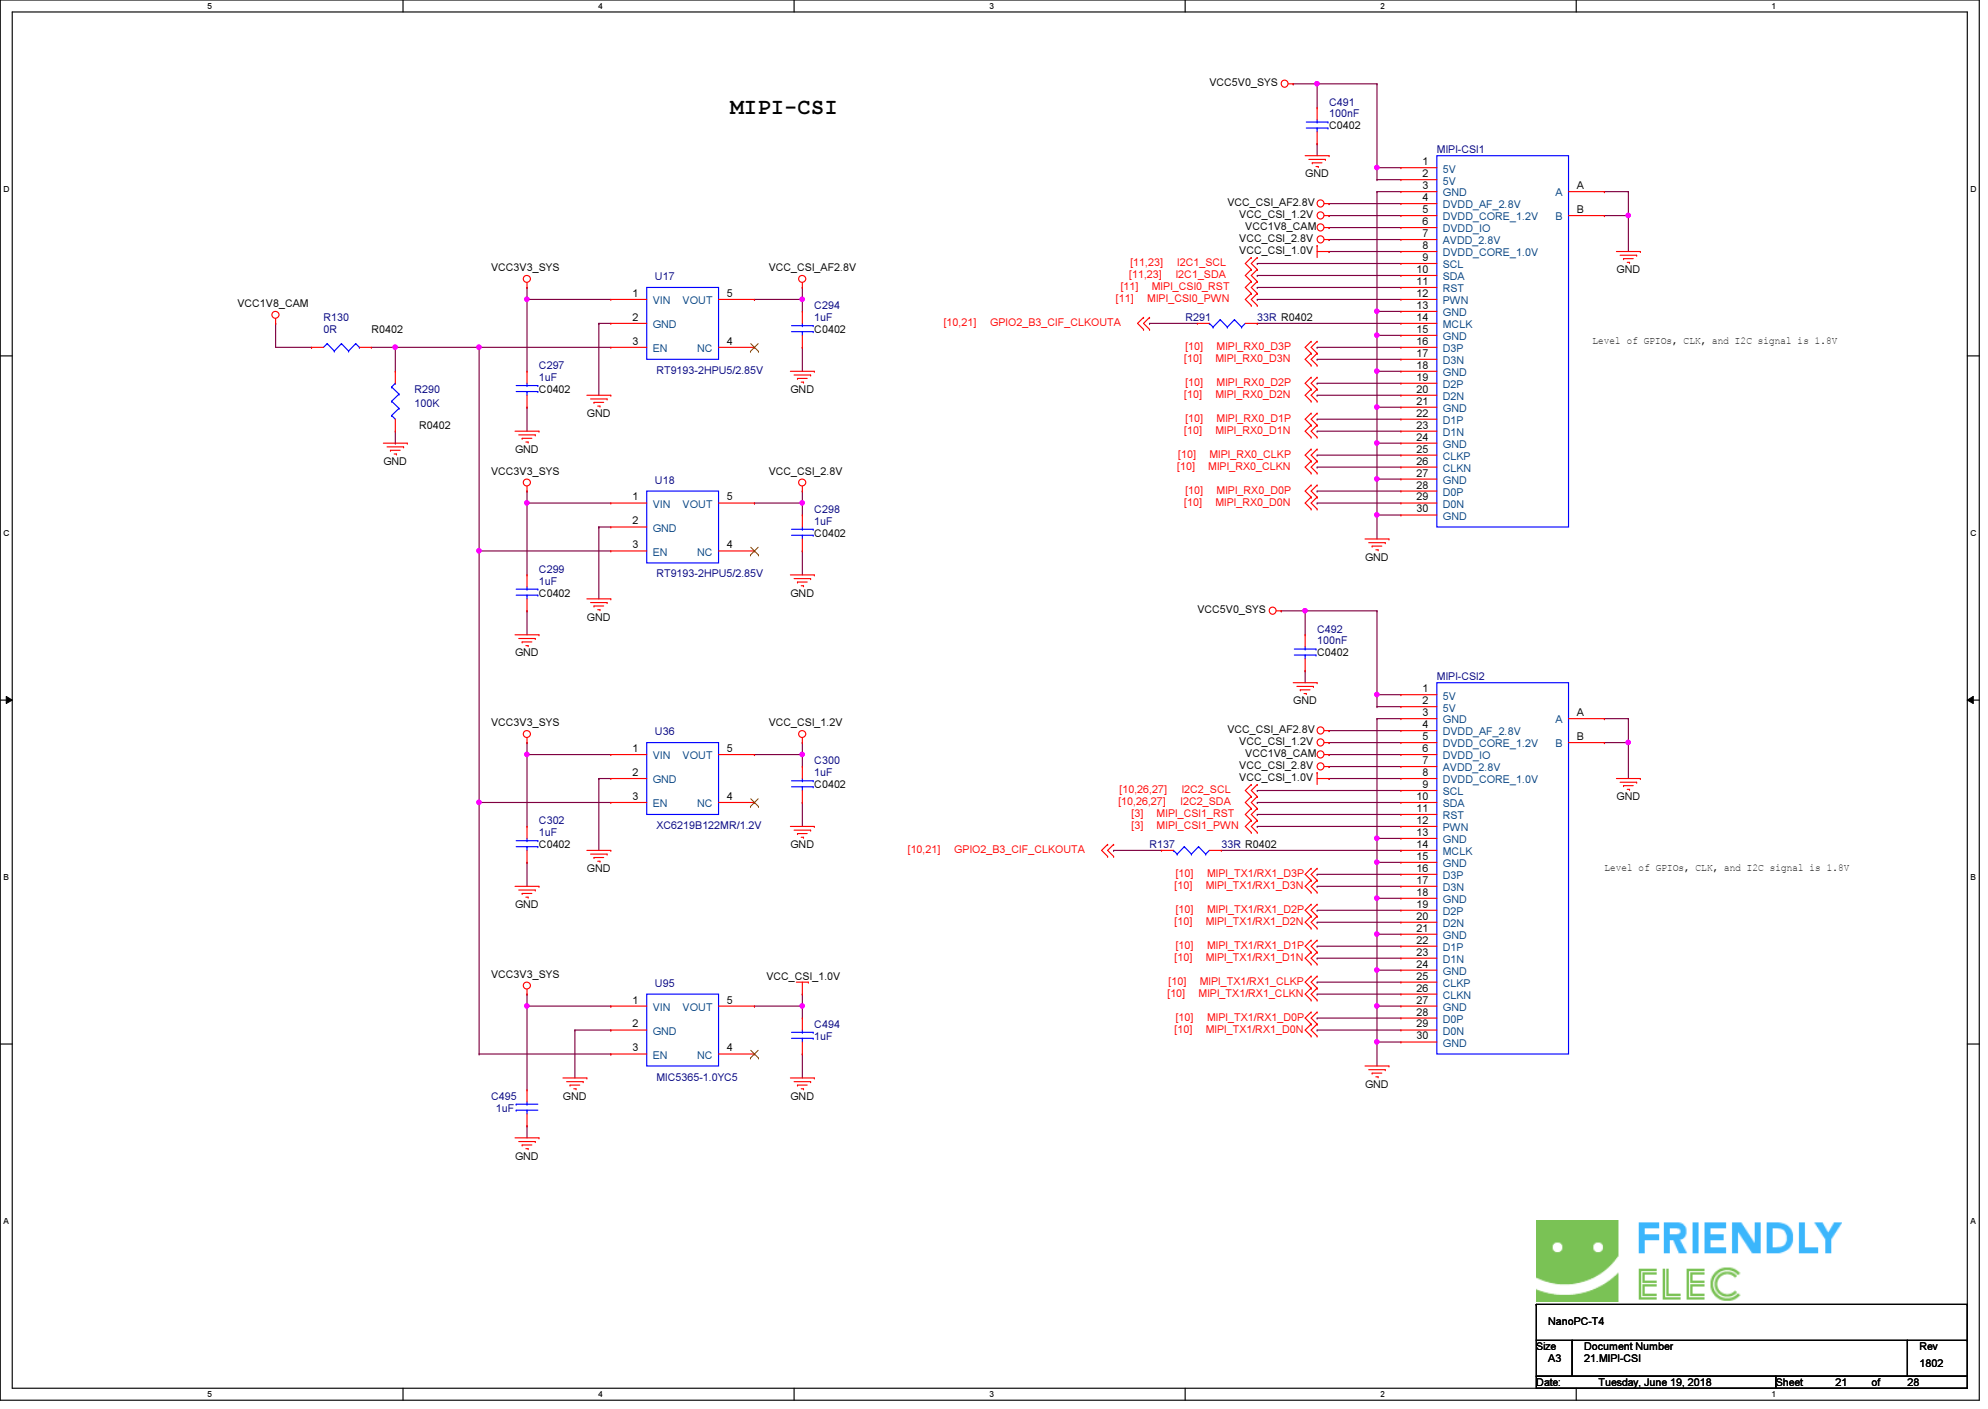
[picture p37: page 21]

Level of GPIOs, CLK, and I2C signal is 1.8V

D | D

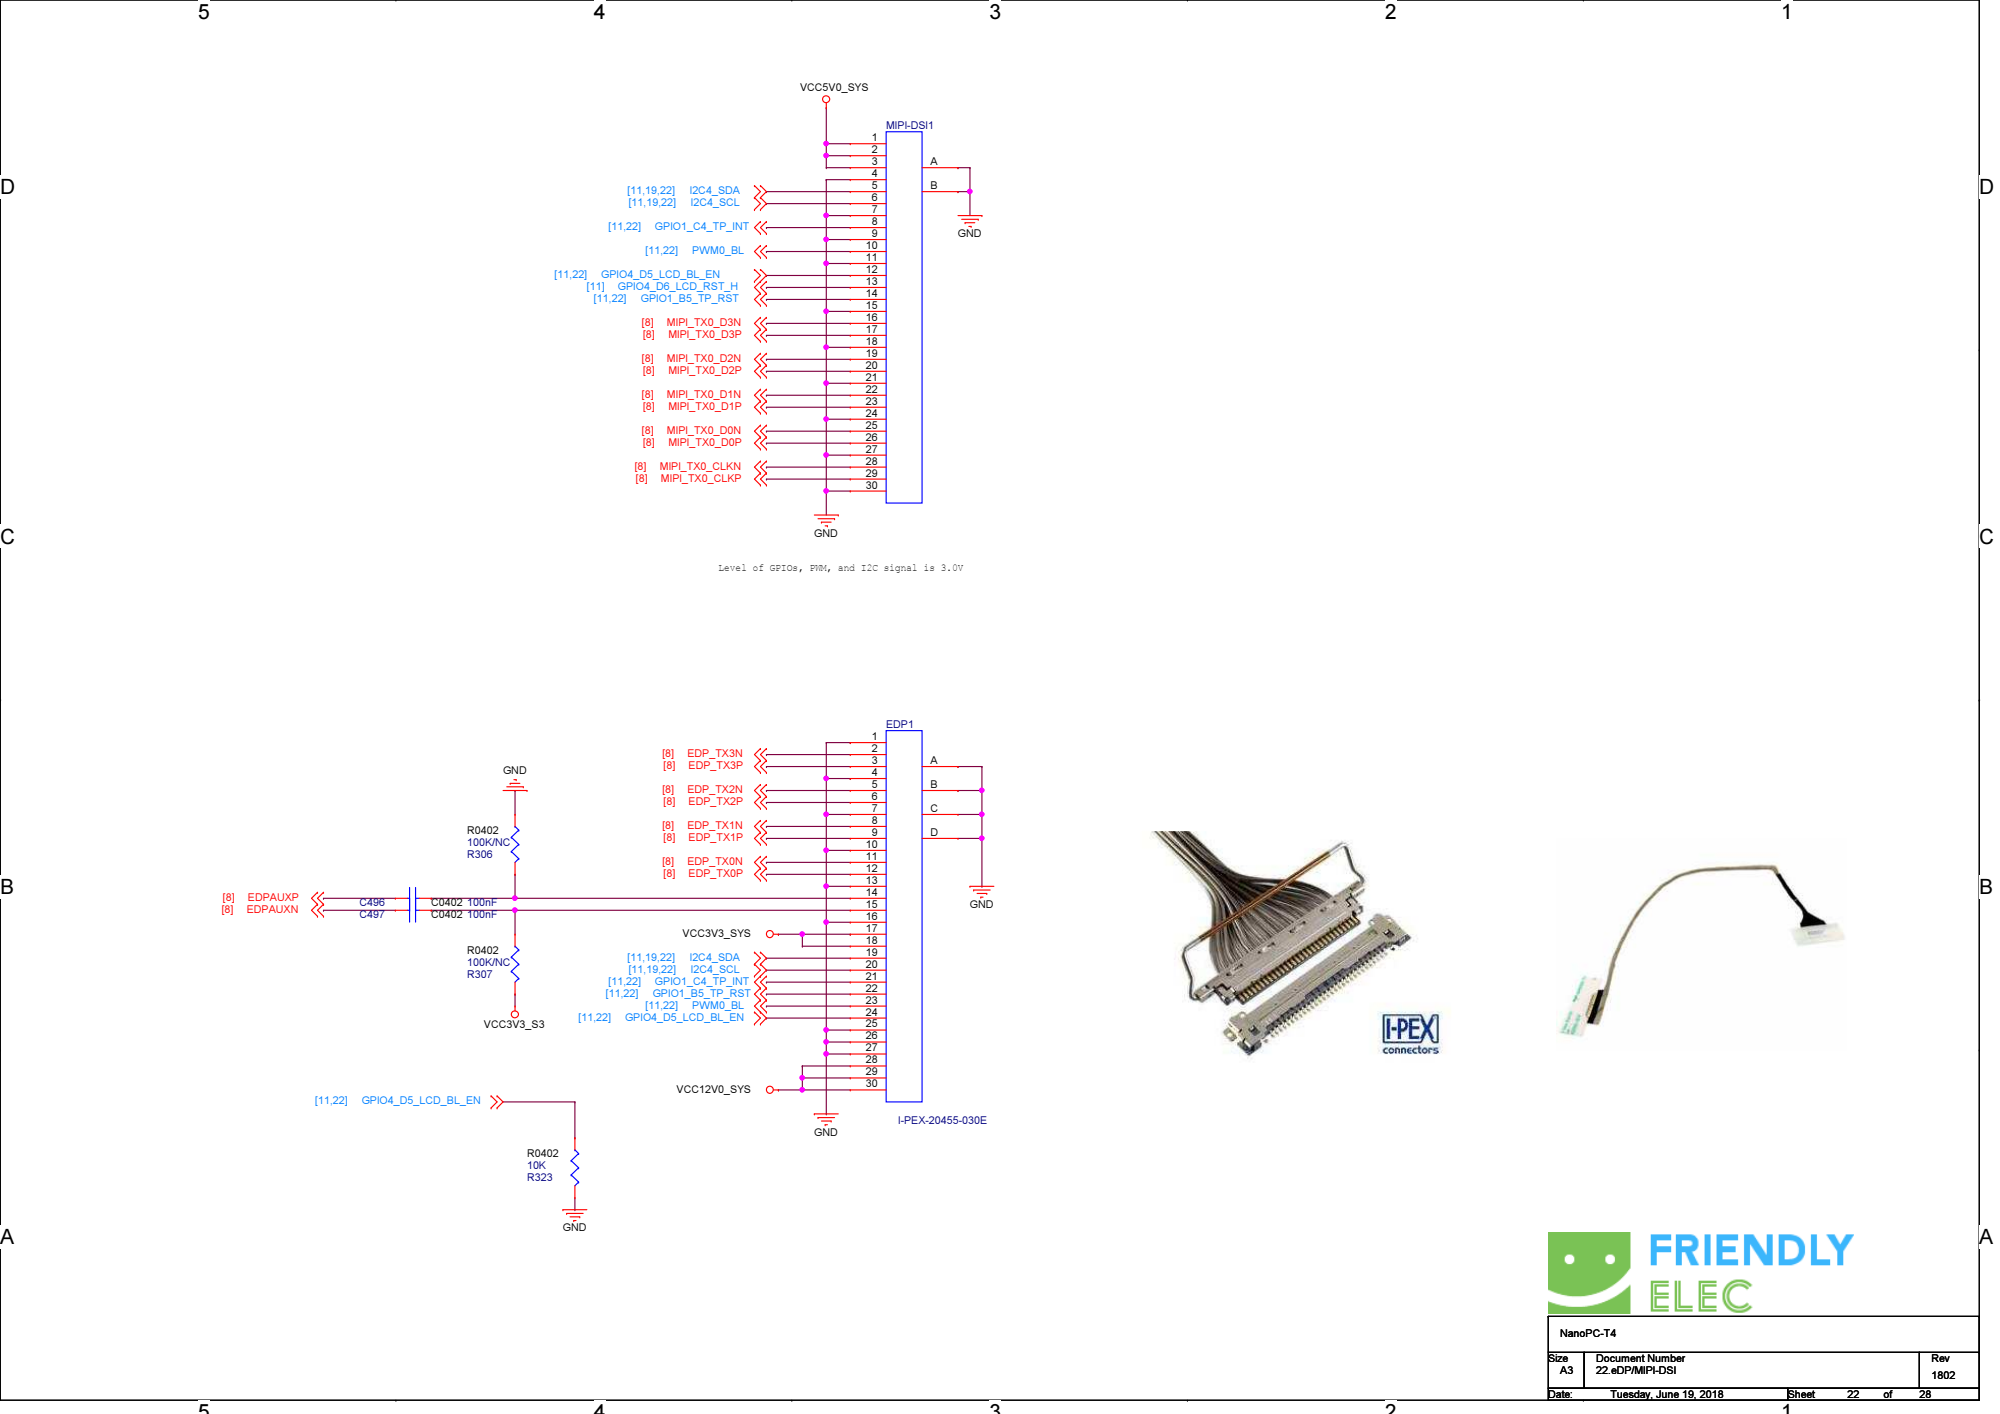
[picture p38: page 22]
VCC5V0_SYS; GND; VCC3V3_S3; VCC12V0_SYS; VCC3V3_SYS; [8] MIPI_TX0_D3N [8] MIPI_TX0_D3P; [8] MIPI_TX0_D2N [8] MIPI_TX0_D2P; [8] MIPI_TX0_D1P; [8] MIPI_TX0_D1N; [8] MIPI_TX0_CLKP; [8] MIPI_TX0_CLKN; [8] MIPI_TX0_D0P; [8] MIPI_TX0_D0N; GPIO1_C4_TP_INT; PWM0_BL; [11] GPIO4_D6_LCD_RST_H; GPIO1_B5_TP_RST; I2C4_SDA; I2C4_SCL; [8] EDP_TX1N [8] EDP_TX1P; [8] EDP_TX0P; [8] EDP_TX0N; [8] EDPAUXP [8] EDPAUXN; [8] EDP_TX3N; [8] EDP_TX2P; [8] EDP_TX2N; [8] EDP_TX3P; GPIO4_D5_LCD_BL_EN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

Level of GPIOs, PWM, and I2C signal is 3.0V

22.eDP/MIPI-DSI

# CODEC

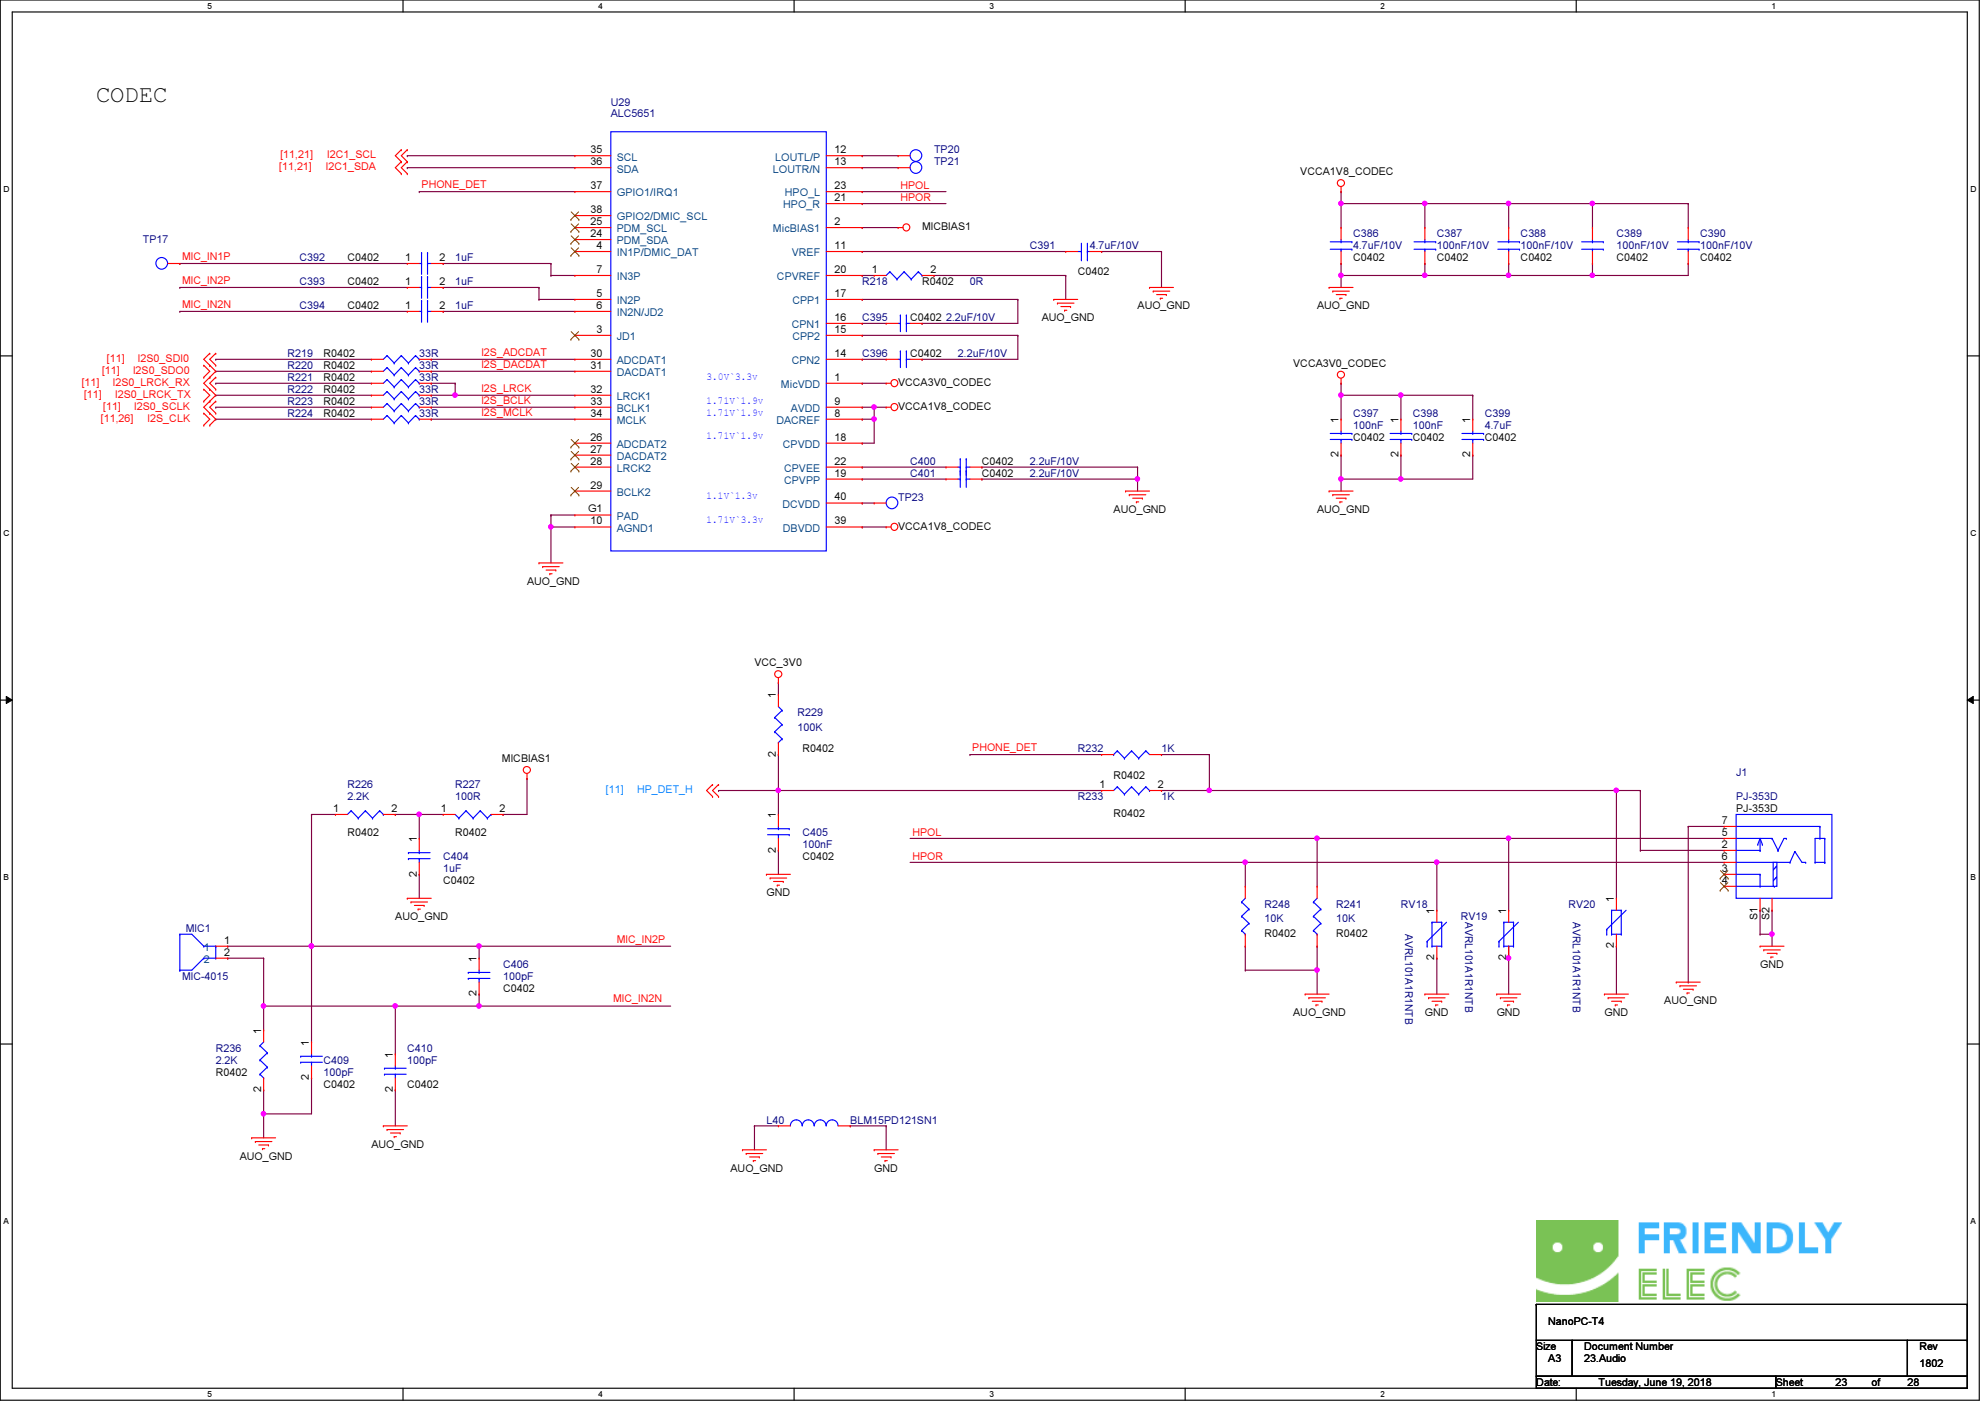
[picture p39: page 23]

D | D

## 50 Ohm RF trace

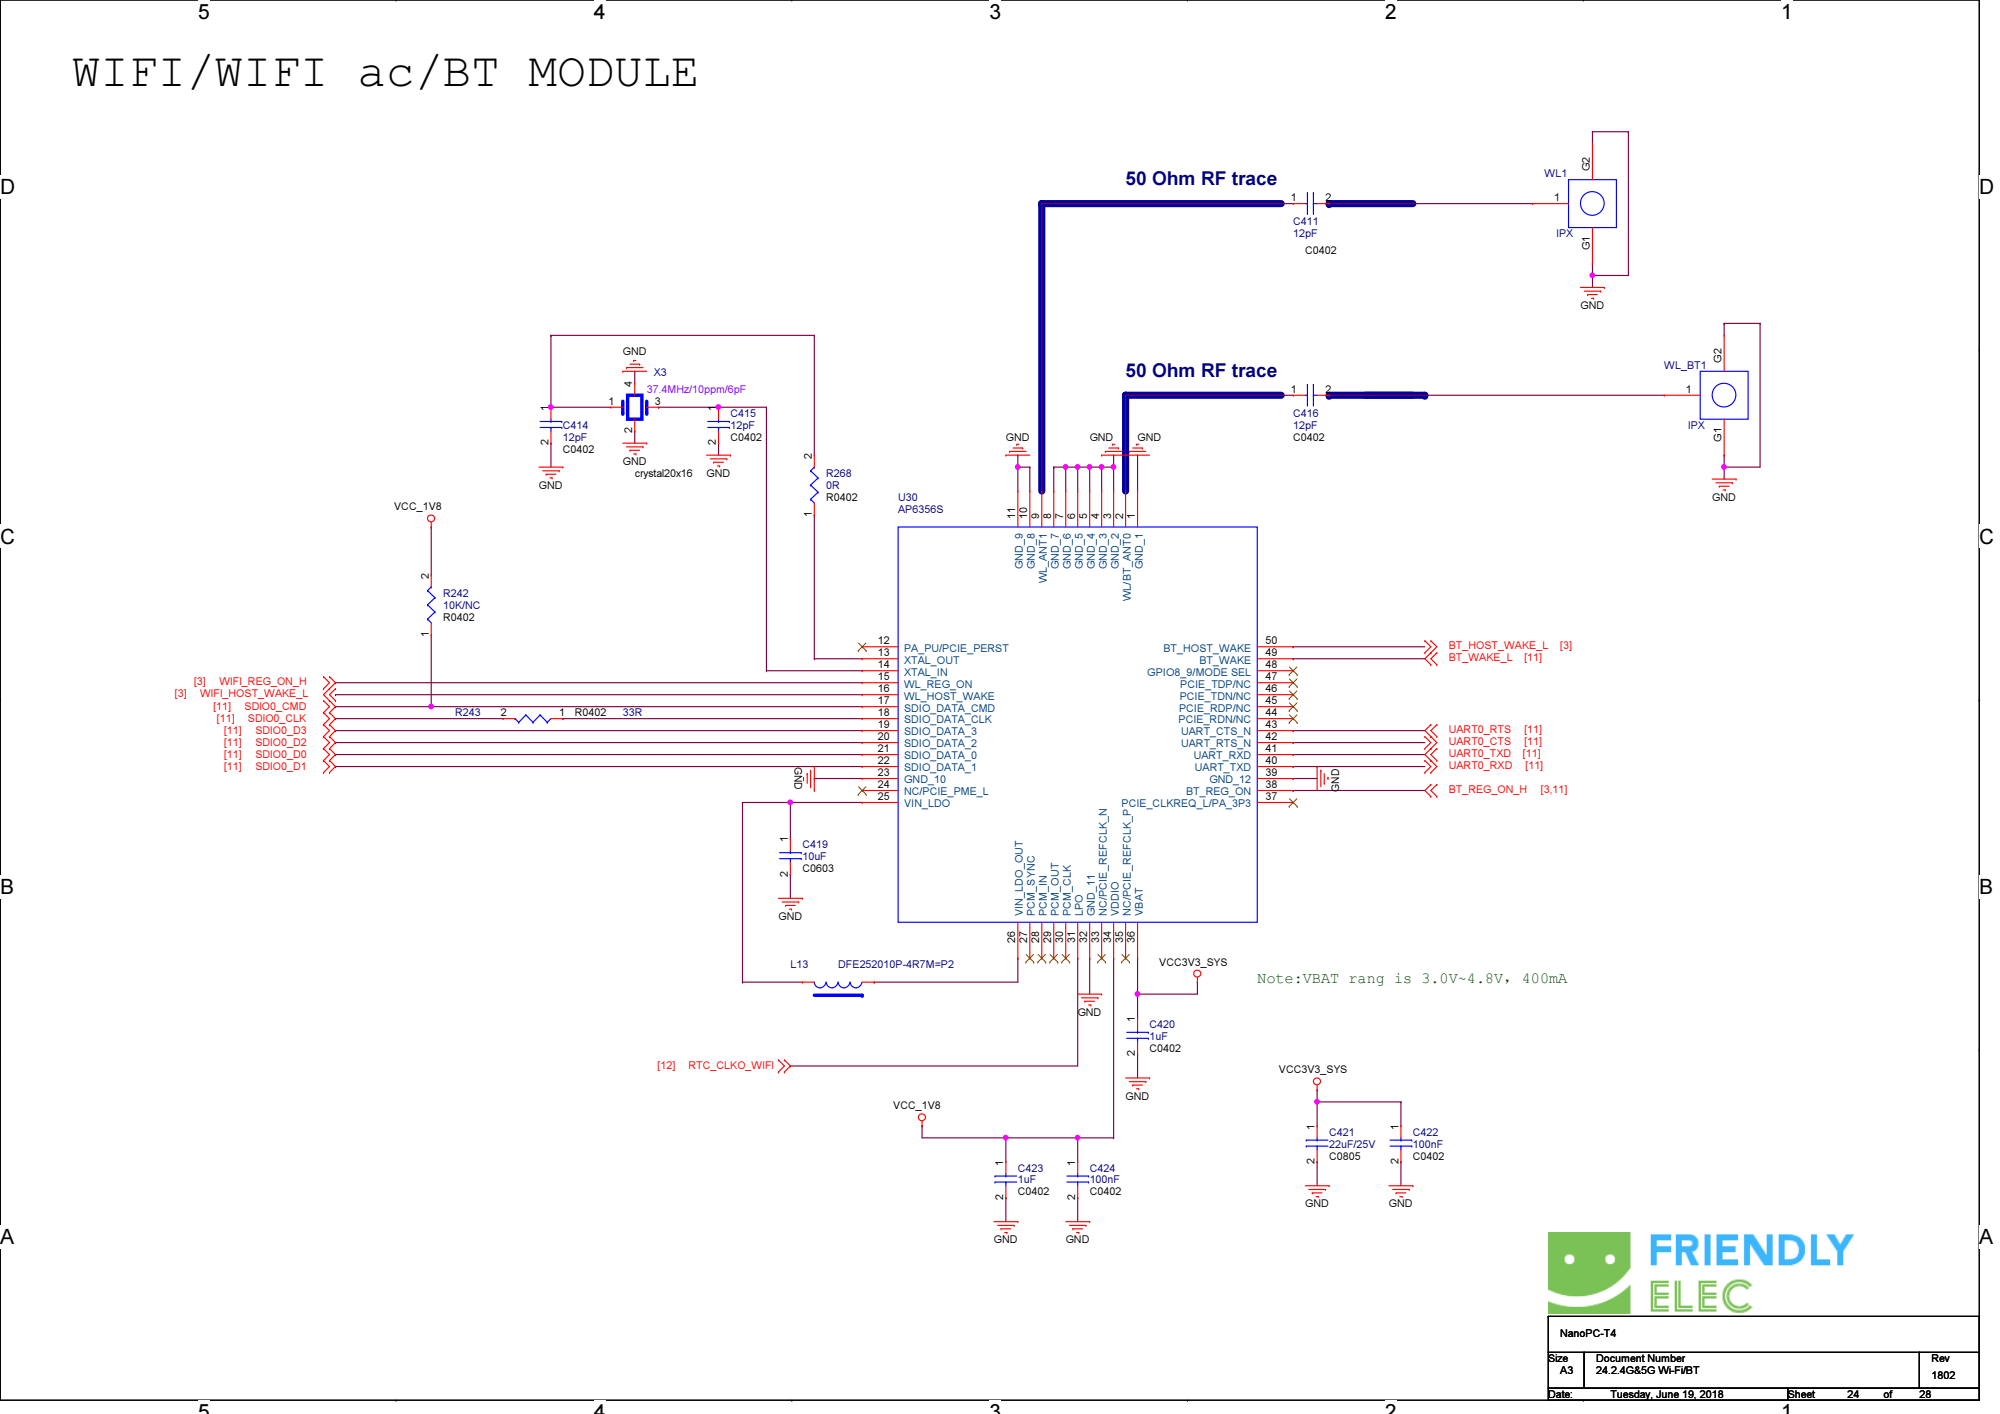
[picture p40: page 24]

WIFI/WIFI ac/BT MODULE

Note:VBAT rang is 3.0V~4.8V，400mA

D | D

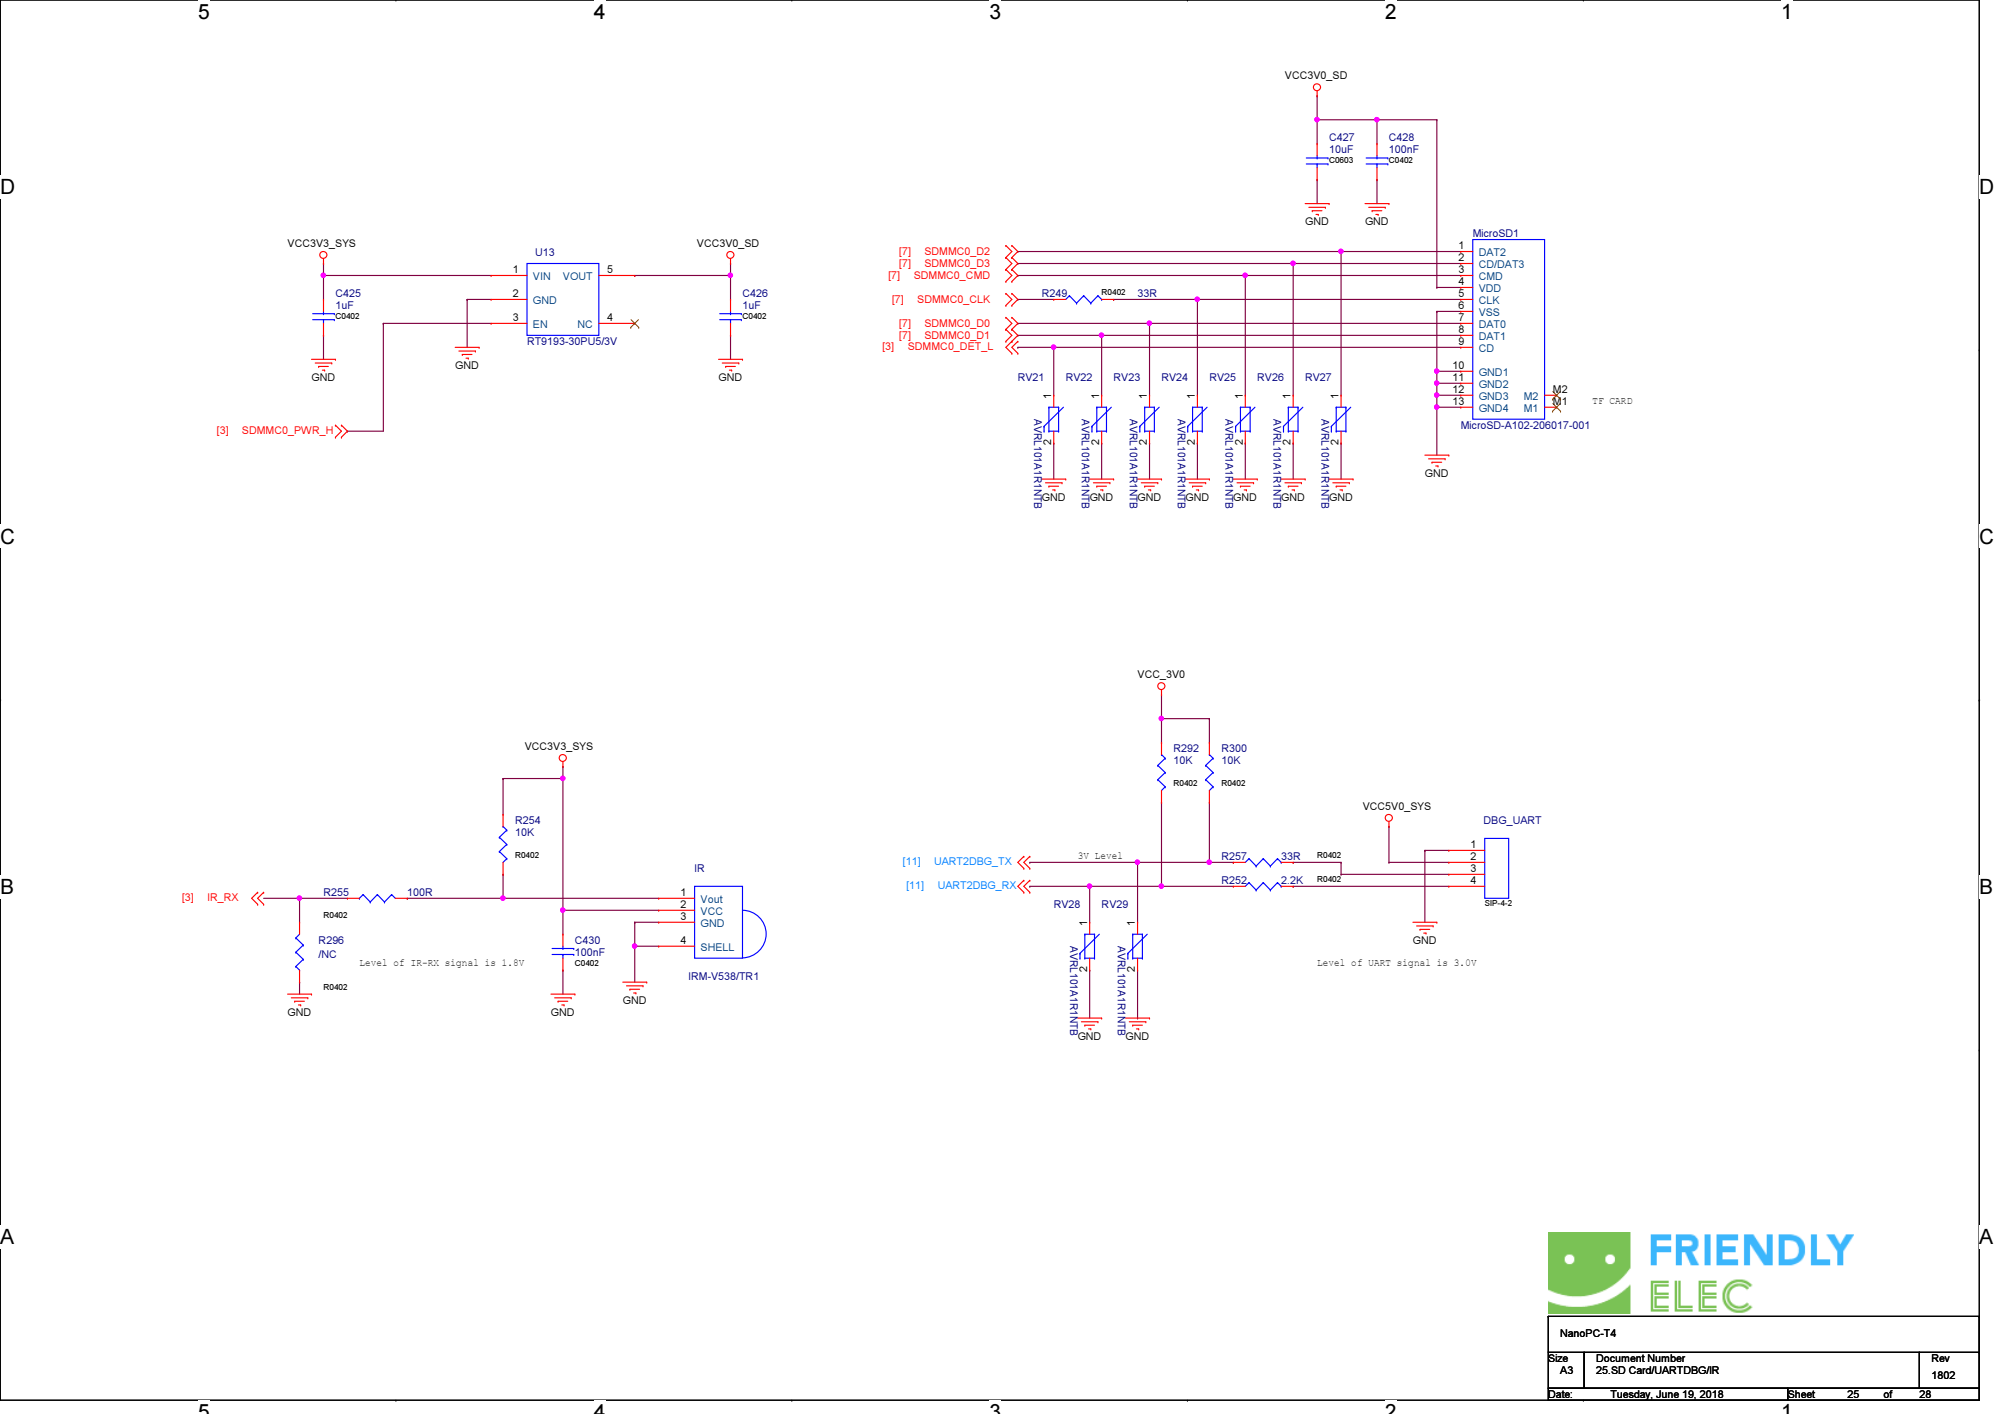
[picture p41: page 25]

25.SD Card/UARTDBG/IR

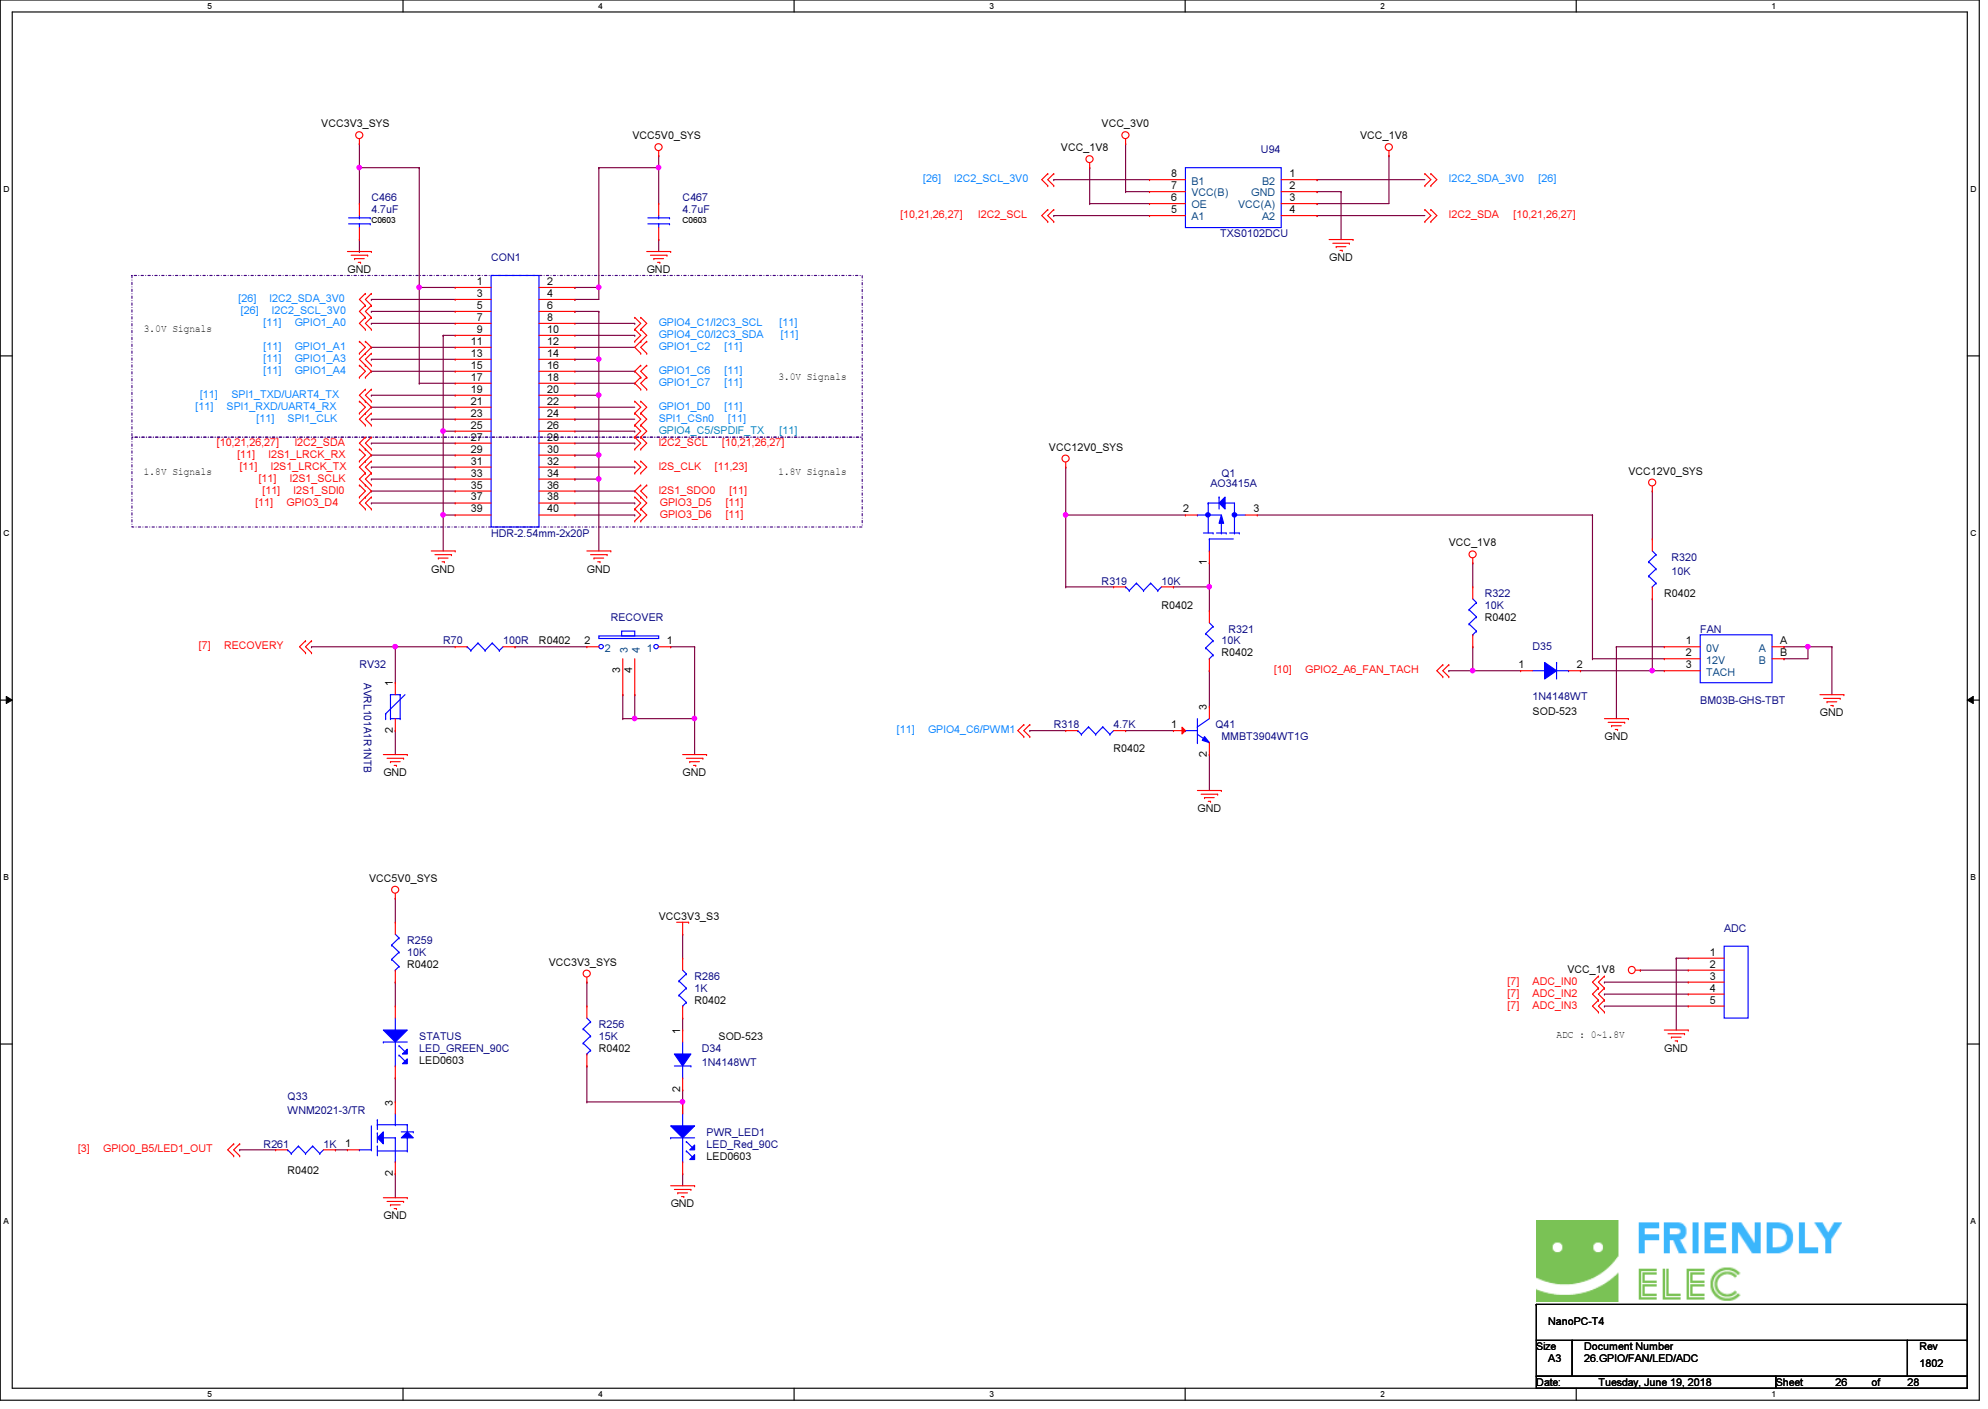
[picture p42: page 26]

26.GPIO/FAN/LED/ADC

D | D

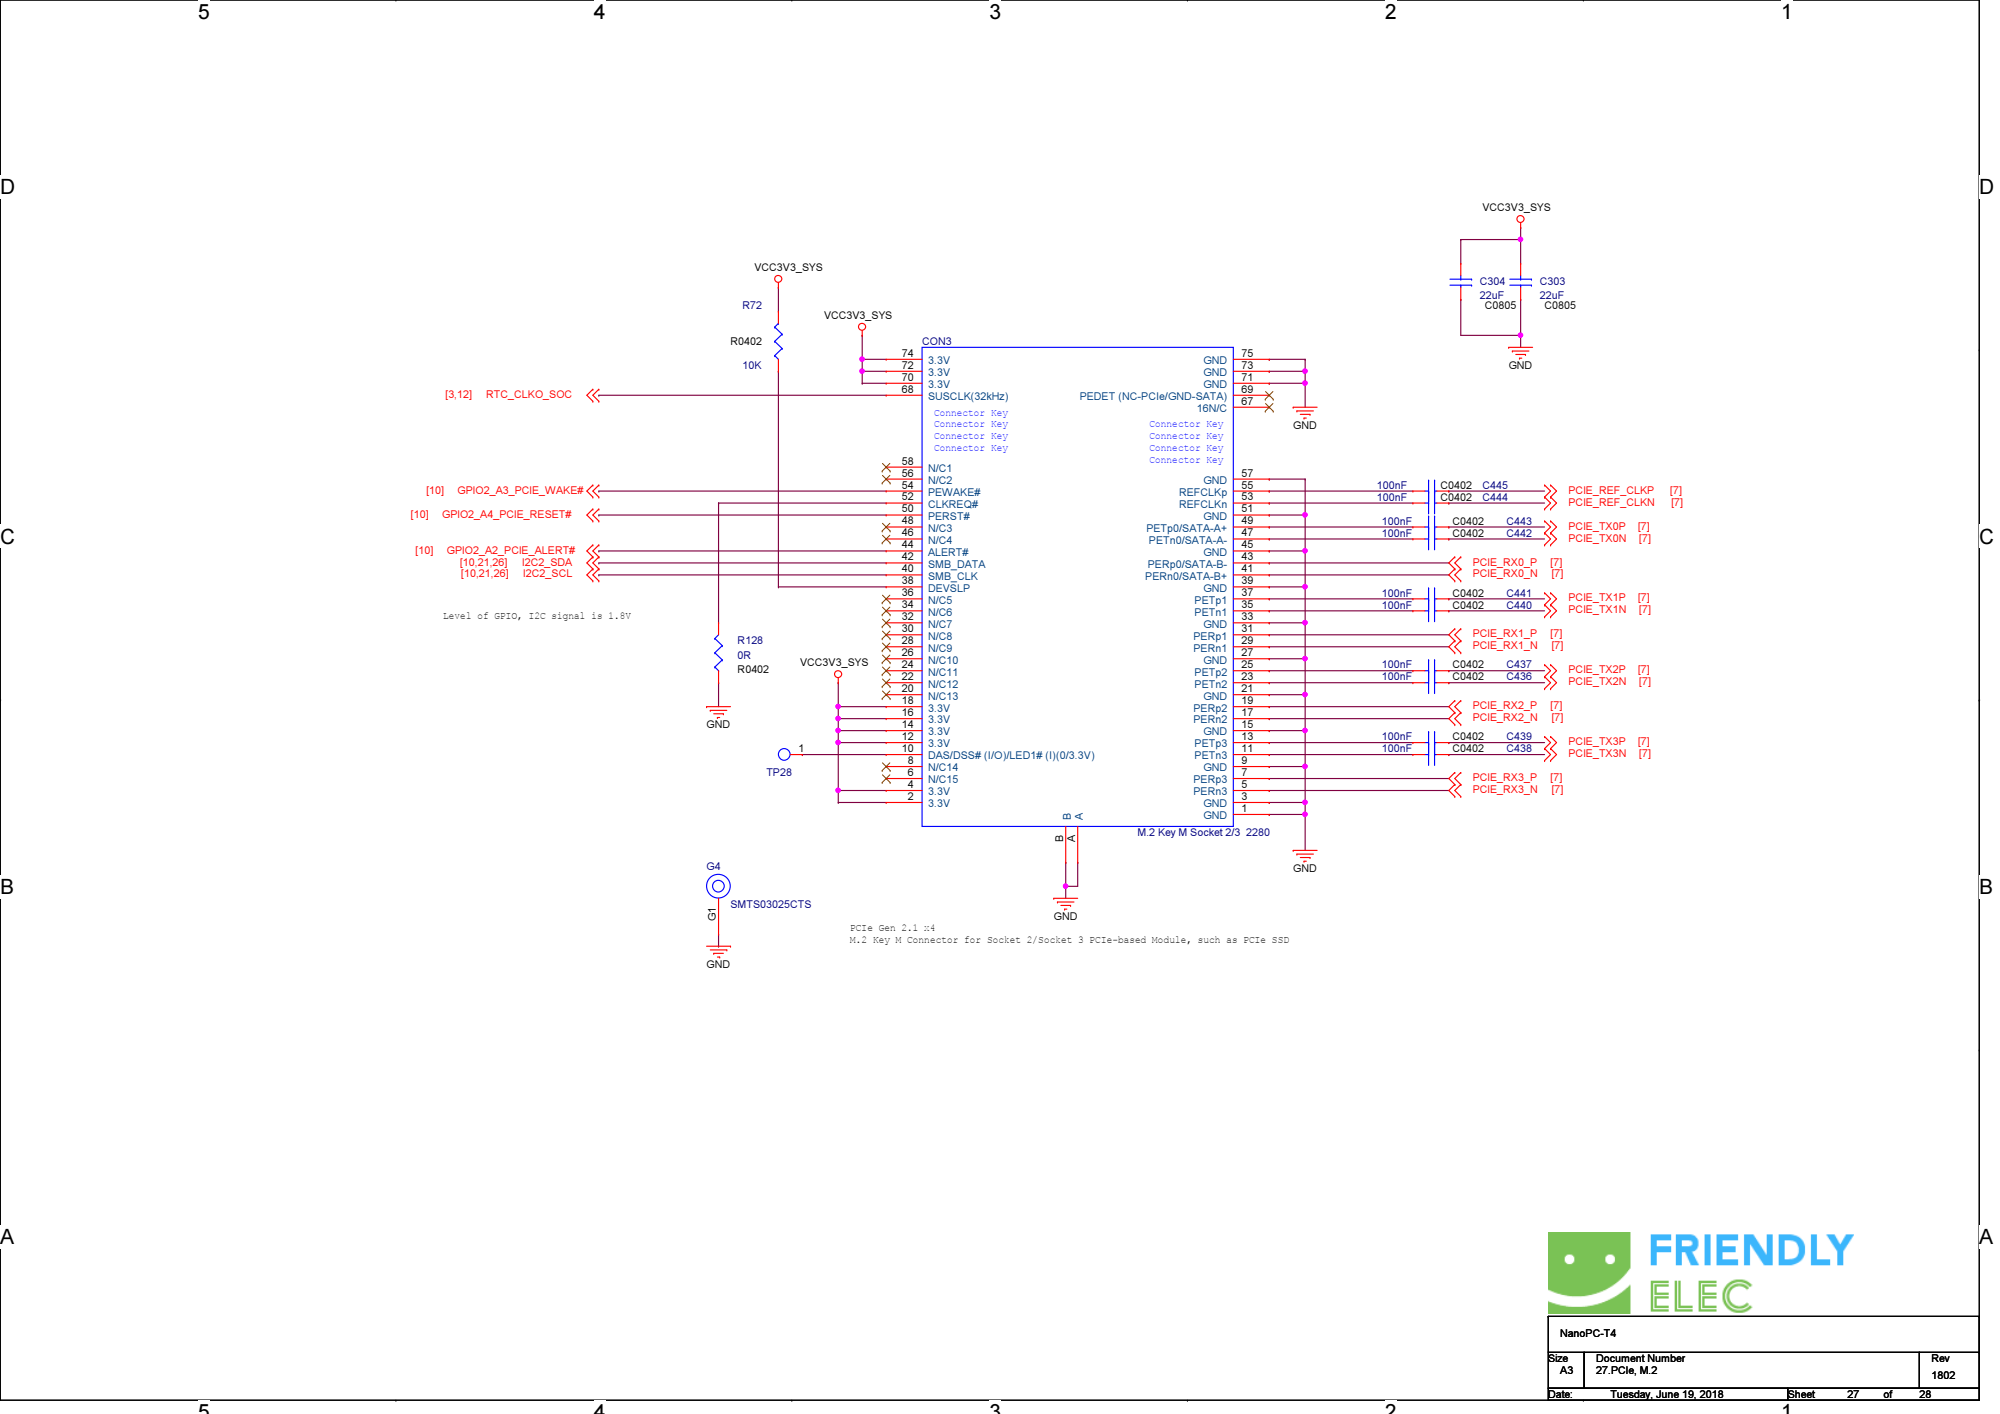
[picture p43: page 27]

Level of GPIO, I2C signal is 1.8V

PCIe Gen 2.1 x4
M.2 Key M Connector for Socket 2/Socket 3 PCIe-based Module, such as PCIe SSD

D | D

# USB3.0 Host

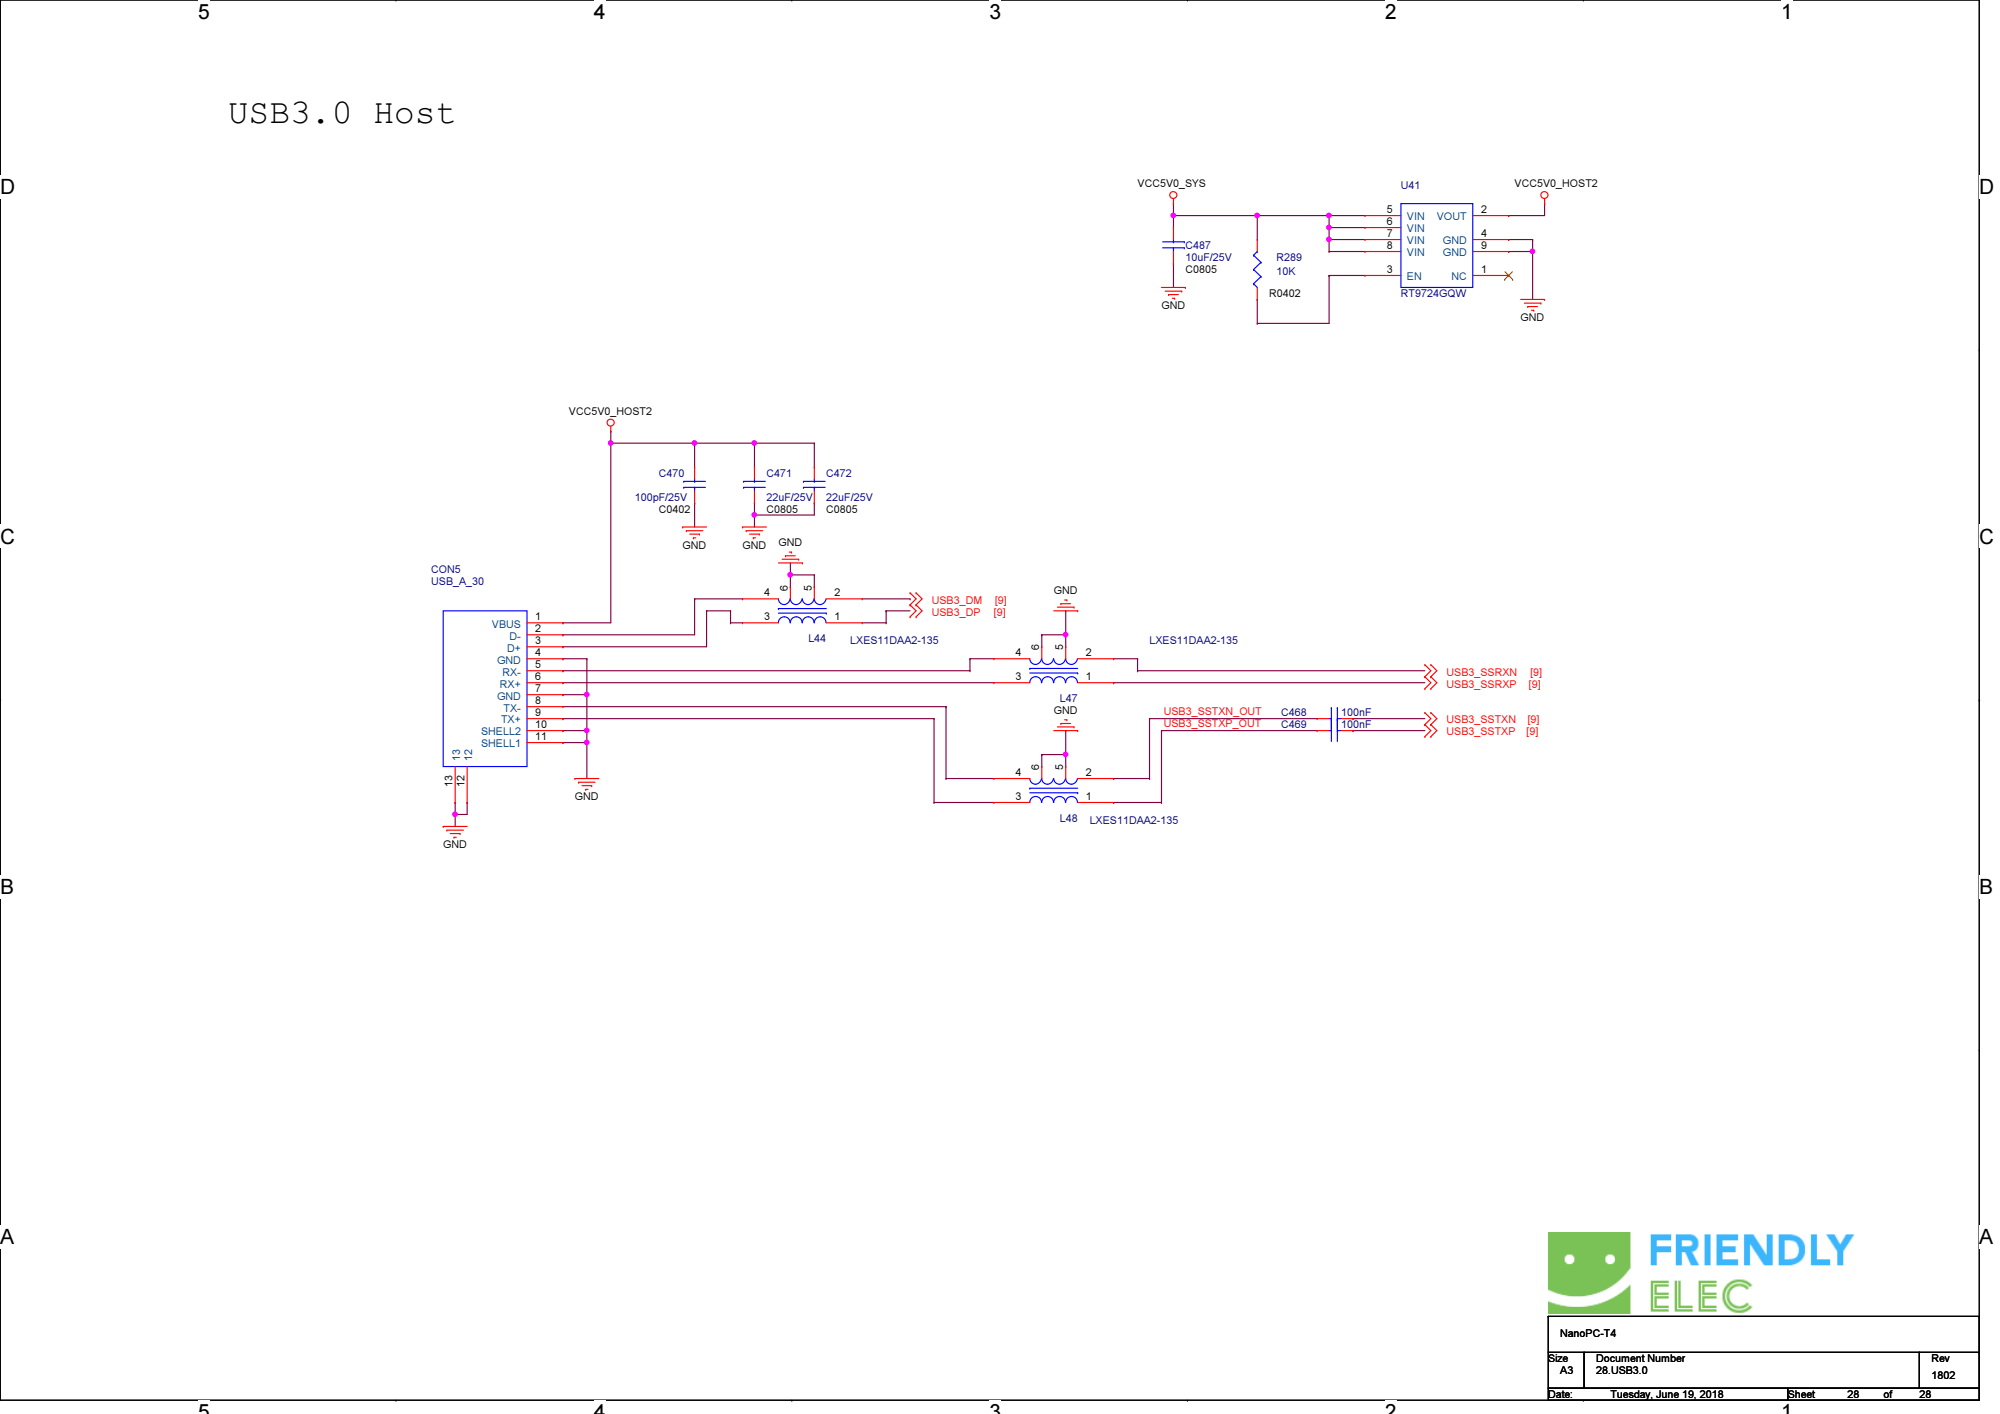
[picture p44: page 28]
