uibk-dps-teaching/cluster-coffer/docs/inc/ccpad_schematic.pdf

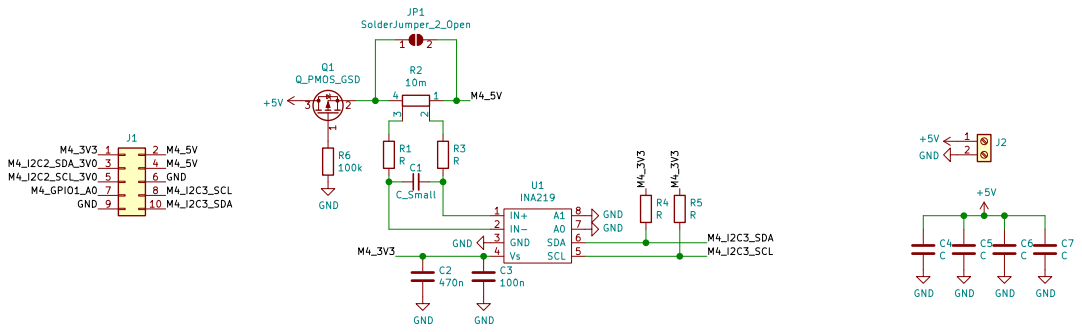
[picture p45: page 1]

File: ccpad.sch Sheet: /
Id: 1/1 Title: Cluster Coffer ccpad
