uibk-dps-teaching/cluster-coffer/docs/inc/ccpdu_schematic.pdf

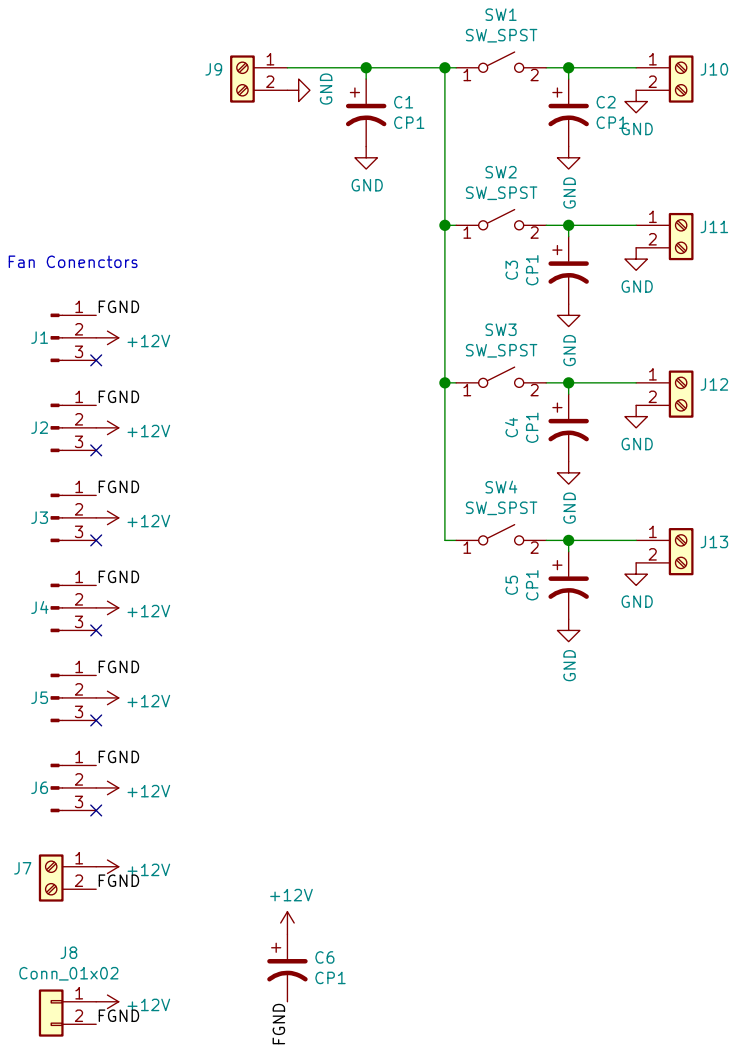
[picture p46: page 1]

File: ccpdu.sch Sheet: / 123

Id: 1/1 Title: Cluster Coffer ccpdu
