uibk-dps-teaching/cluster-coffer/electronics/ccpad/f.cu/ccpad-F_Cu.pdf

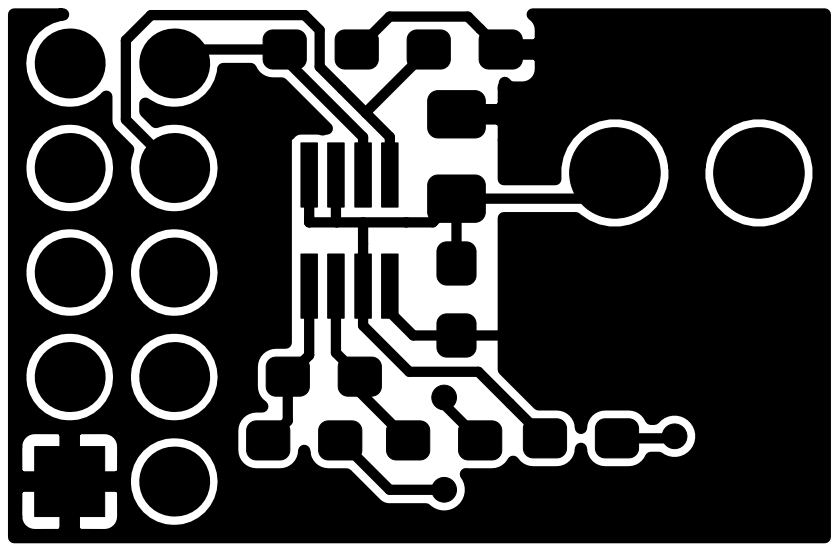
[picture p47: page 1]
