uibk-dps-teaching/cluster-coffer/docs/inc/ccpad_bottom.pdf

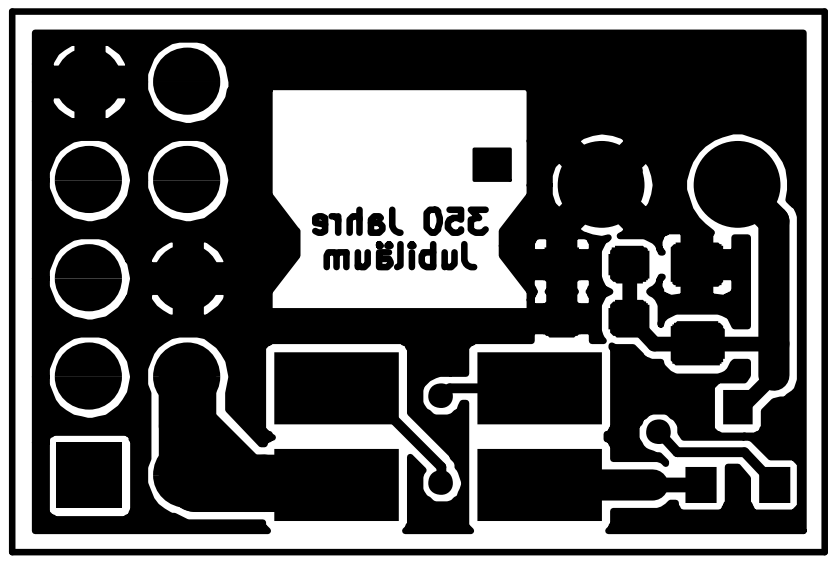
[picture p48: page 1]
