uibk-dps-teaching/cluster-coffer/docs/inc/ccpad_drill.pdf

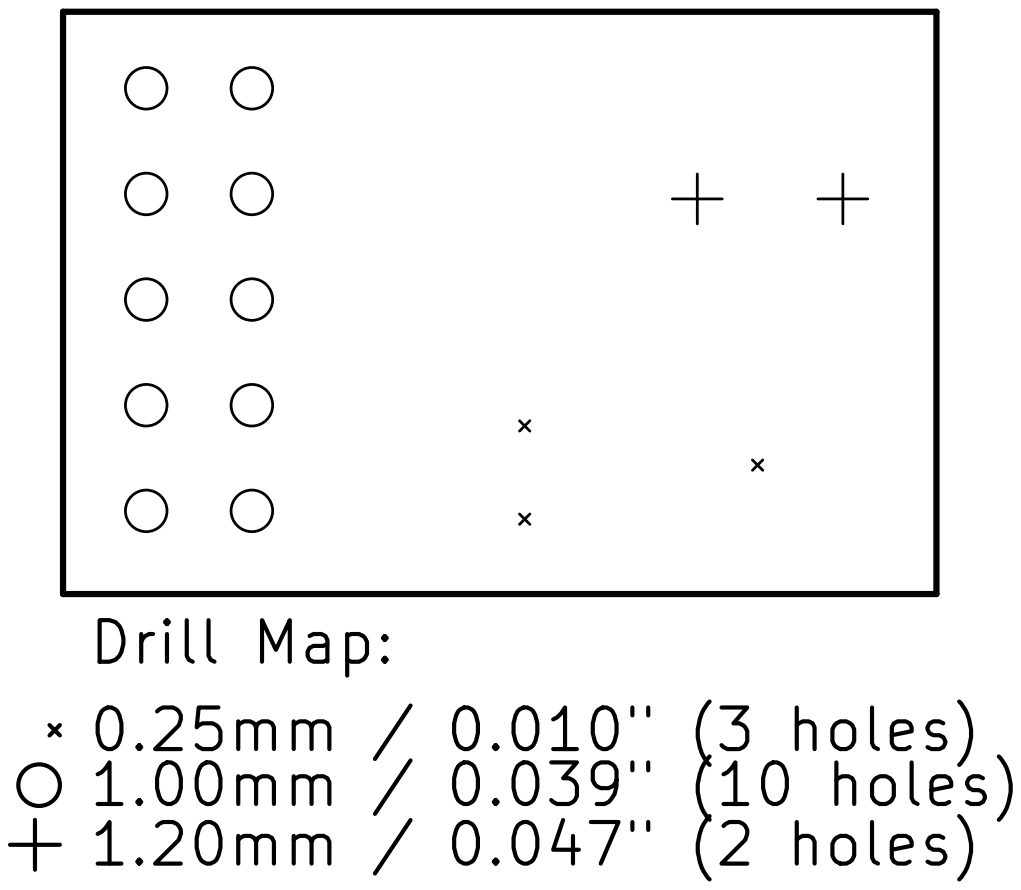
[picture p49: page 1]
