uibk-dps-teaching/cluster-coffer/docs/inc/ccpad_silk.pdf

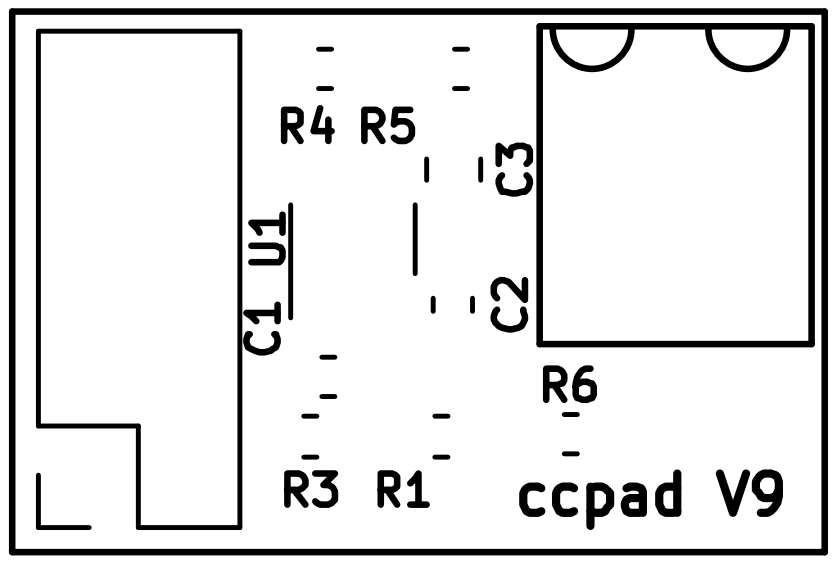
[picture p50: page 1]
