uibk-dps-teaching/cluster-coffer/docs/inc/ccpad_top.pdf

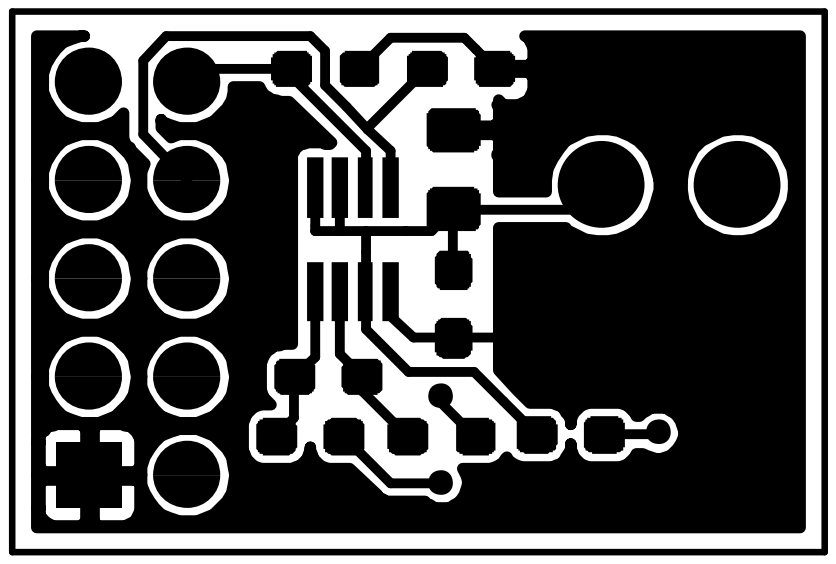
[picture p51: page 1]
