uibk-dps-teaching/cluster-coffer/docs/inc/ccpdu_bottom.pdf

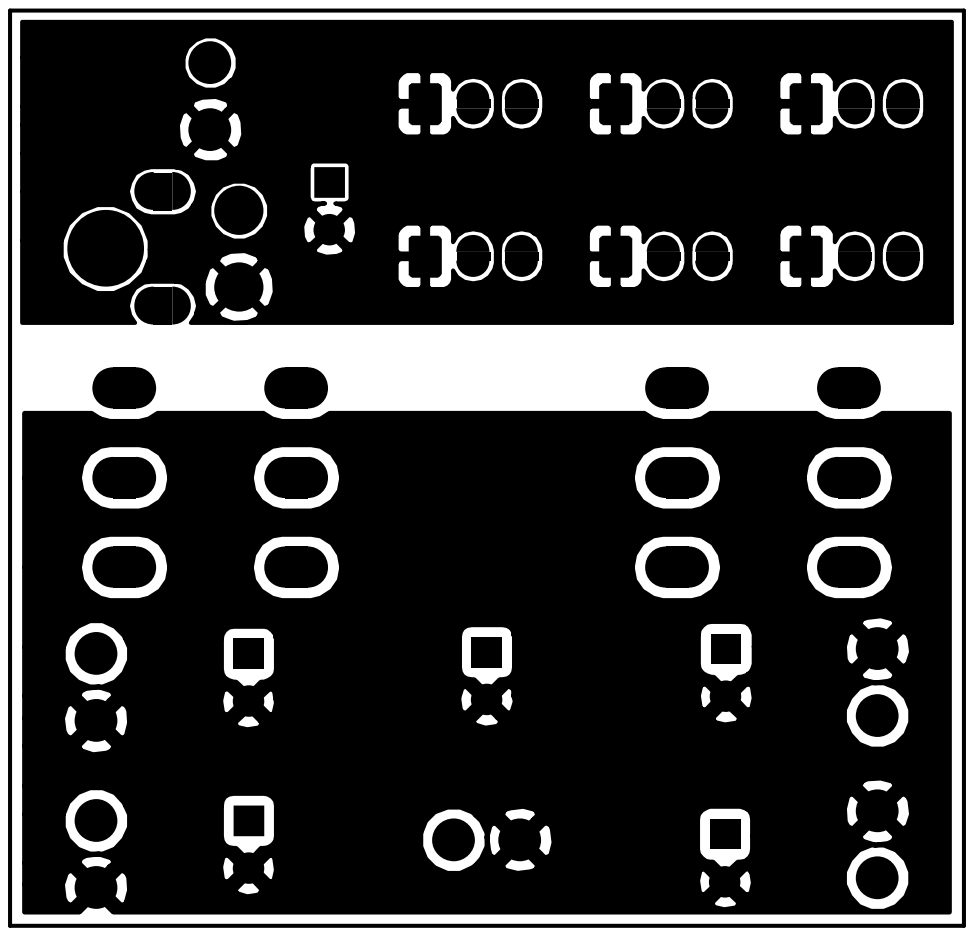
[picture p52: page 1]
