uibk-dps-teaching/cluster-coffer/docs/inc/ccpdu_drill.pdf

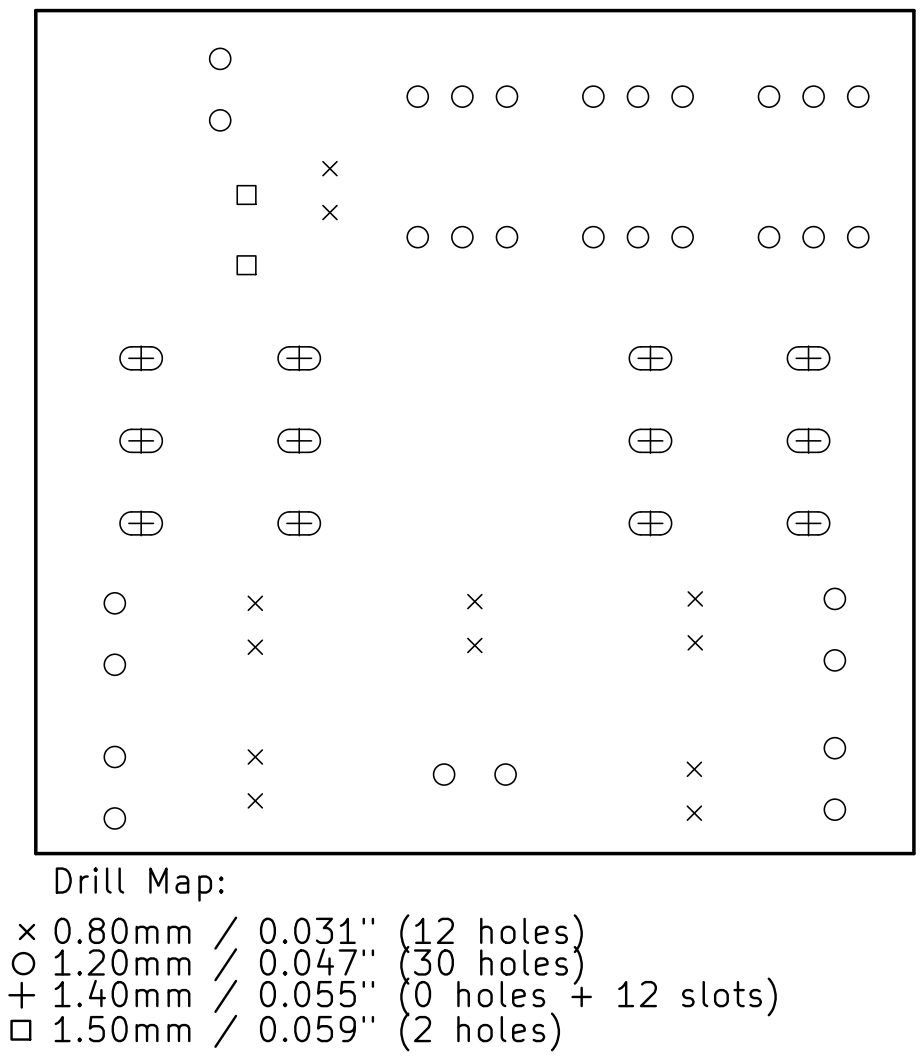
[picture p53: page 1]
