uibk-dps-teaching/cluster-coffer/docs/inc/ccpdu_silk.pdf

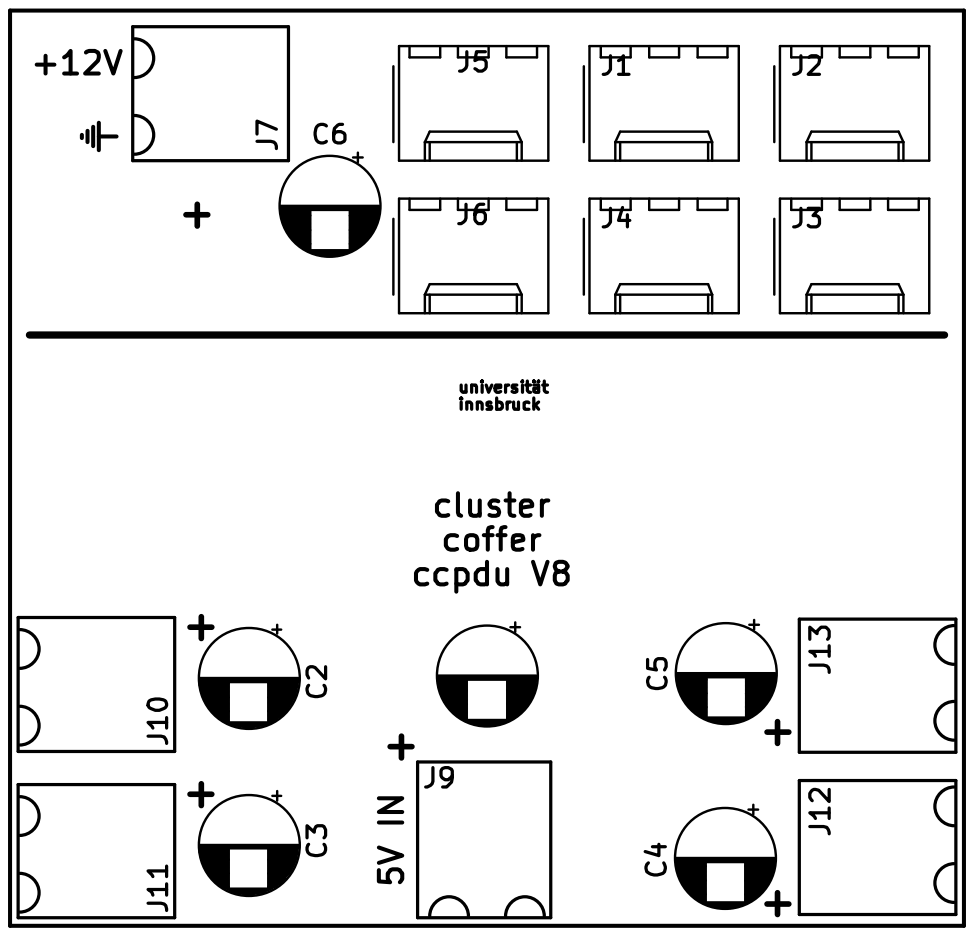
[picture p54: page 1]
