uibk-dps-teaching/cluster-coffer/docs/inc/ccpdu_top.pdf

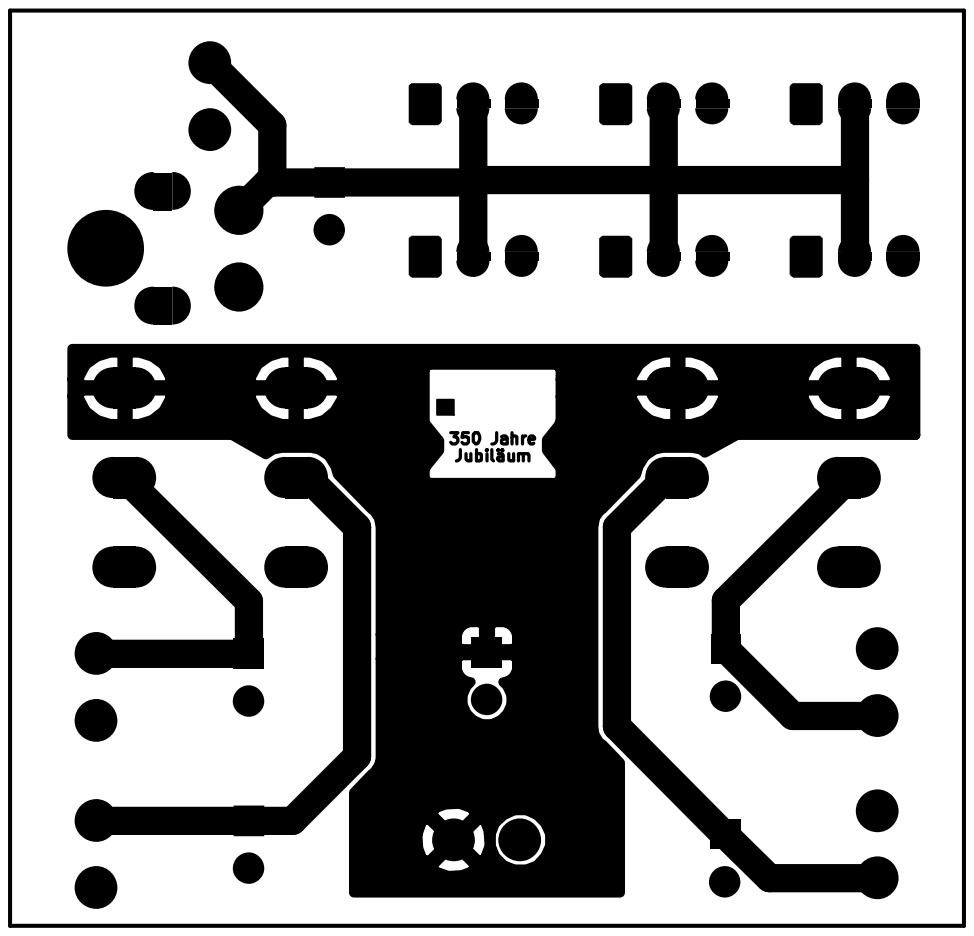
[picture p55: page 1]
