uibk-dps-teaching/cluster-coffer/docs/inc/drawing_base_plate.pdf

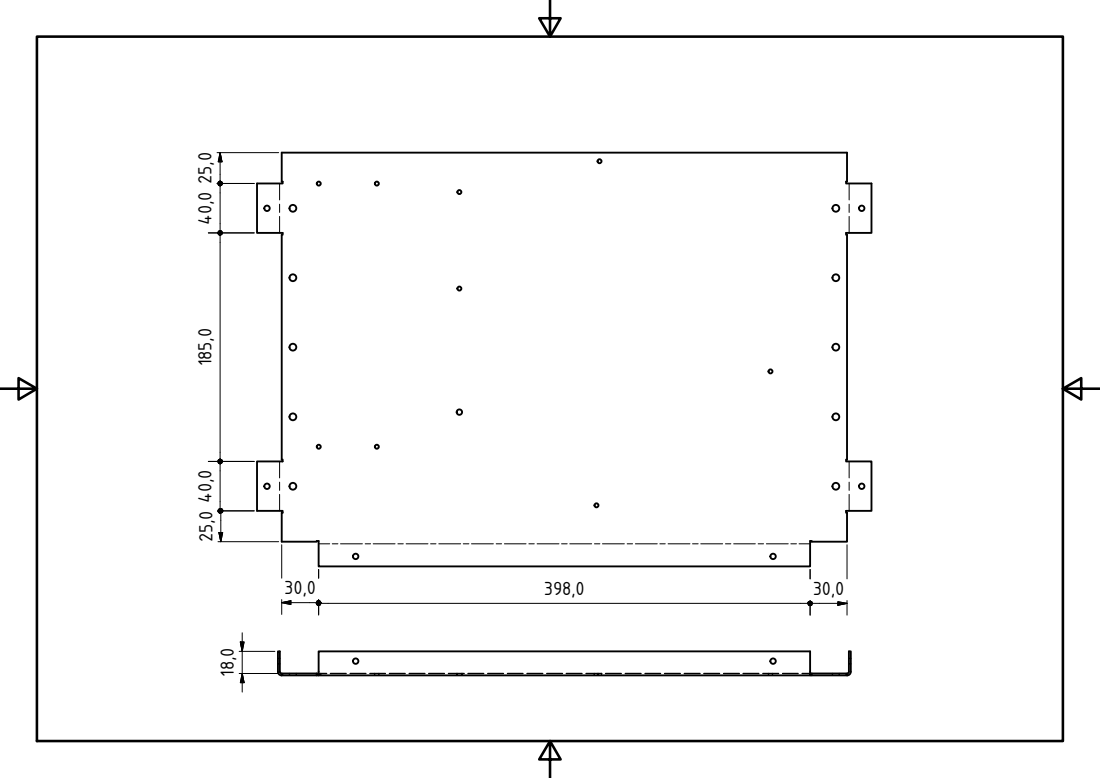
[picture p56: page 1]

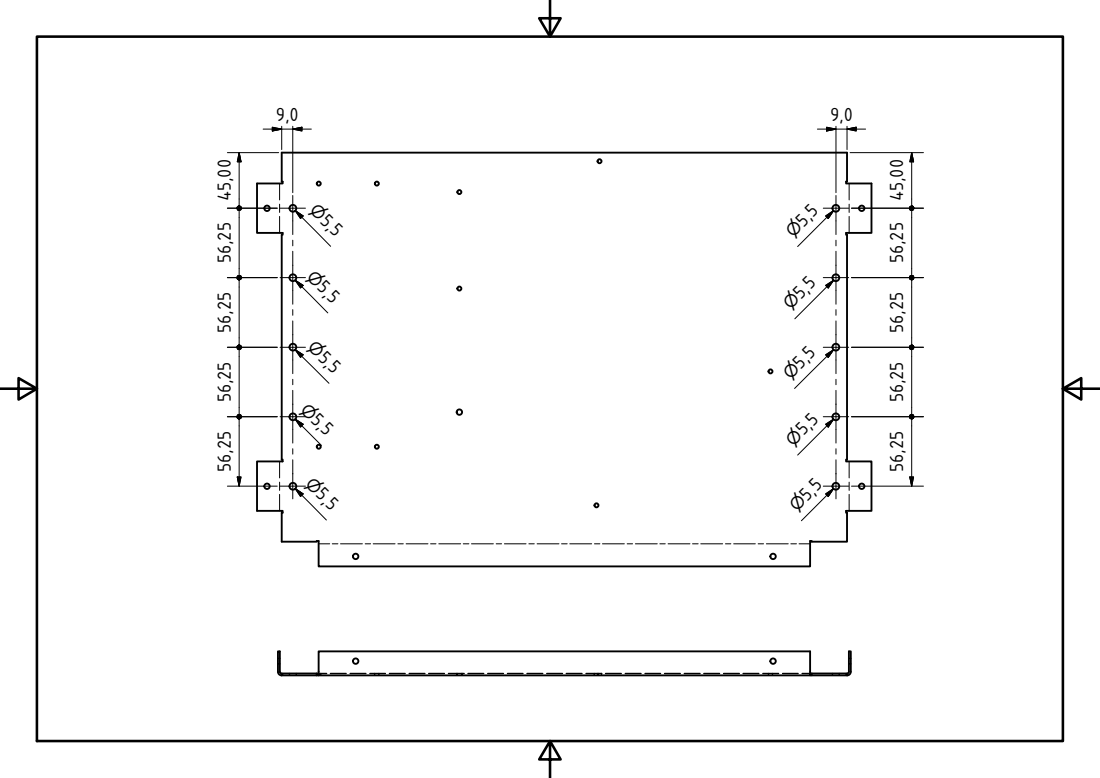
[picture p57: page 2]

0,0P4,5

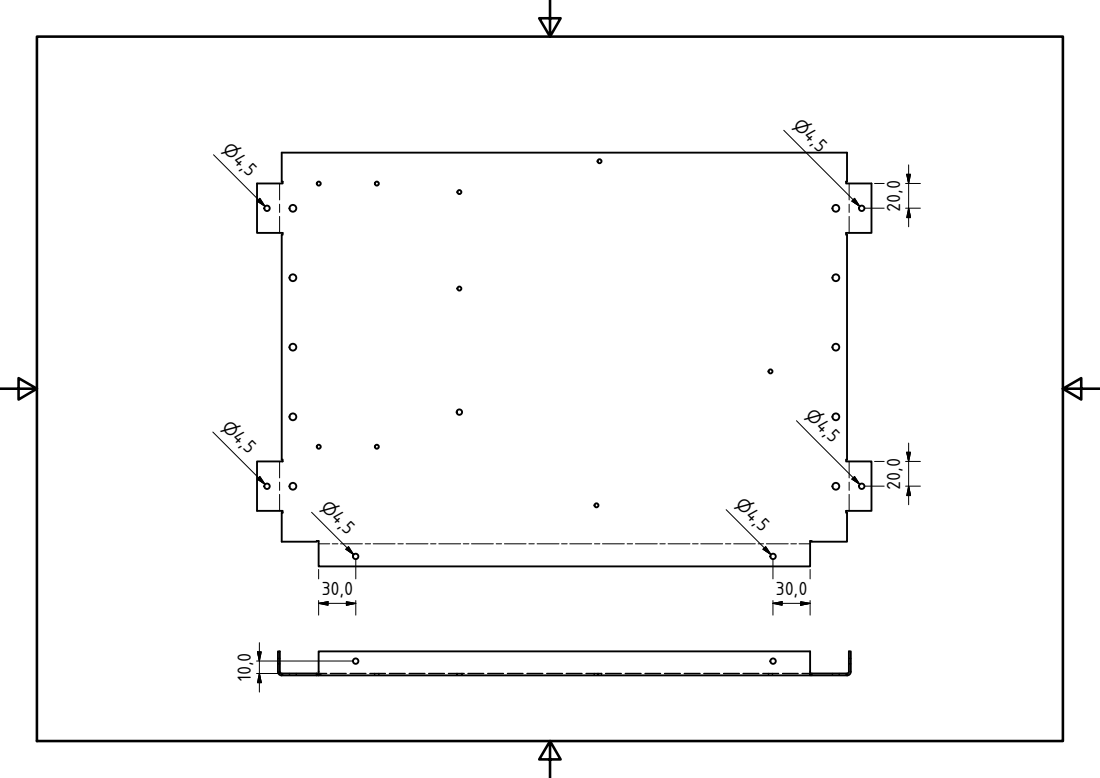
[picture p58: page 3]

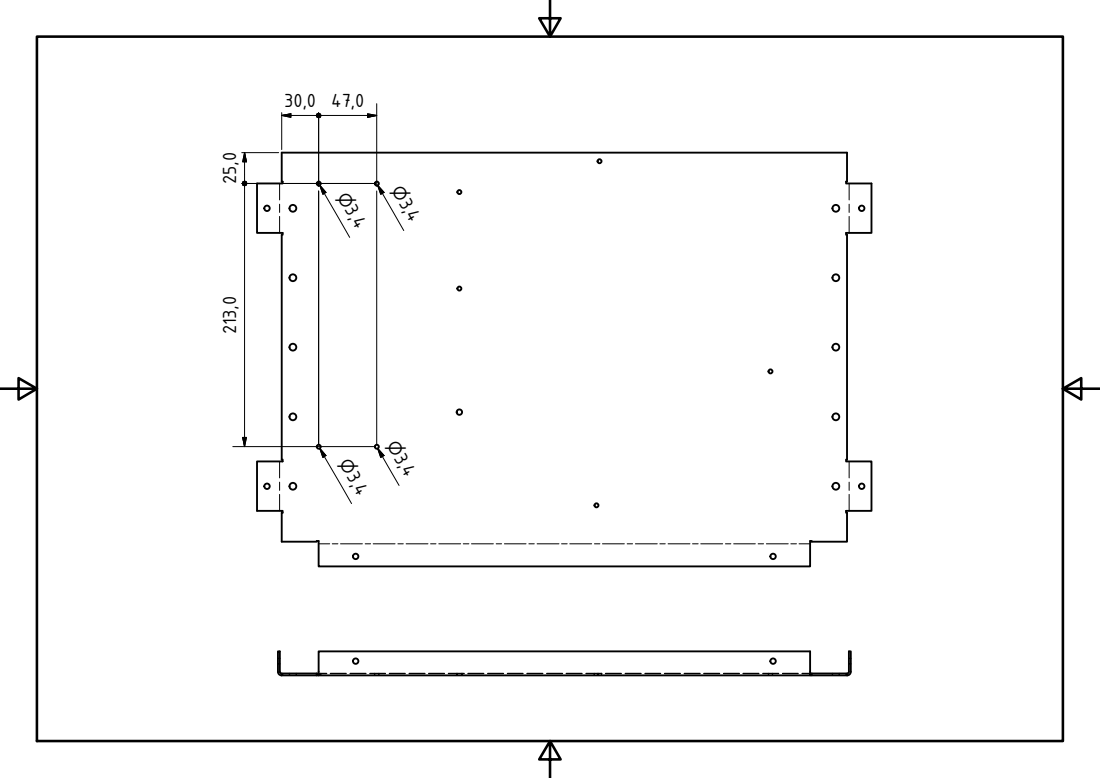
[picture p59: page 4]

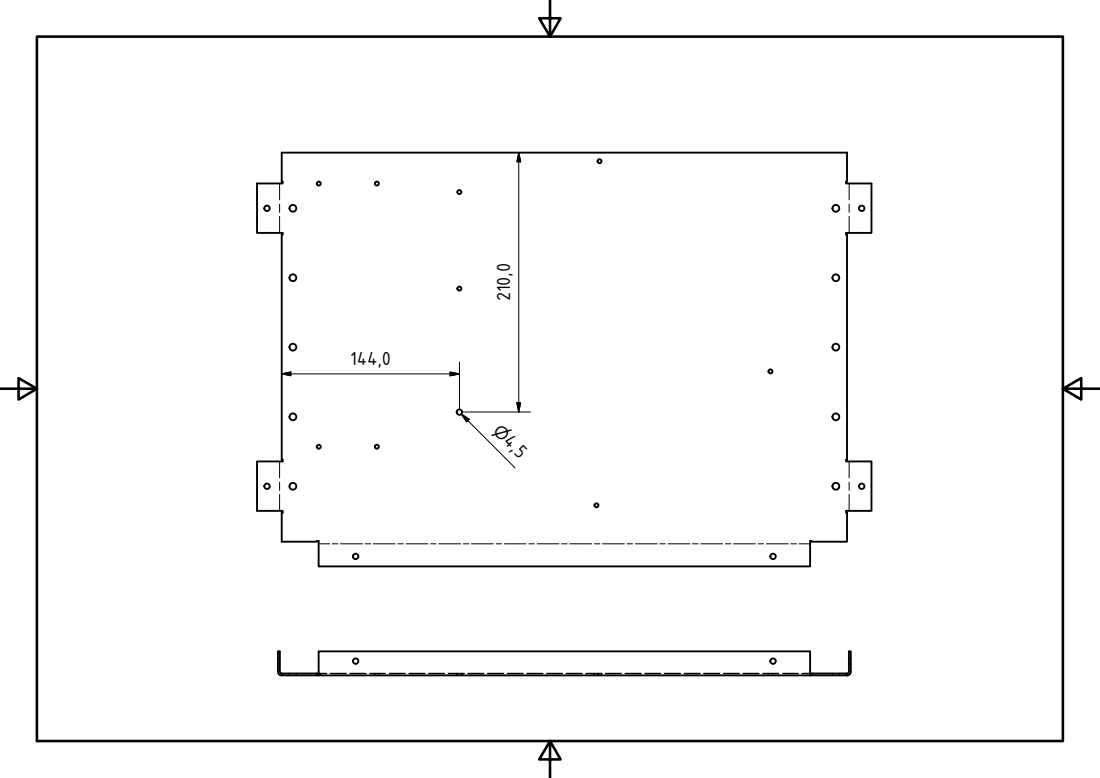
[picture p60: page 5]

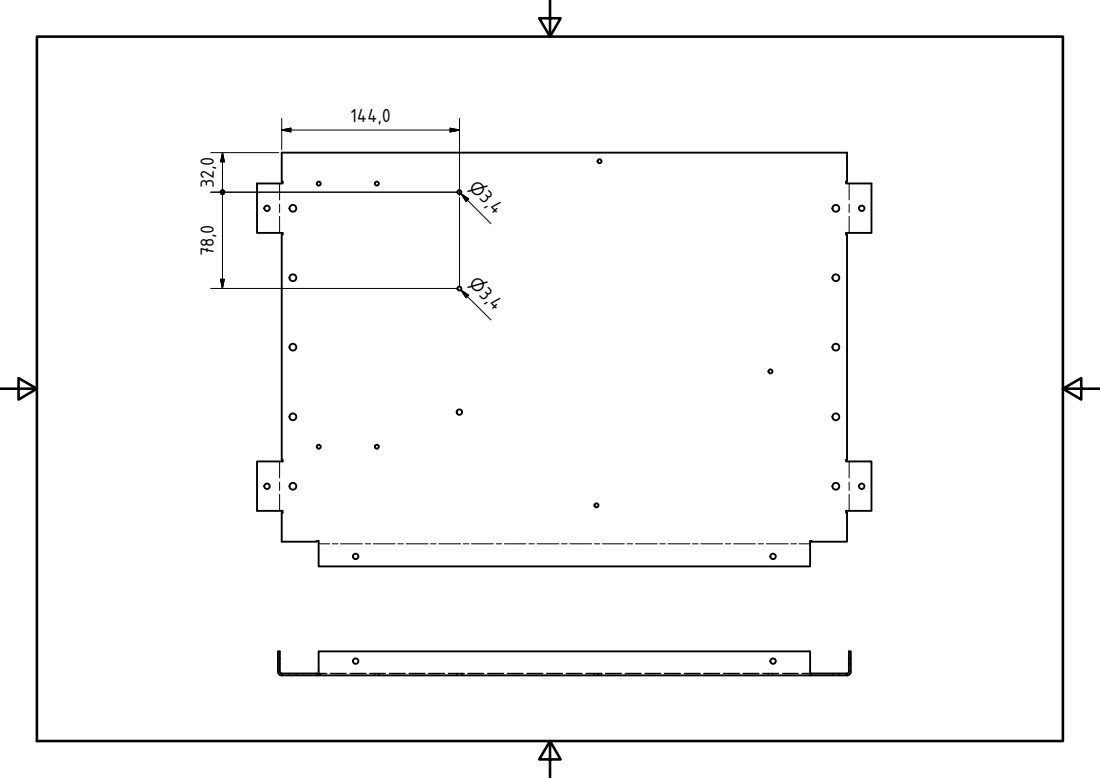
[picture p61: page 6]

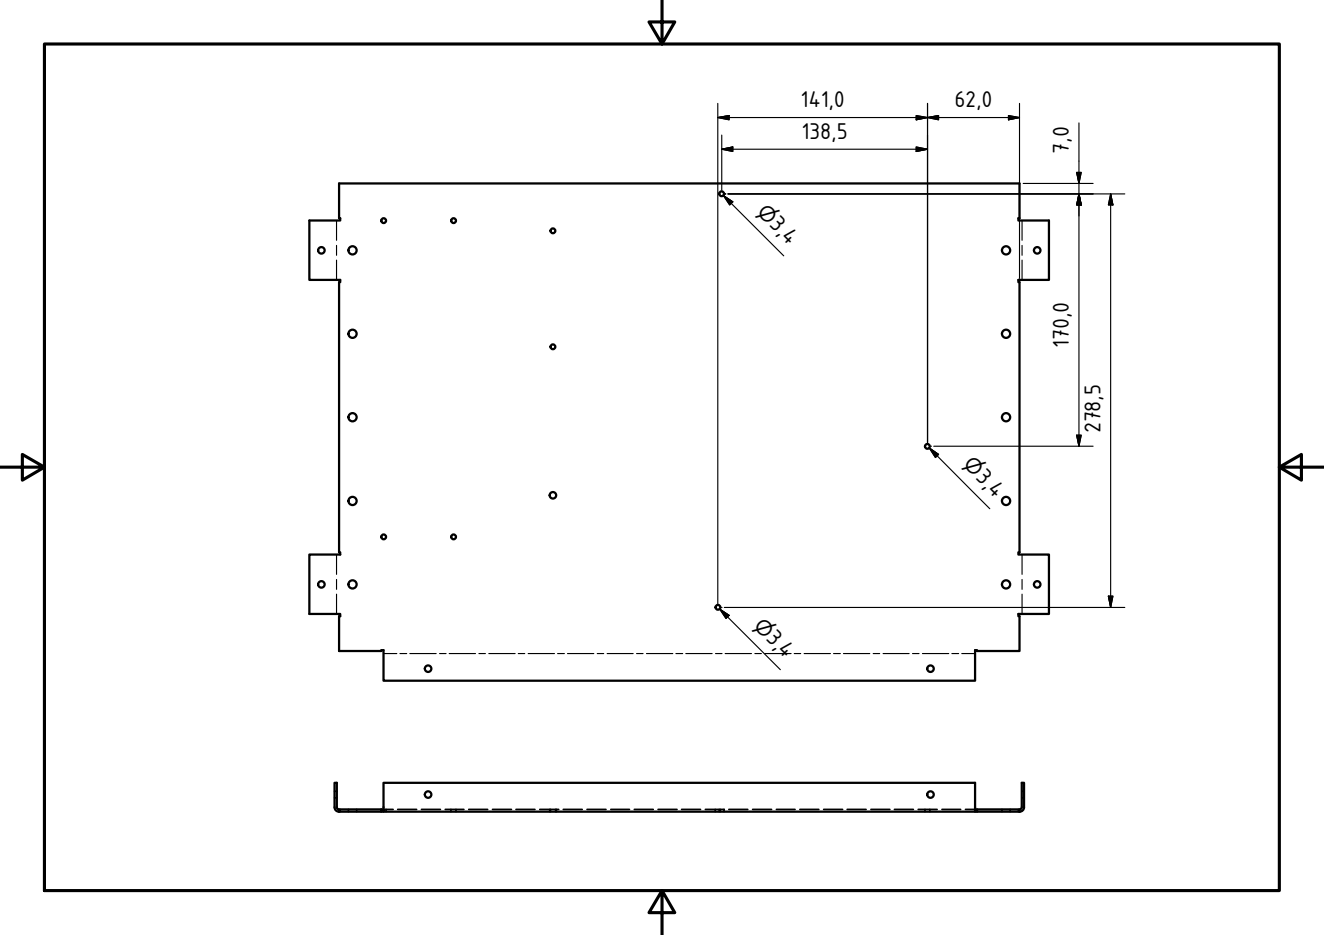
[picture p62: page 7]
