uibk-dps-teaching/cluster-coffer/docs/inc/drawing_frame.pdf

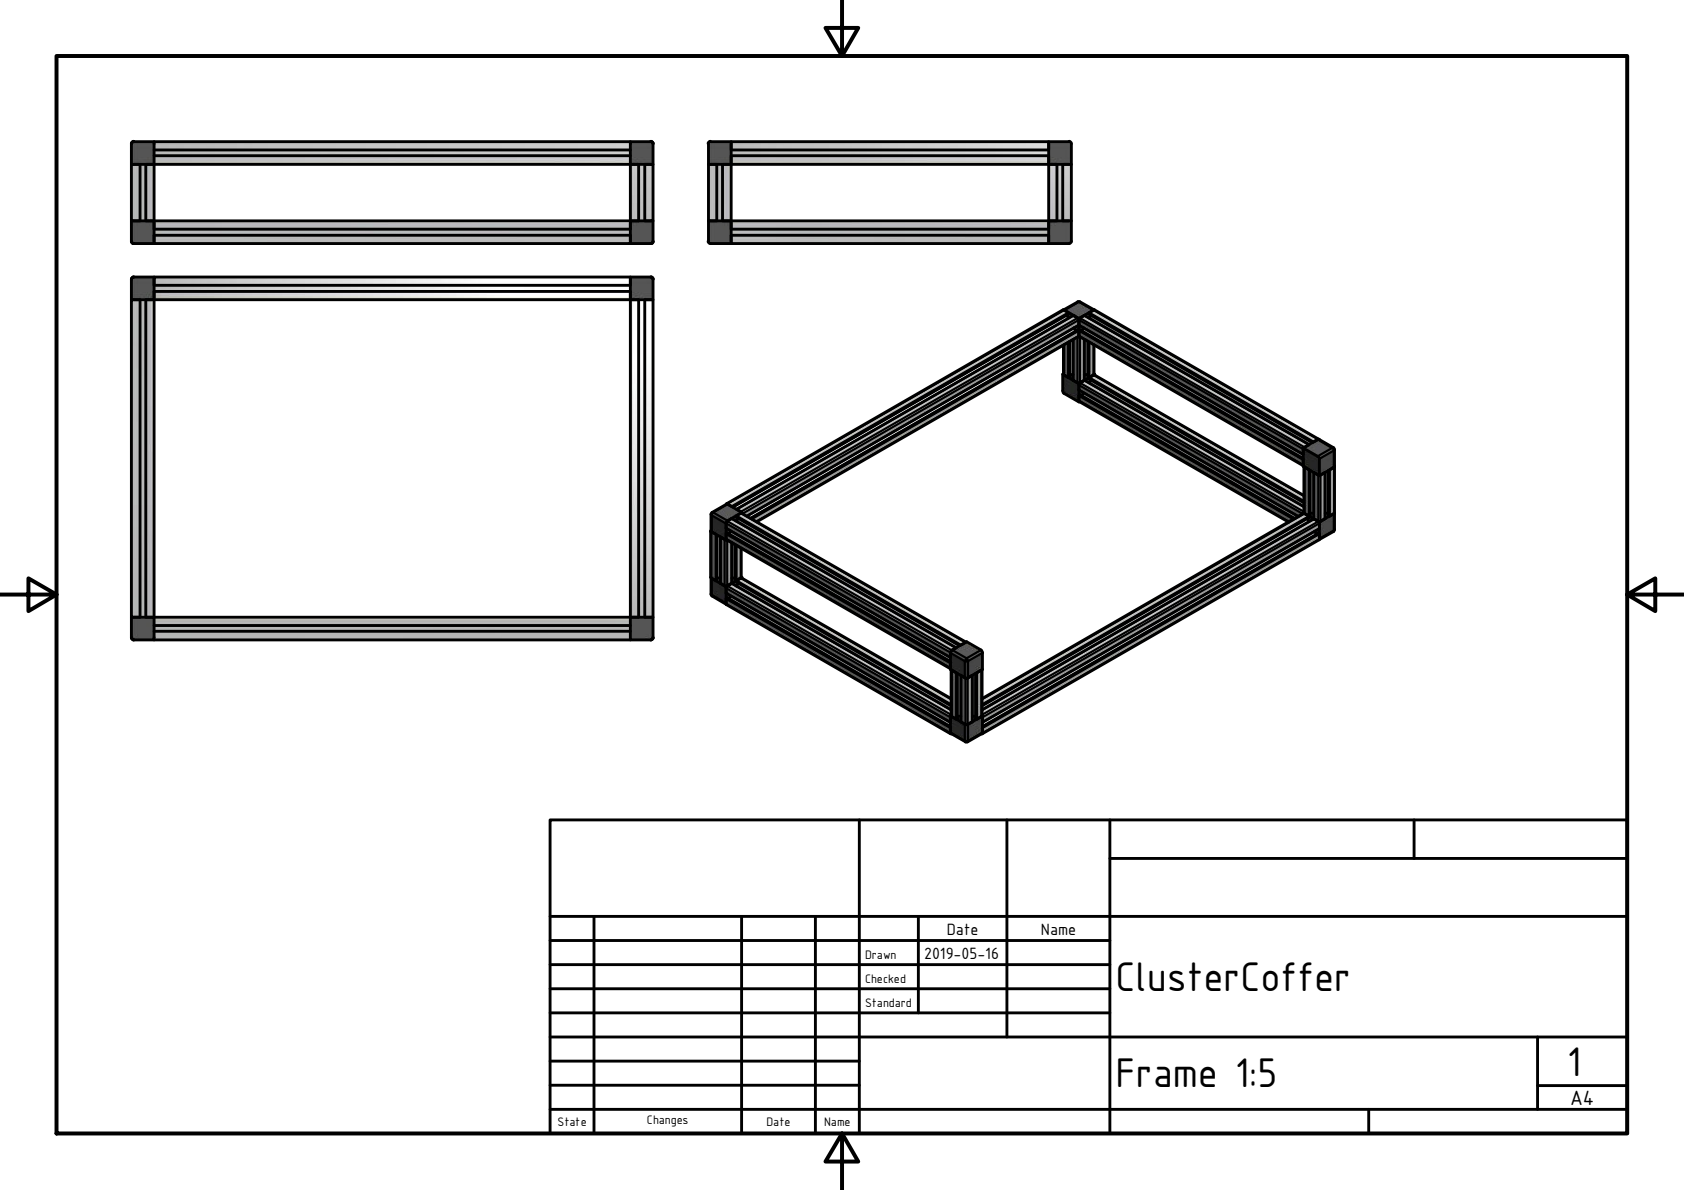
[picture p63: page 1]
