uibk-dps-teaching/cluster-coffer/docs/inc/drawing_v_mount.pdf

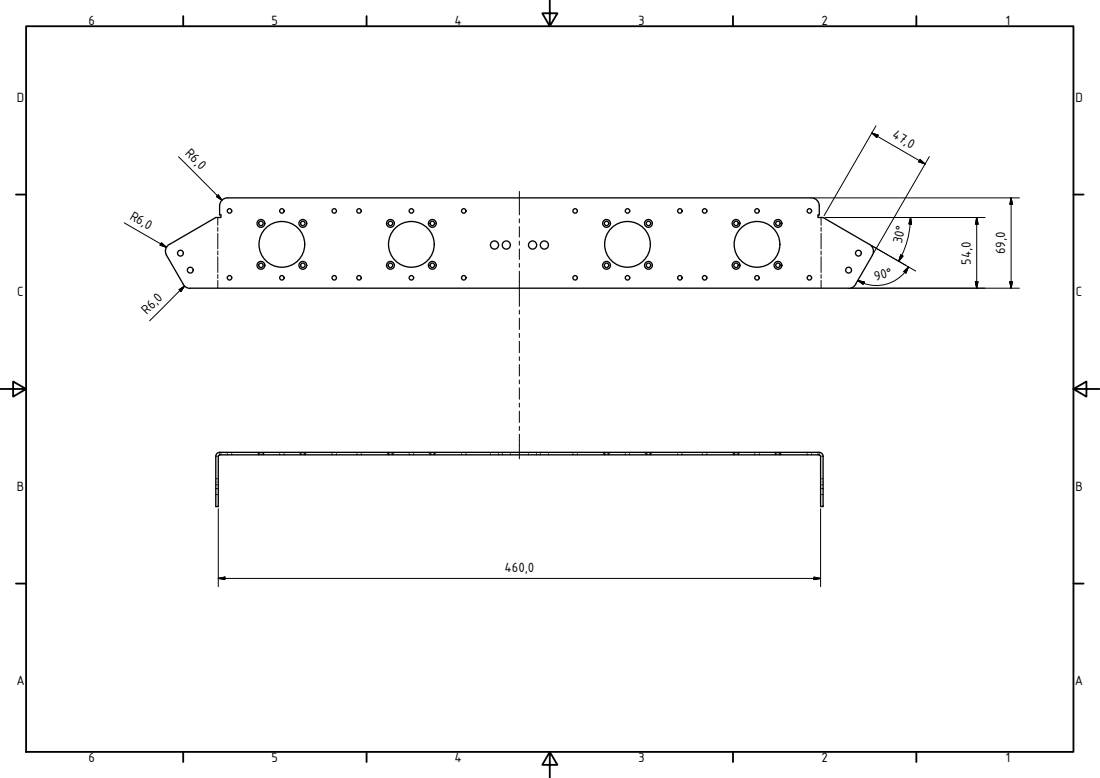
[picture p64: page 1]

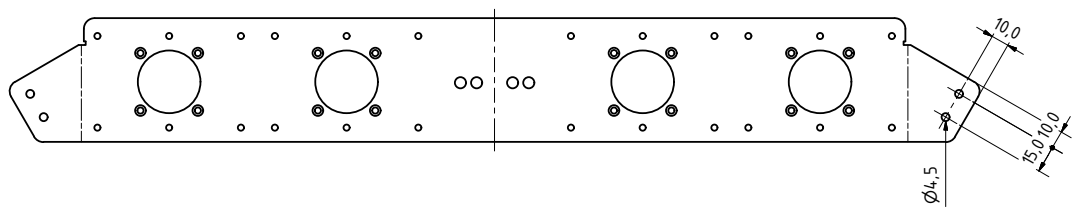
[picture p65: page 2]

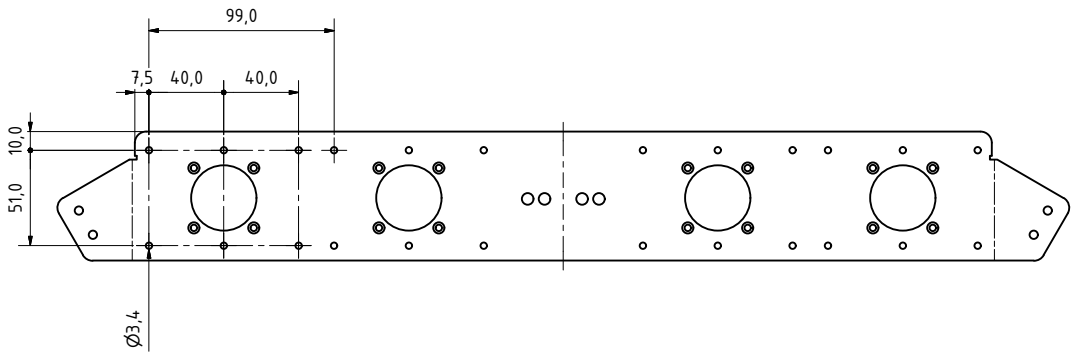
[picture p66: page 3]

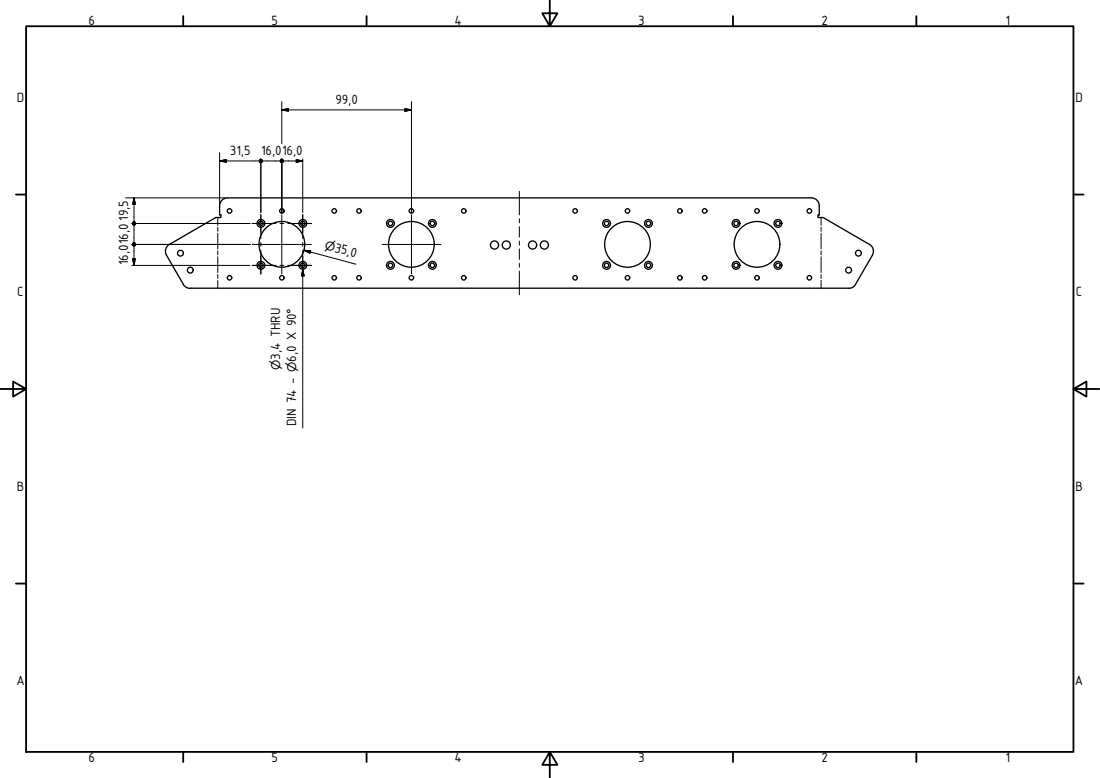
[picture p67: page 4]
P3,4 THRU DIN 74 - P6,0 X 90n

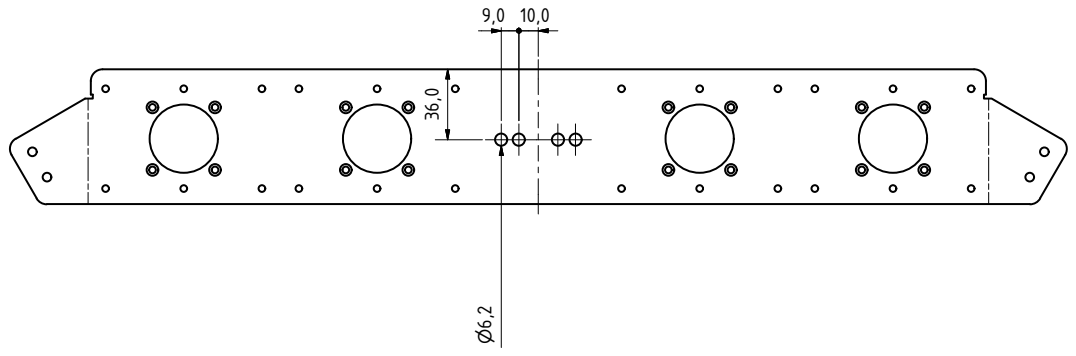
[picture p68: page 5]
