uibk-dps-teaching/cluster-coffer/electronics/ccpdu/ccpdu.kicad_pcb

## KiCad design electronics/ccpdu/ccpdu.kicad_pcb (2020-08-14)

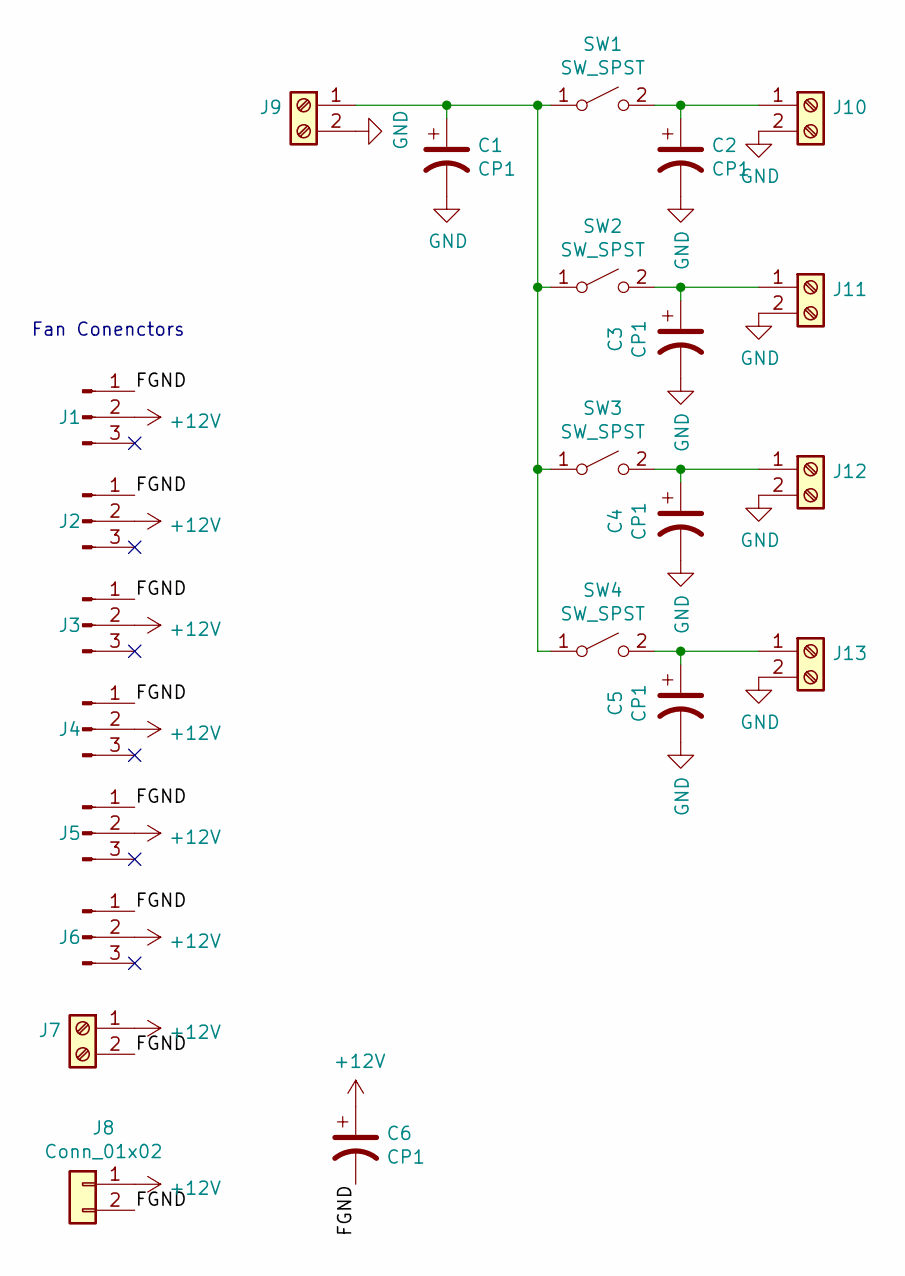
[picture p69: schematic ccpdu.sch]

Parts:
C1, C2, C3, C4, C5, C6: CP1; CP_Radial_D5.0mm_P2.50mm; DigikeyPN 493-12902-1-ND
J1, J2, J3, J4, J5, J6: Conn_01x03_Male; Molex_KK-254_AE-6410-03A_1x03_P2.54mm_Vertical; DigikeyPN WM2701-ND
J7, J9, J10, J11, J12, J13: Screw_Terminal_01x02; 284391-2; DigikeyPN A98159-ND
J8: Conn_01x02; HTLCONN_01x02
SW1, SW2, SW3, SW4: SW_SPST; RS-448-0747

Connections:
+12V: C6.1, J1.2, J2.2, J3.2, J4.2, J5.2, J6.2, J7.1, J8.1
/FGND: C6.2, J1.1, J2.1, J3.1, J4.1, J5.1, J6.1, J7.2, J8.2
GND: C1.2, C2.2, C3.2, C4.2, C5.2, J9.2, J10.2, J11.2, J12.2, J13.2
unnamed: C1.1, J9.1, SW1.1 (A), SW2.1 (A), SW3.1 (A), SW4.1 (A)
unnamed: C2.1, J10.1, SW1.2 (B)
unnamed: C3.1, J11.1, SW2.2 (B)
unnamed: C4.1, J12.1, SW3.2 (B)
unnamed: C5.1, J13.1, SW4.2 (B)

Notes on the sheet:
Fan Conenctors

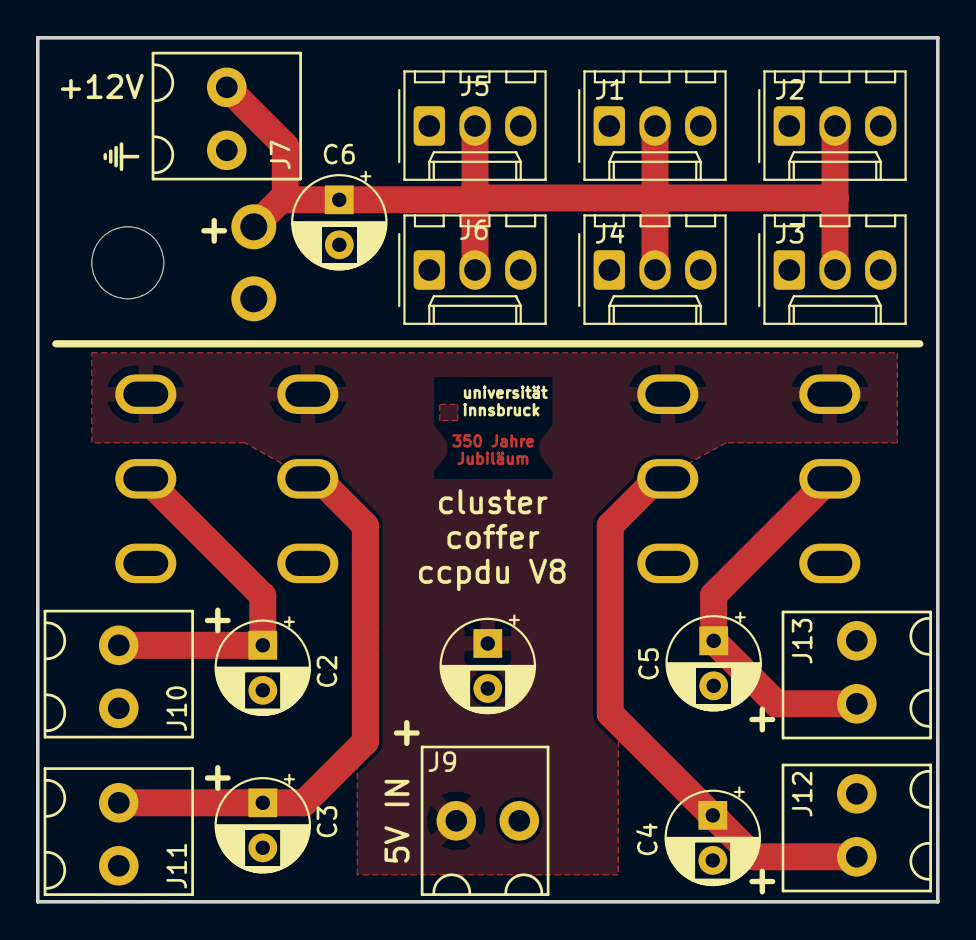
[picture p70: board ccpdu.kicad_pcb from above]

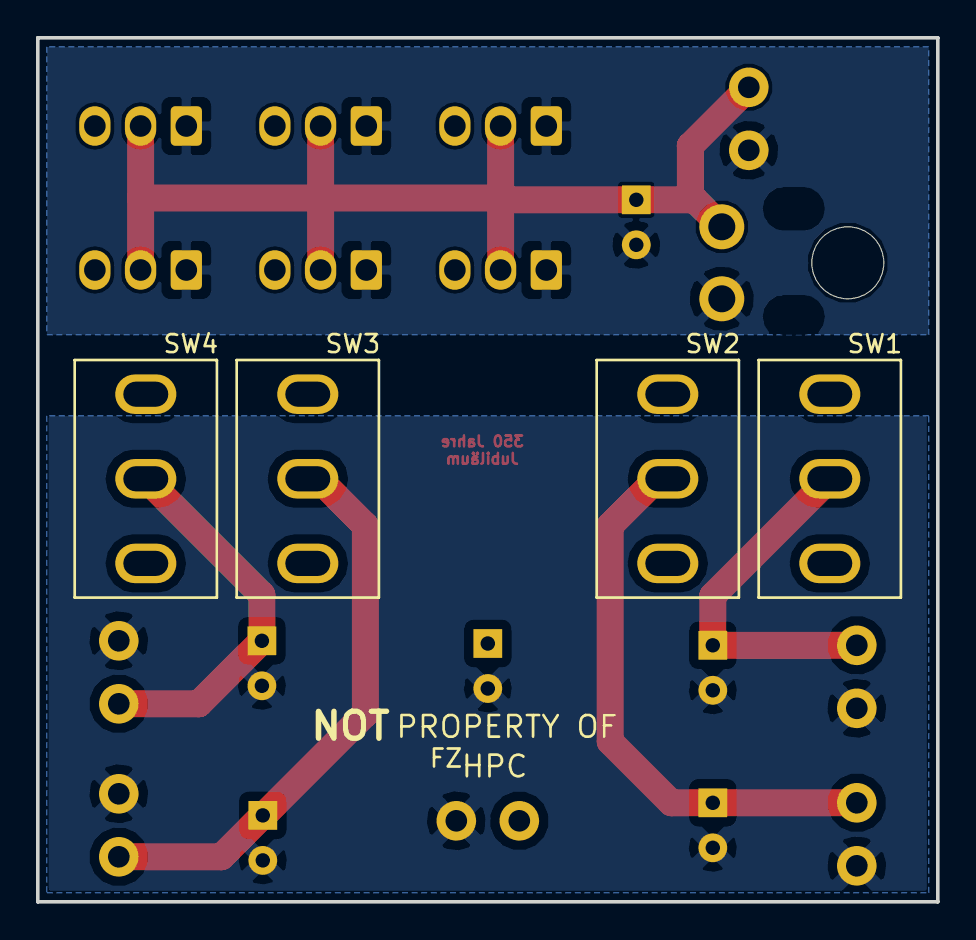
[picture p71: board ccpdu.kicad_pcb from below]

Board: 2 copper layers, 50.0 x 48.0 mm, 23 parts (4 on the bottom side), 8 nets.
