uibk-dps-teaching/cluster-coffer/electronics/ccpad/ccpad.kicad_pcb

## KiCad design electronics/ccpad/ccpad.kicad_pcb (2020-08-14)

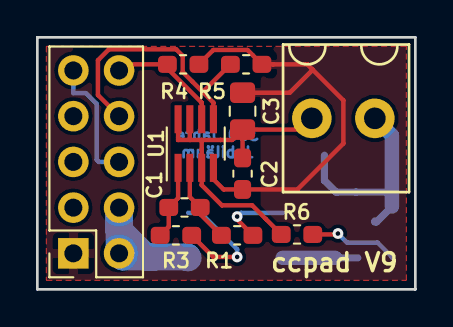
[picture p72: board ccpad.kicad_pcb from above]

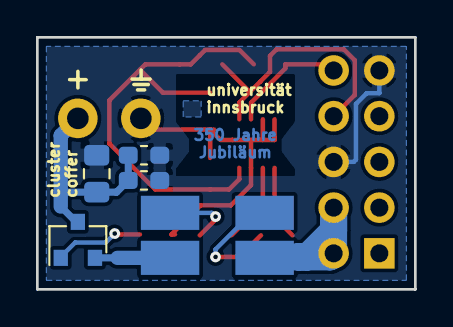
[picture p73: board ccpad.kicad_pcb from below]

Board: 2 copper layers, 21.0 x 14.0 mm, 16 parts (5 on the bottom side), 12 nets.

Parts:
C1: C_Small; C_0603_1608Metric_Pad1.05x0.95mm_HandSolder
C2: 470n; C_0603_1608Metric_Pad1.05x0.95mm_HandSolder
C3: 100n; C_0805_2012Metric_Pad1.15x1.40mm_HandSolder
C4, C5: C; C_0603_1608Metric_Pad1.05x0.95mm_HandSolder
C6: C; C_0805_2012Metric_Pad1.15x1.40mm_HandSolder
J1: Conn_02x05_Odd_Even; PinSocket_2x05_P2.54mm_Vertical
J2: Screw_Terminal_01x02; 284391-2
Q1: Q_PMOS_GSD; SOT-23
R1, R3, R4, R5: R; R_0603_1608Metric_Pad1.05x0.95mm_HandSolder
R2: 10m; LVK24
R6: 100k; R_0603_1608Metric_Pad1.05x0.95mm_HandSolder
U1: INA219; SOT-23-8_Handsoldering

Connections:
+5V: C4.1, C5.1, C6.1, J2.1, Q1.3
/M4_3V3: C2.1, C3.1, J1.1, R4.1, R5.1, U1.4
/M4_5V: J1.2, J1.4, R2.1
/M4_I2C3_SCL: J1.8, R5.2, U1.5
/M4_I2C3_SDA: J1.10, R4.2, U1.6
GND: C2.2, C3.2, C4.2, C5.2, C6.2, J1.6, J1.9, J2.2, R6.2, U1.3, U1.7, U1.8
unnamed: C1.1, R1.2, U1.2
unnamed: C1.2, R3.2, U1.1
unnamed: Q1.2, R2.4
unnamed: Q1.1, R6.1
unnamed: R1.1, R2.3
unnamed: R2.2, R3.1
